nakhonthai/ESP32IGate/doc/ESP32DR_DIY-Thai.pdf

## คู่มือประกอบวงจรชุด ESP32DR Simple

PCB Layout | ขันตอนการประกอบ ให้ทําการประกอบจากอุปกรณ์ทีตําก่อนไปหาตัวทีสูงตามลําดับดังนี

!.ประกอบตัวรีซิสเตอร์ R….
| 2.ประกอบ L Isolate หรือ จัมเปอร์ L1 3.ประกอบไดโอด D1,D2 4.ประกอบคาปาซิเตอร์ C… 5.ประกอบทรานซิสเตอร์ Q1 6.ประกอบ VR RP1,RP2 7.ประกอบแจ็คโมดูล RJ11 8.ประกอบ ESP32 ใส่เป็นขาซ๊อกเก็จแทน

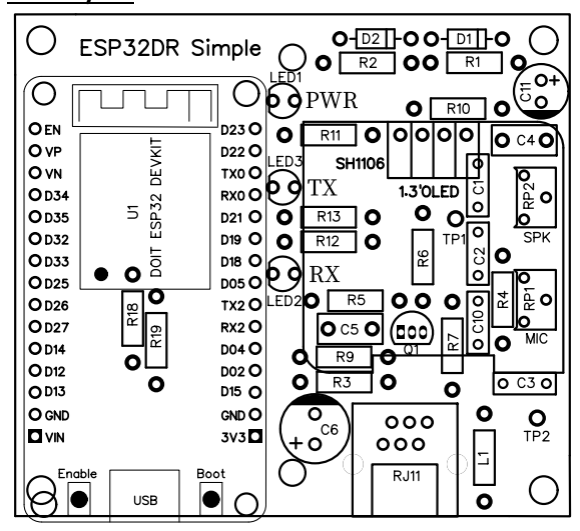
[picture p19: figure]

รายการวัสดุอุปกรณ์ประกอบวงจร(BOM)

ID | Name | Designator | Quantity
1 | DOIT ESP32 DEVKIT (โมดูล ESP32) | U1 | 1
2 | VR 3362W 1K (R ปรับค่าเสียงออก ค่าอ่าน 102) | RP2 | 1
3 | VR 3362W 10K (R ปรับค่าเสียงเข้า ค่าอ่าน 103) | RP1 | 1
4 | RJ11-6P6C (แจ๊คโมดูล RJ11 แบบ 6ขา) | RJ11 | 1
5 | R 1K 1/4W(ค่าสี: นําตาล ดํา แดง) | R13,R12,R11,R5,R3,R9 | 6
6 | R 100R 1/4W(ค่าสี: นําตาล ดํา ดํา) | R7,R18,R19 | 3
7 | R 10k 1/4W (ค่าสี: นําตาล ดํา ส้ม) | R6,R2,R1 | 3
8 | R 3k 1/4W (ค่าสี: ส้ม ดํา แดง) | R4 | 1
9 | R 33K 1/4W (ค่าสี: ส้ม ส้ม ส้ม) | R10 | 1
10 | 2N3904(TO-92) | Q1 | 1
11 | LED 3.5mm สีเหลือง แสดงส่งสัญญาณ TX | LED3 | 1
12 | LED 3.5mm สีเขียว แสดงรับสัญญาณ RX | LED2 | 1
13 | LED 3.5mm สีแดง แสดงไฟเข้าทํางาน PWR | LED1 | 1
14 | L Isolate or Jumper | L1 | 1
15 | C 100uF/16V (ตัวเก็บประจุแบบอิเล็กโทรไลติก) | C11 | 1
16 | C 100nF (ตัวเก็บประจุแบบเซรามิกมัลติเลเยอร์) | C4,C5 | 2
17 | C 470uF/16V (ตัวเก็บประจุแบบอิเล็กโทรไลติก) | C6 | 1
18 | C 0.1uF (ตัวเก็บประจุแบบโพลีโพรไพลีน) | C1,C3,C10 | 3
19 | C 10nF (ตัวเก็บประจุแบบโพลีโพรไพลีน) | C2 | 1
20 | Diode 1N4148 หรือใช้ C 10nF แทนได้ | D2,D1 | 2
*หากต่อเข้ากับวิทยุทีใช้เสียงเข้าขาไมค์ของวิทยุรับส่ง ให้เปลี | ยน R4 จาก 3K เป็น 100K
ดาวน์โหลดซอร ์สโค๊ดสําหรับการแก้ไขและพัฒนาได้ทีลิ$ งค์ https://github.com/nakhonthai/ESP32IGate ดาวน์โหลดเฟิ ร ์มแวร ์เวอร ์ชั$นสมบูรณ์ได้ทีลิ$ งค์ https://github.com/nakhonthai/ESP32IGate/releases การตังค่า เชื$อมต่อไวไฟ SSID: ESP32IGate รหัสผ่าน aprsthnetwork เข้าเว็บคอนฟิ กซ์ด้วยไอพี http://192.168.4.1

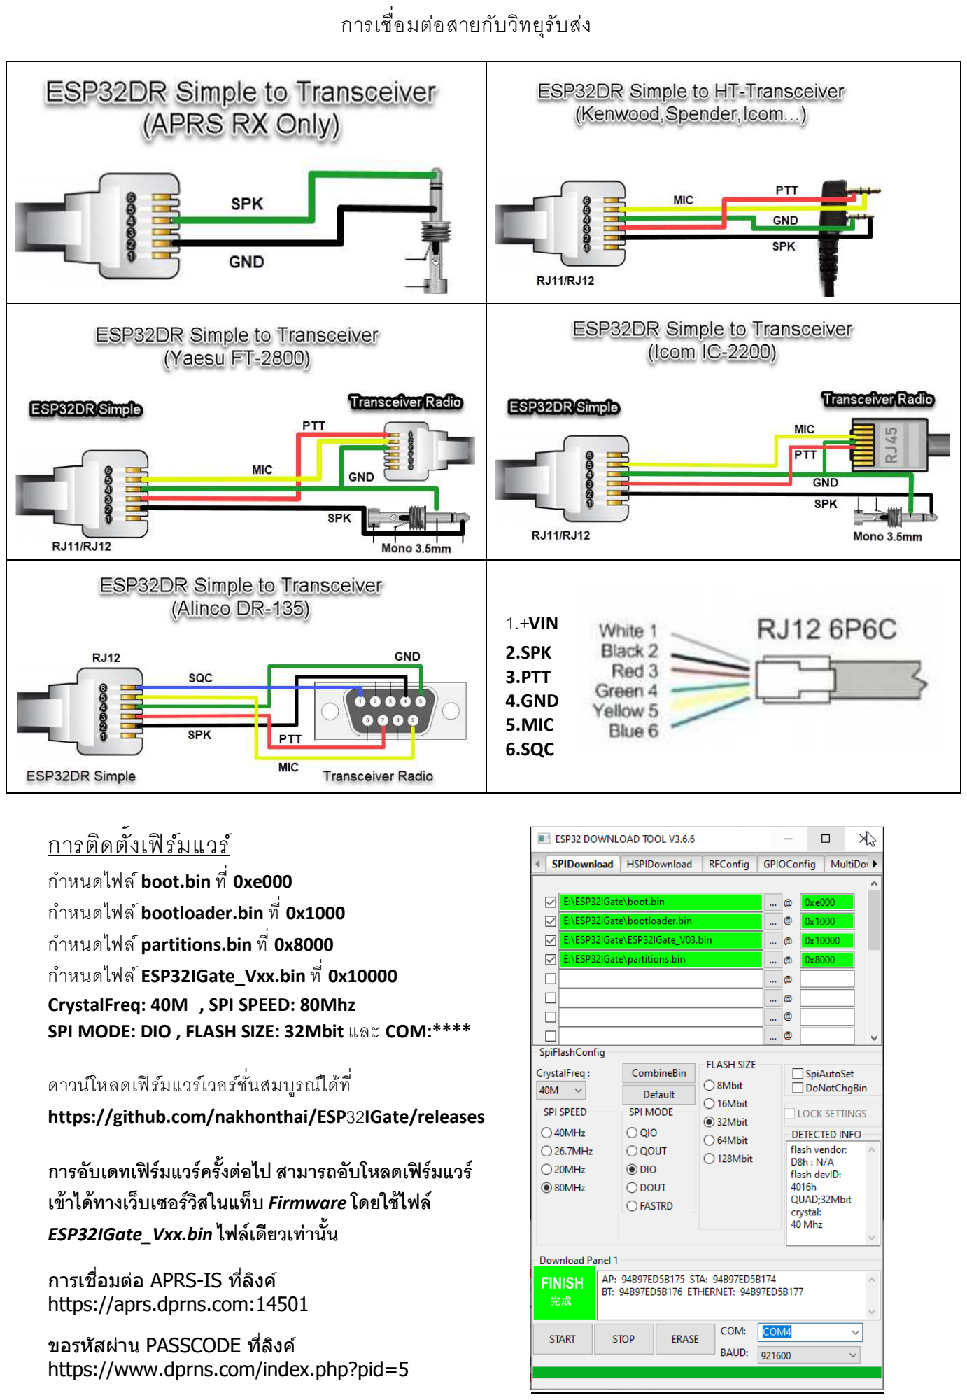
[picture p20: page 2]

การเชื$อมต่อสายกับวิทยุรับส่ง

1.+VIN

2.SPK
3.PTT
4.GND
5.MIC
6.SQC

### การติดตังเฟิ ร ์มแวร ์

กําหนดไฟล์ boot.bin ที$ 0xe000 กําหนดไฟล์ bootloader.bin ที$ 0x1000

กําหนดไฟล์ partitions.bin ที$ 0x8000

กําหนดไฟล์ ESP32IGate_Vxx.bin ที$ 0x10000

CrystalFreq: 40M , SPI SPEED: 80Mhz
SPI MODE: DIO , FLASH SIZE: 32Mbit และ COM:****

ดาวน์โหลดเฟิ ร ์มแวร ์เวอร ์ชั$นสมบูรณ์ได้ที$

https://github.com/nakhonthai/ESP32IGate/releases

การอับเดทเฟิ ร์มแวร์ครังต่อไป สามารถอับโหลดเฟิ ร์มแวร์ เข้าได้ทางเว็บเซอร์วิสในแท็บ Firmware โดยใช้ไฟล์

ESP32IGate_Vxx.bin ไฟล์เดียวเท่านัน

การเชอมต่อ APRS-IS ทีลิงค์ ื https://aprs.dprns.com:14501

ขอรหัสผ่าน PASSCODE ทีลิงค์ https://www.dprns.com/index.php?pid=5
