nakhonthai/ESP32IGate/doc/ESP32DR_SA868/ESP32DR_Harmonics.png

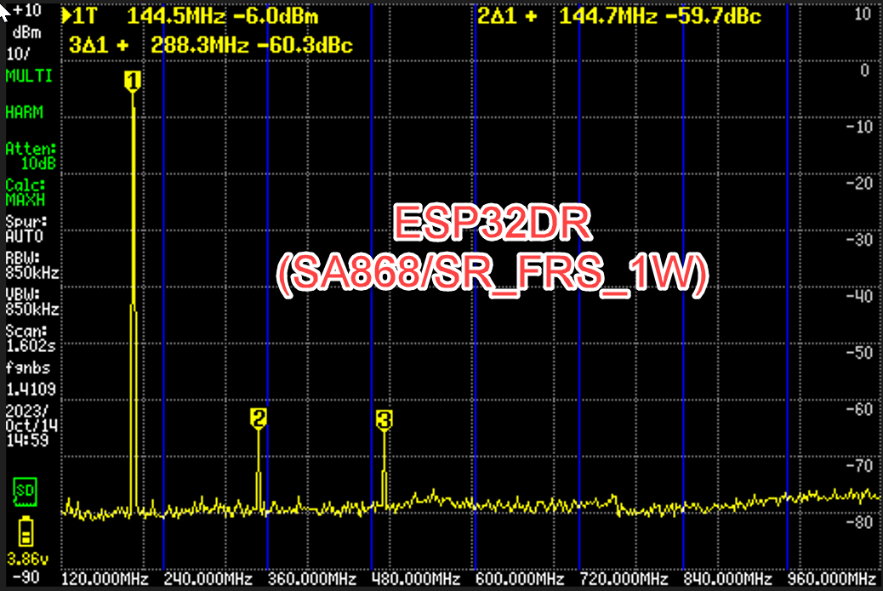
doc/ESP32DR_SA868/ESP32DR_Harmonics.png
