nakhonthai/ESP32IGate/doc/ESP32DR_SA868/ESP32DR_SA868.jpg

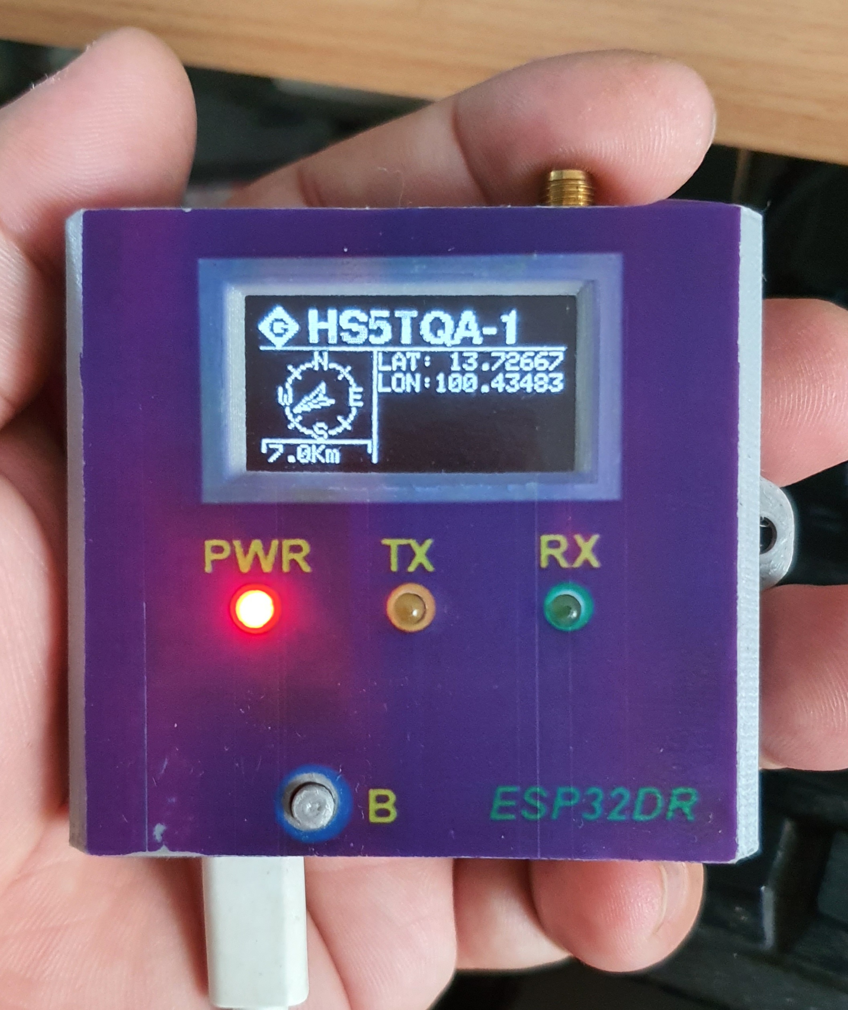
doc/ESP32DR_SA868/ESP32DR_SA868.jpg
