nakhonthai/ESP32IGate/image/Alinco_Pinout.png

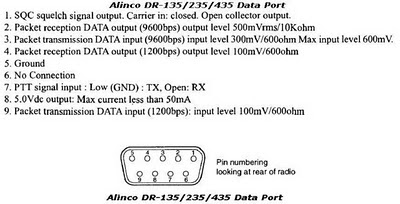
image/Alinco_Pinout.png
