nakhonthai/ESP32IGate/image/ESP32IGate_GNSS.jpg

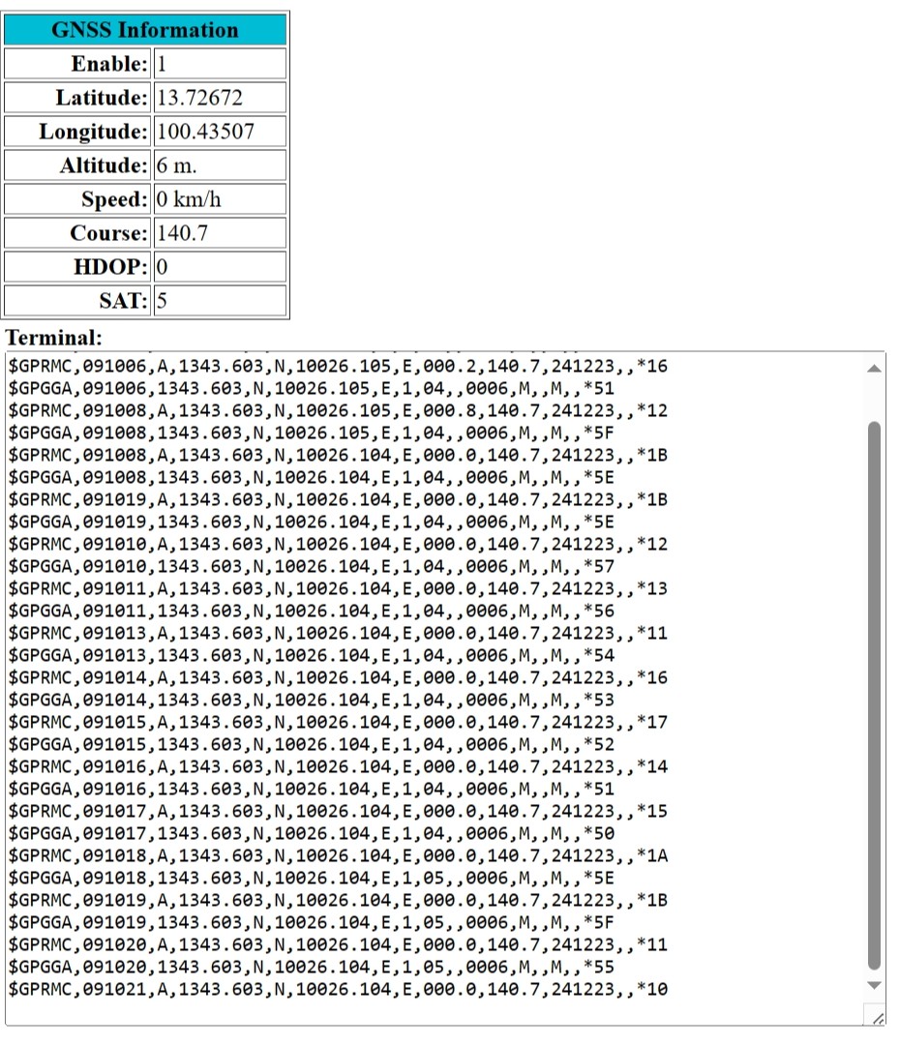
image/ESP32IGate_GNSS.jpg
