nakhonthai/ESP32IGate/image/ESP32IGate_gnss_connection.png

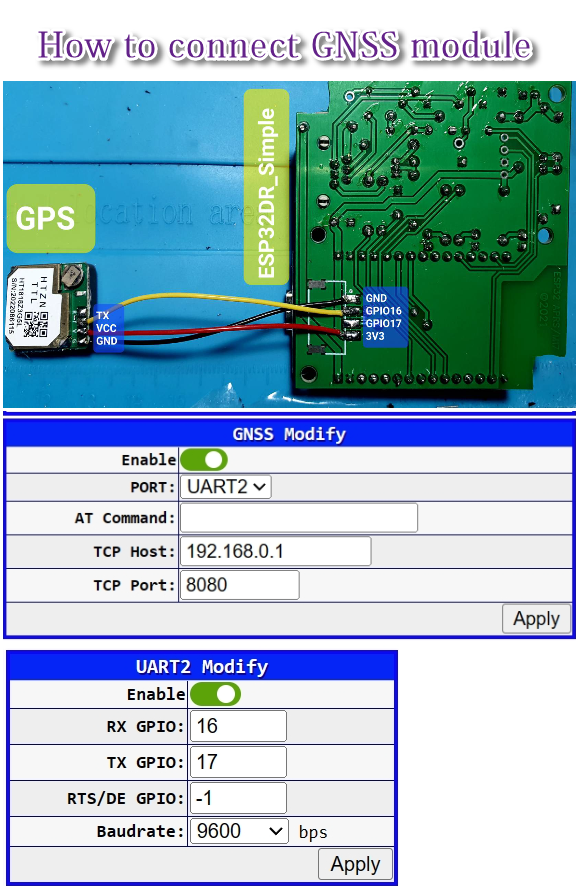
image/ESP32IGate_gnss_connection.png
