nakhonthai/ESP32IGate/image/ESP32IGate_gnss_tcp.png

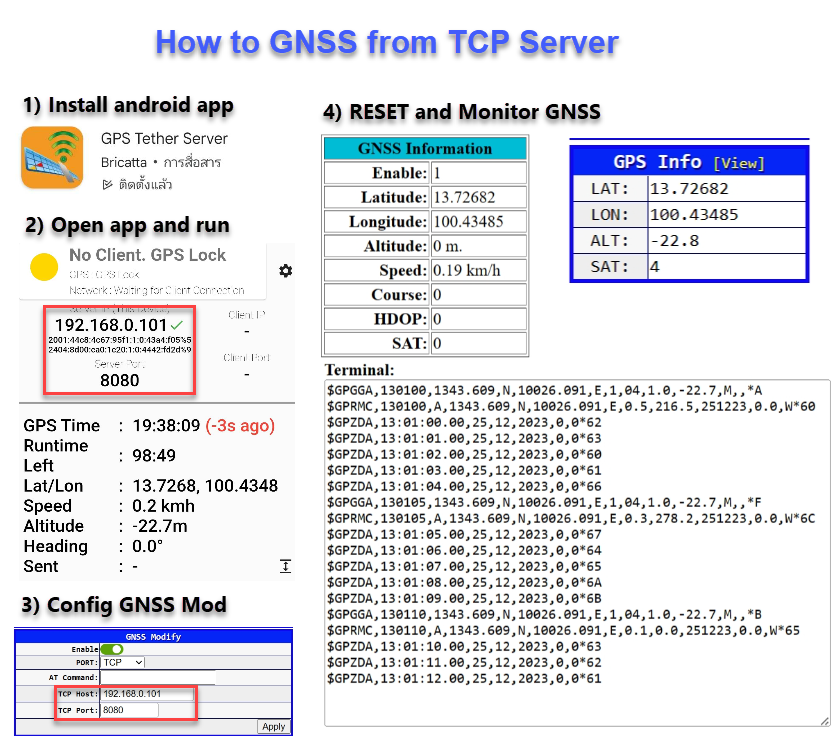
image/ESP32IGate_gnss_tcp.png
