nakhonthai/ESP32IGate/image/ESP32IGATE_SA818_3D.png

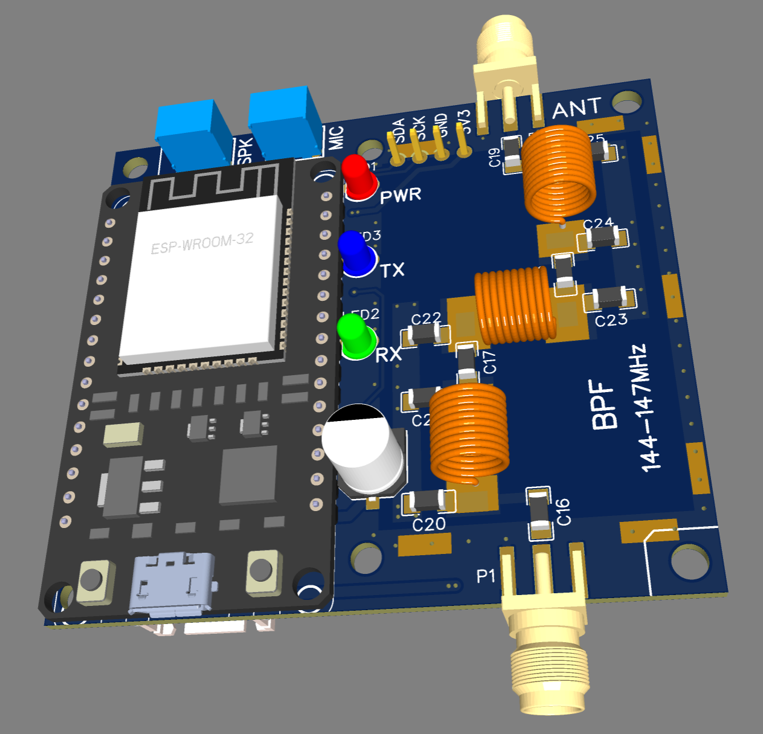
image/ESP32IGATE_SA818_3D.png
