nakhonthai/ESP32IGate/image/ESP32IGate_Screen_about.png

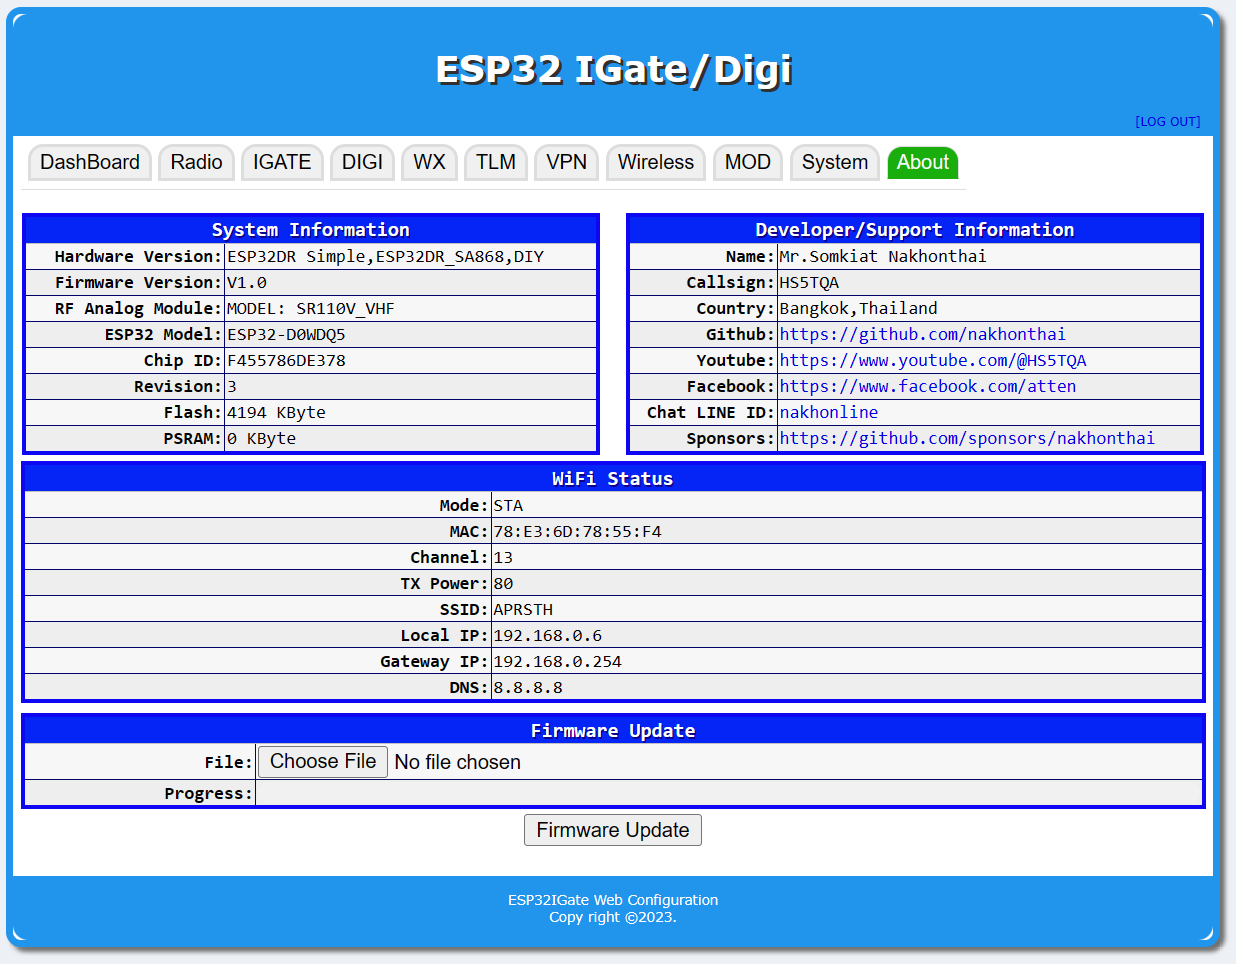
image/ESP32IGate_Screen_about.png
