nakhonthai/ESP32IGate/image/ESP32IGate_Screen_digi.png

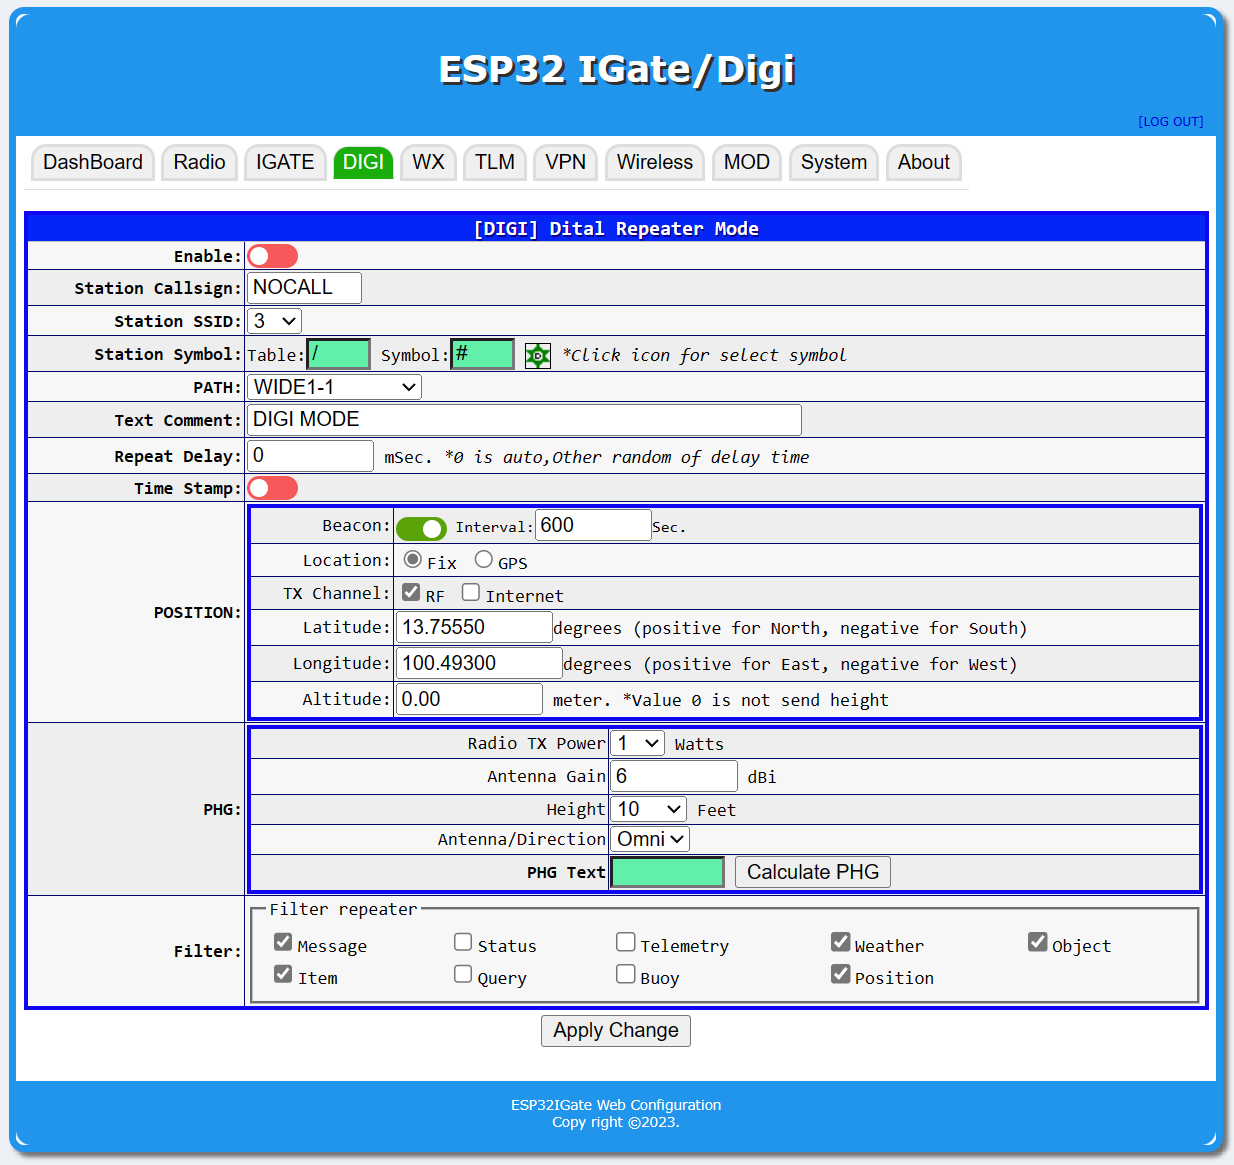
image/ESP32IGate_Screen_digi.png
