nakhonthai/ESP32IGate/image/ESP32IGate_Screen_system.png

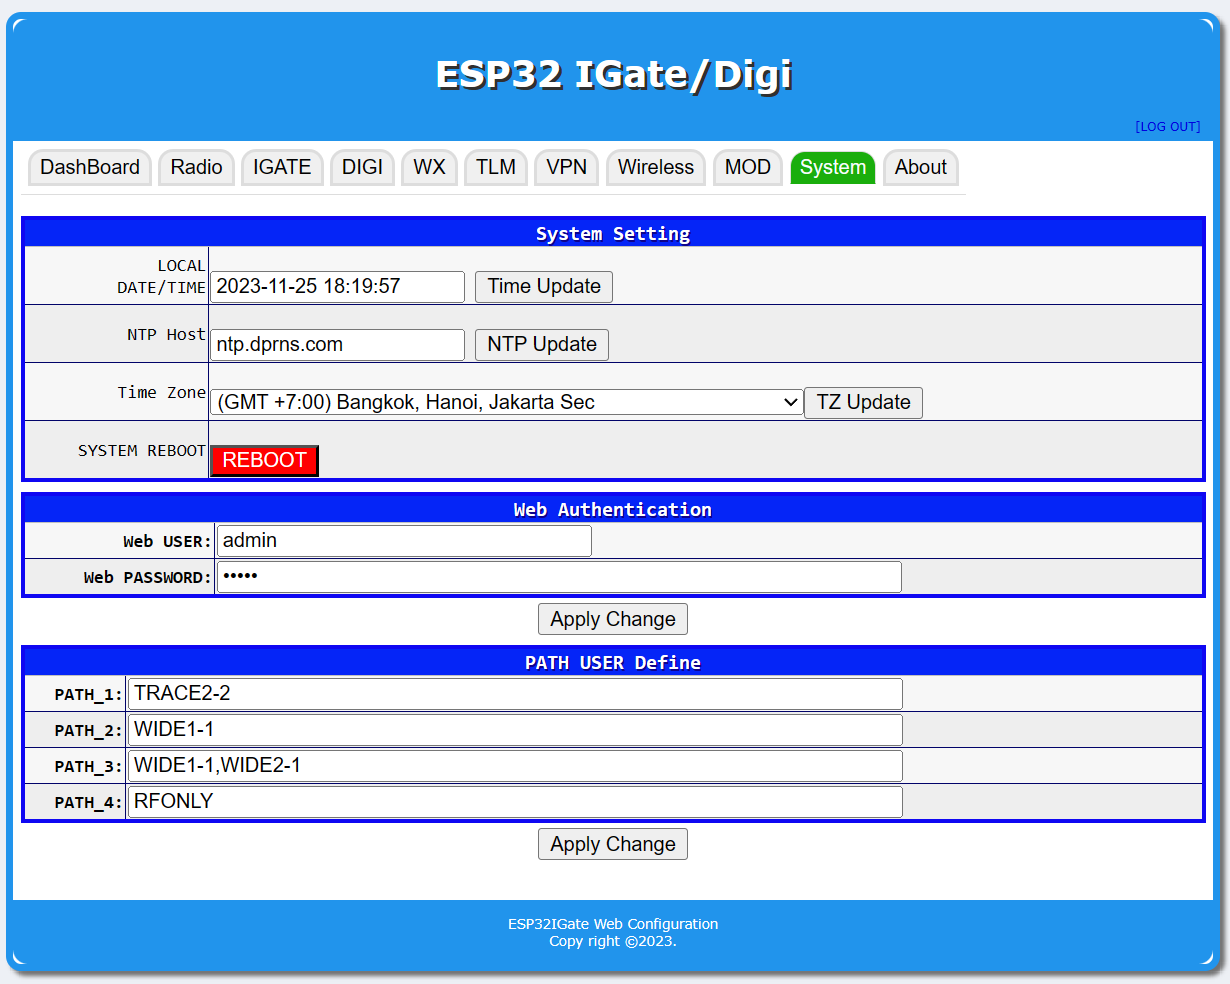
image/ESP32IGate_Screen_system.png
