nakhonthai/ESP32IGate/image/ESP32IGate_Screen_tlm.png

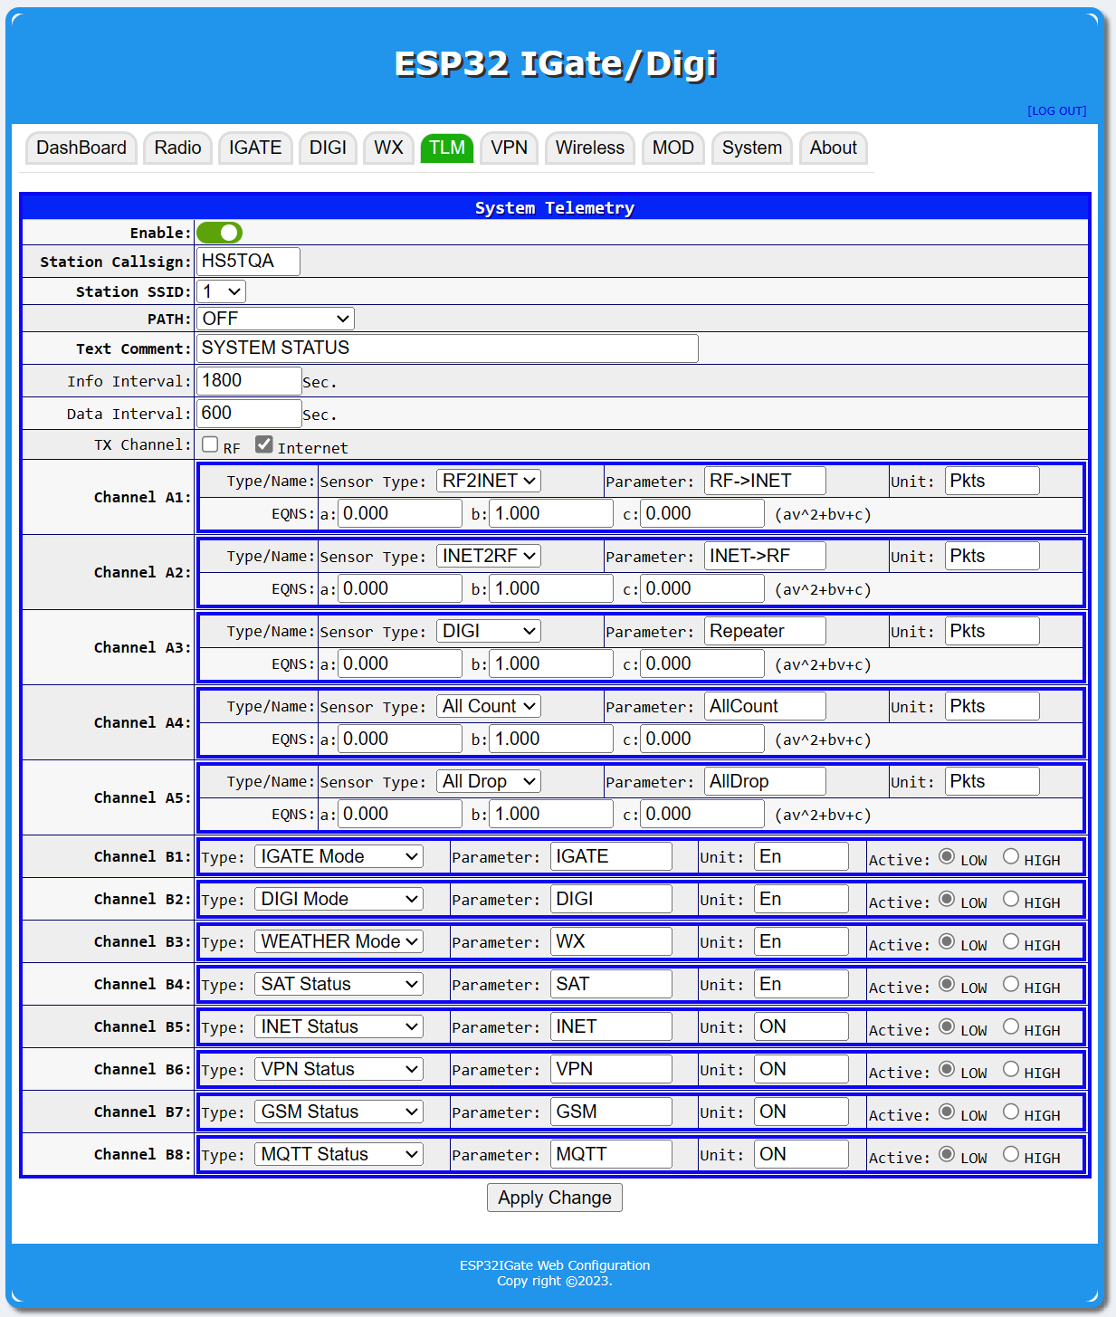
image/ESP32IGate_Screen_tlm.png
