nakhonthai/ESP32IGate/image/ESP32IGate_Screen_tnc2.png

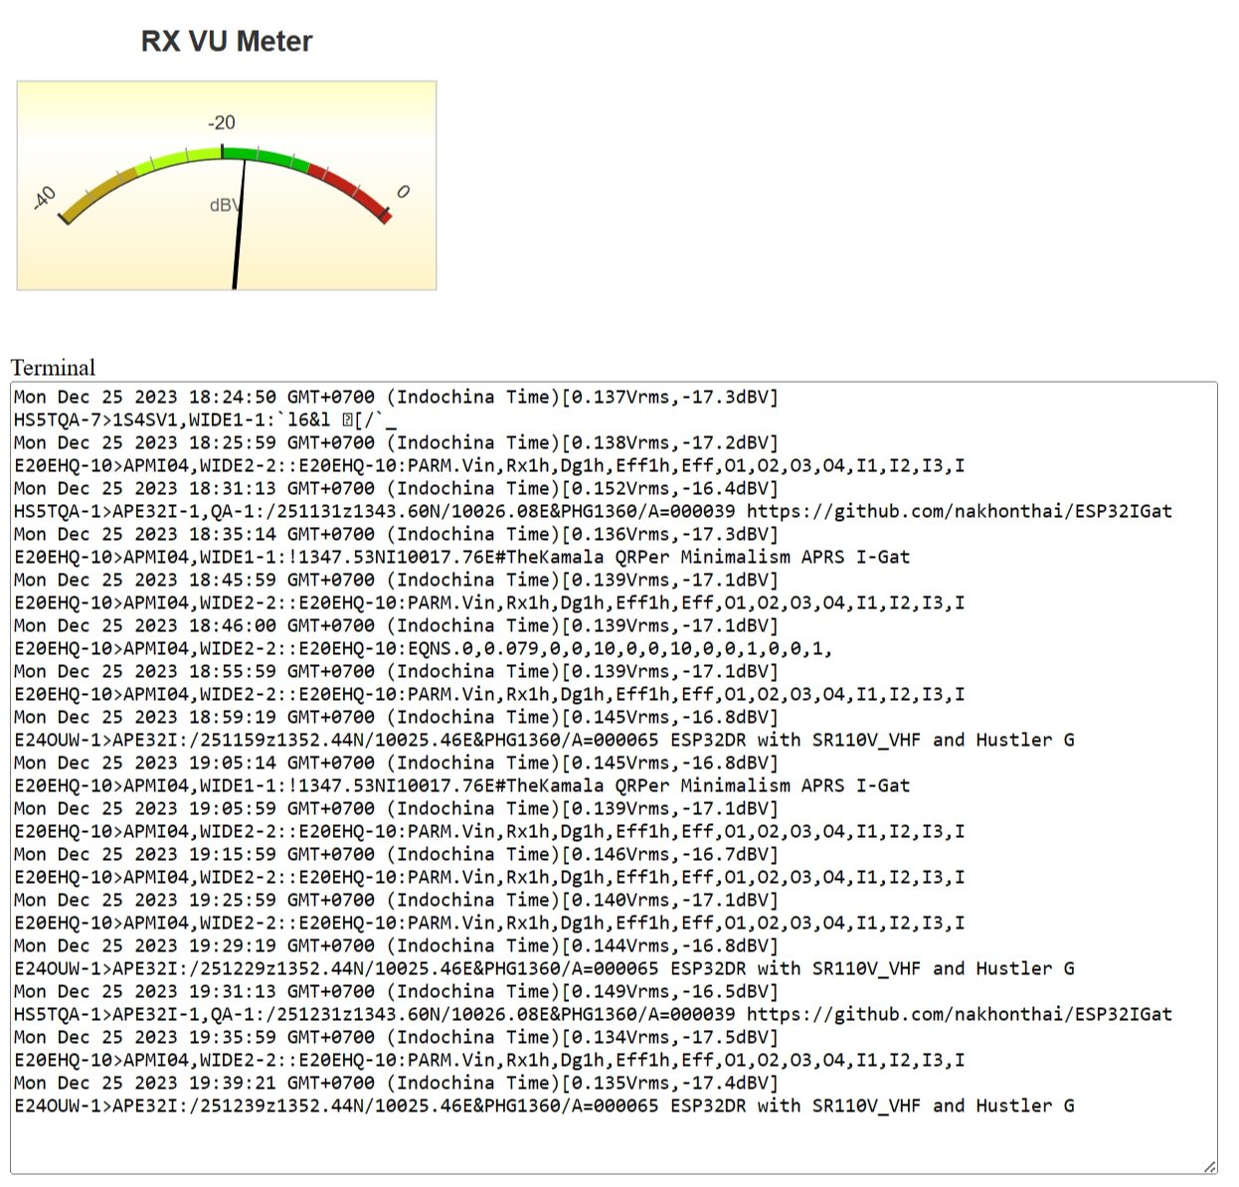
image/ESP32IGate_Screen_tnc2.png
