nakhonthai/ESP32IGate/image/ESP32IGate_Screen_wifi.png

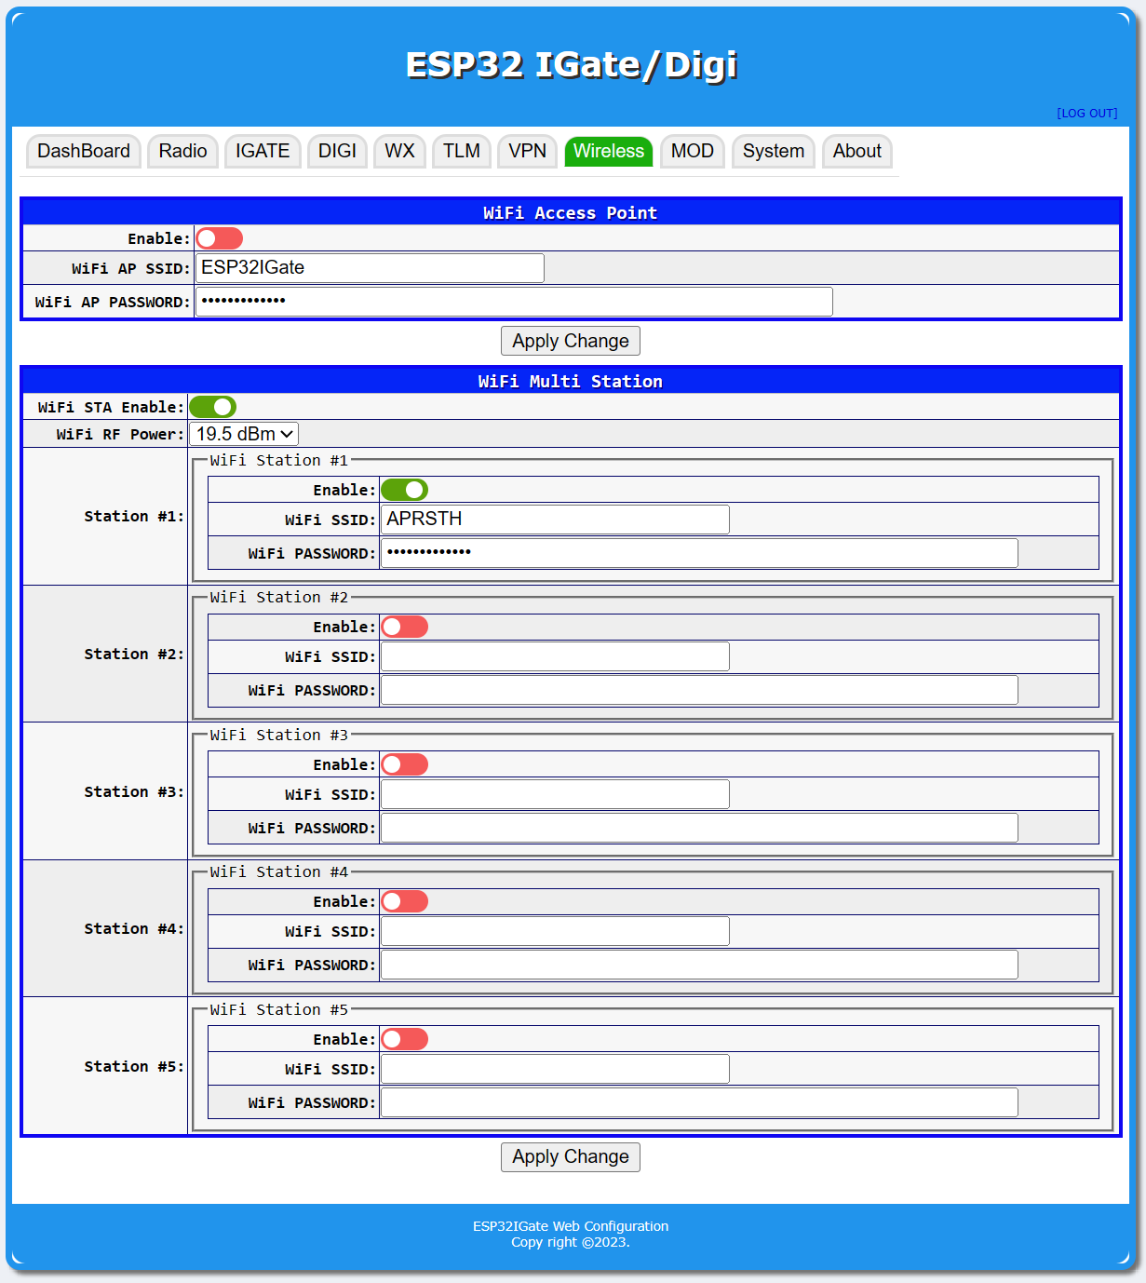
image/ESP32IGate_Screen_wifi.png
