nakhonthai/ESP32IGate/image/PCB_Layout.png

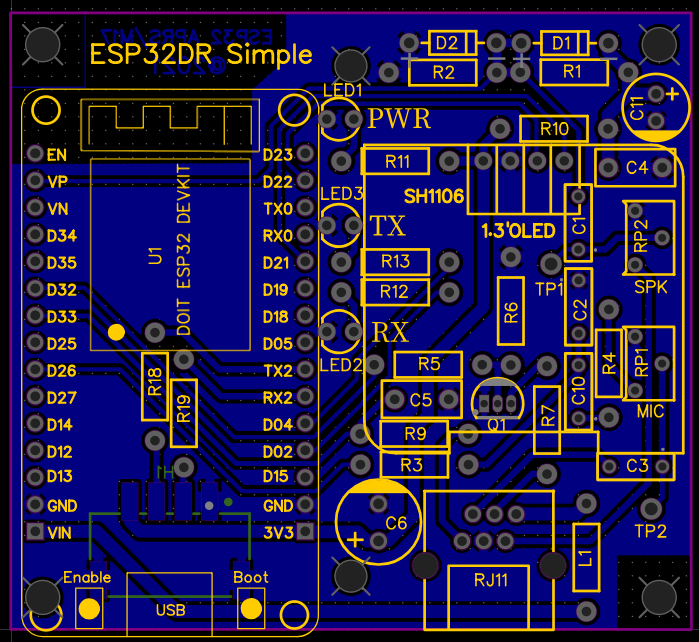
image/PCB_Layout.png
