nakhonthai/ESP32IGate/image/RJ12.png

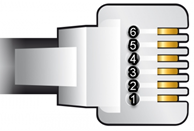
image/RJ12.png
