nakhonthai/ESP32IGate/doc/ESP32DR_Simple_Schematic.pdf

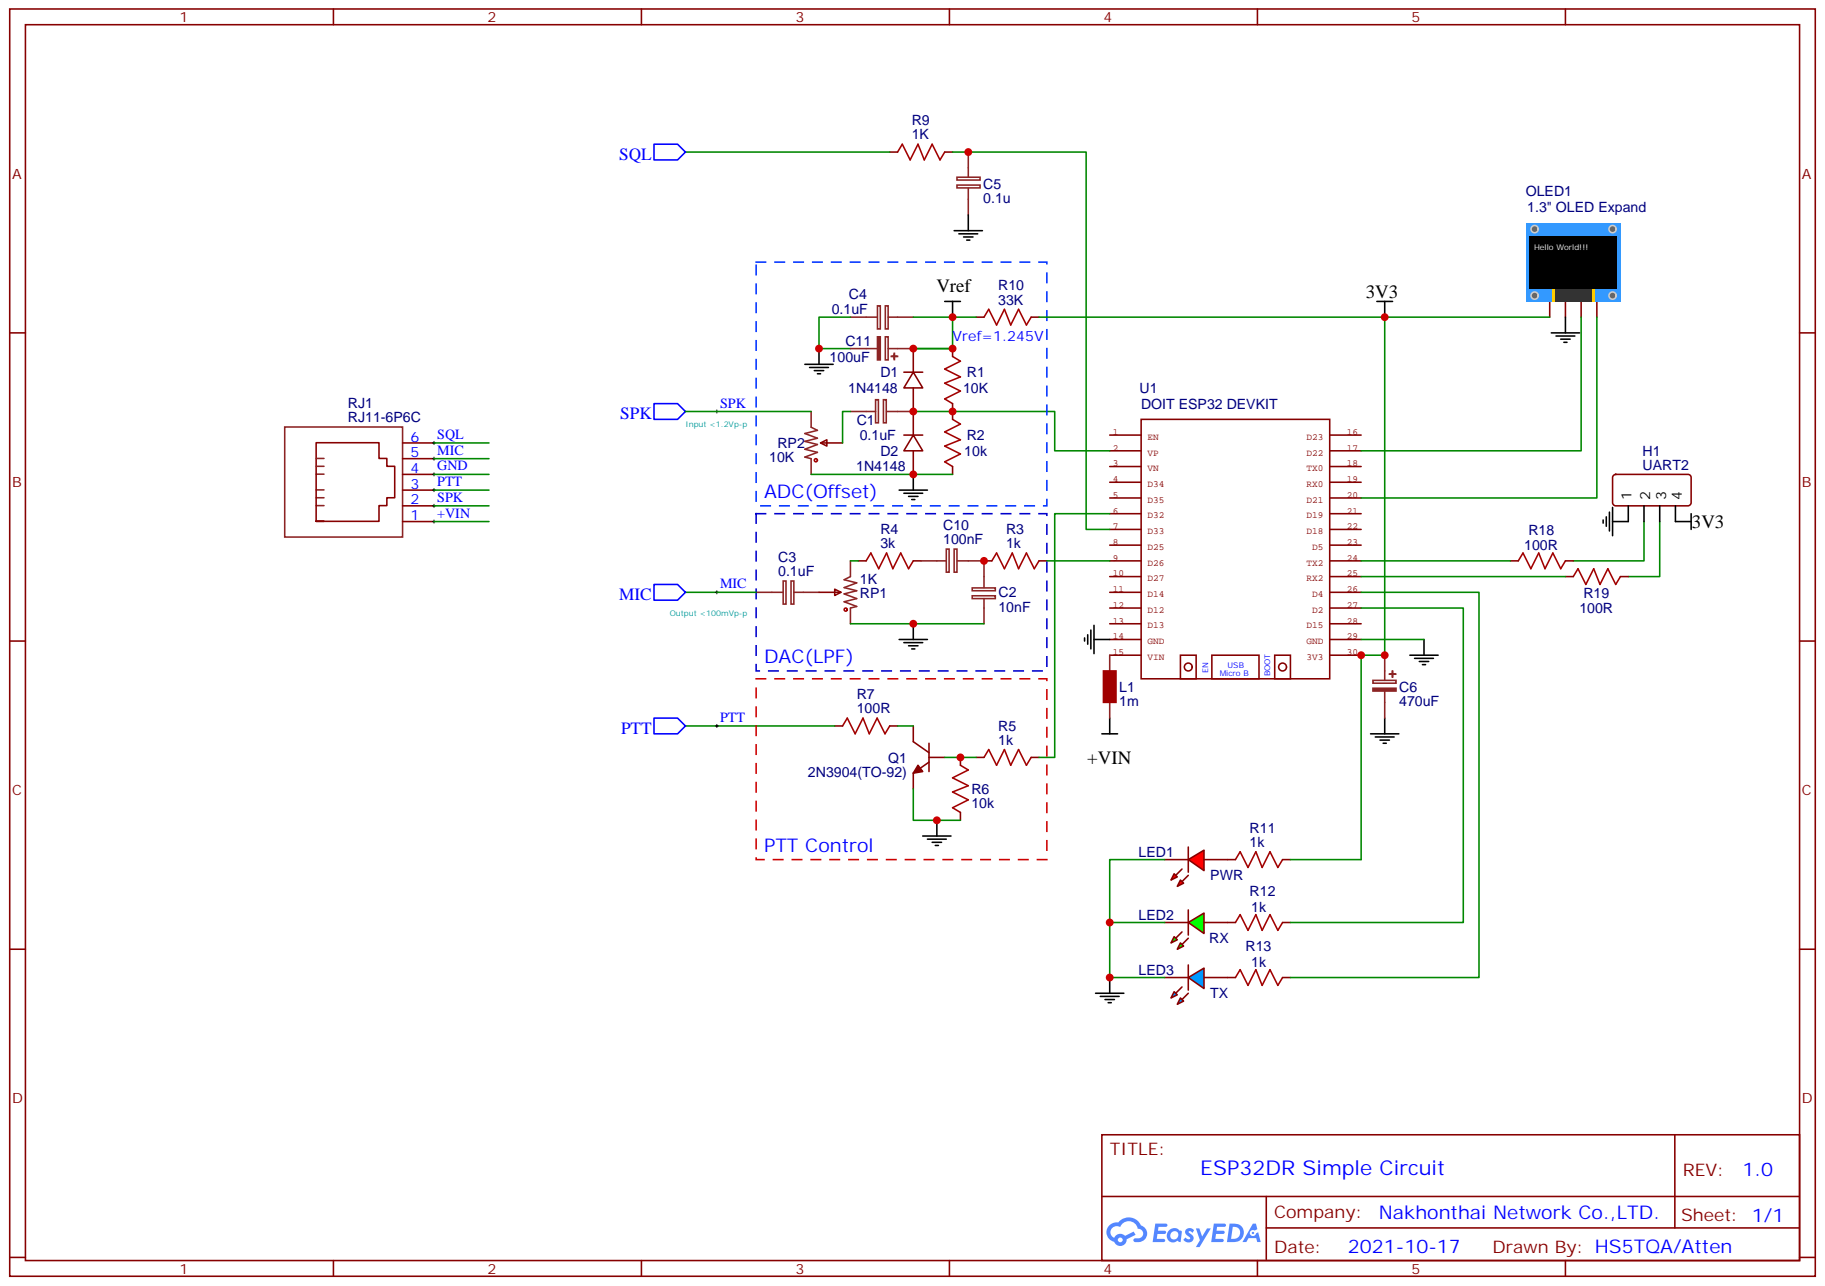
[picture p36: page 1]

Company: Nakhonthai Network Co.,LTD.
