nakhonthai/ESP32IGate/doc/PCB_Bottom.pdf

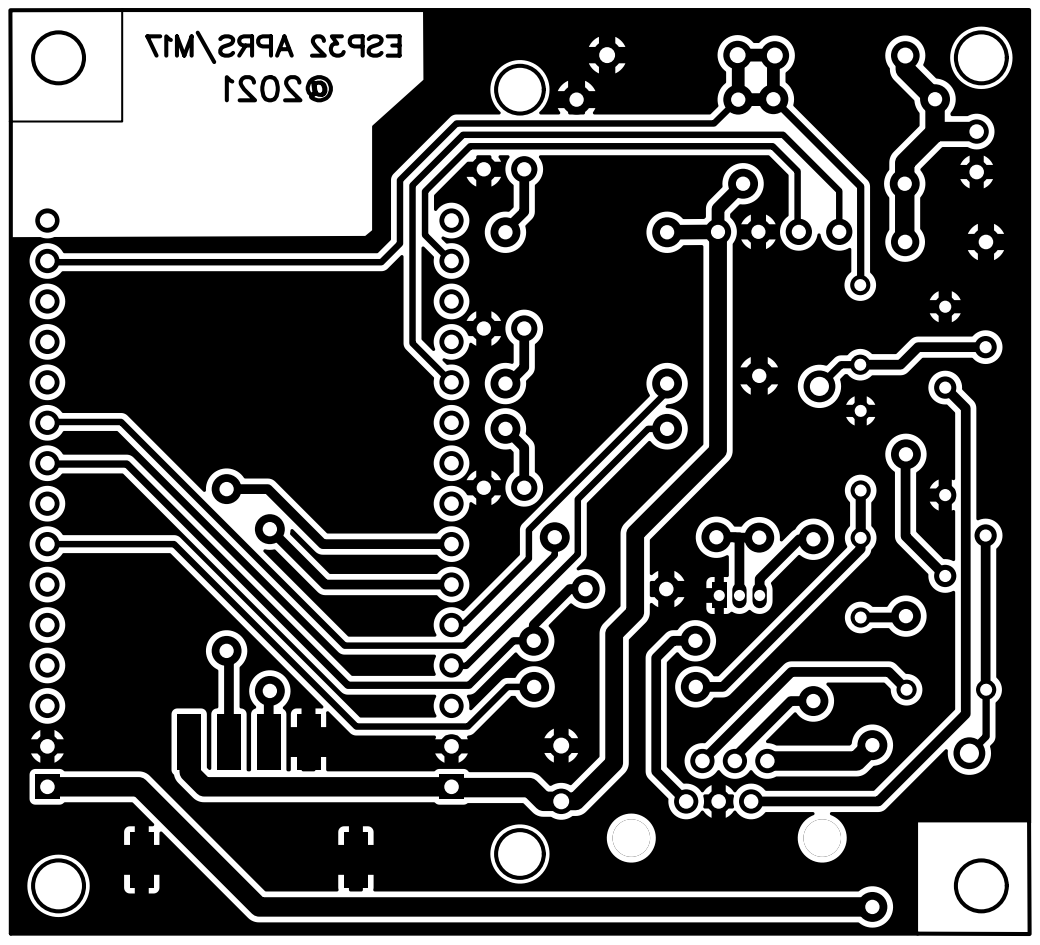
[picture p37: page 1]
