nakhonthai/ESP32IGate/doc/PCB_Bottom_Invert.pdf

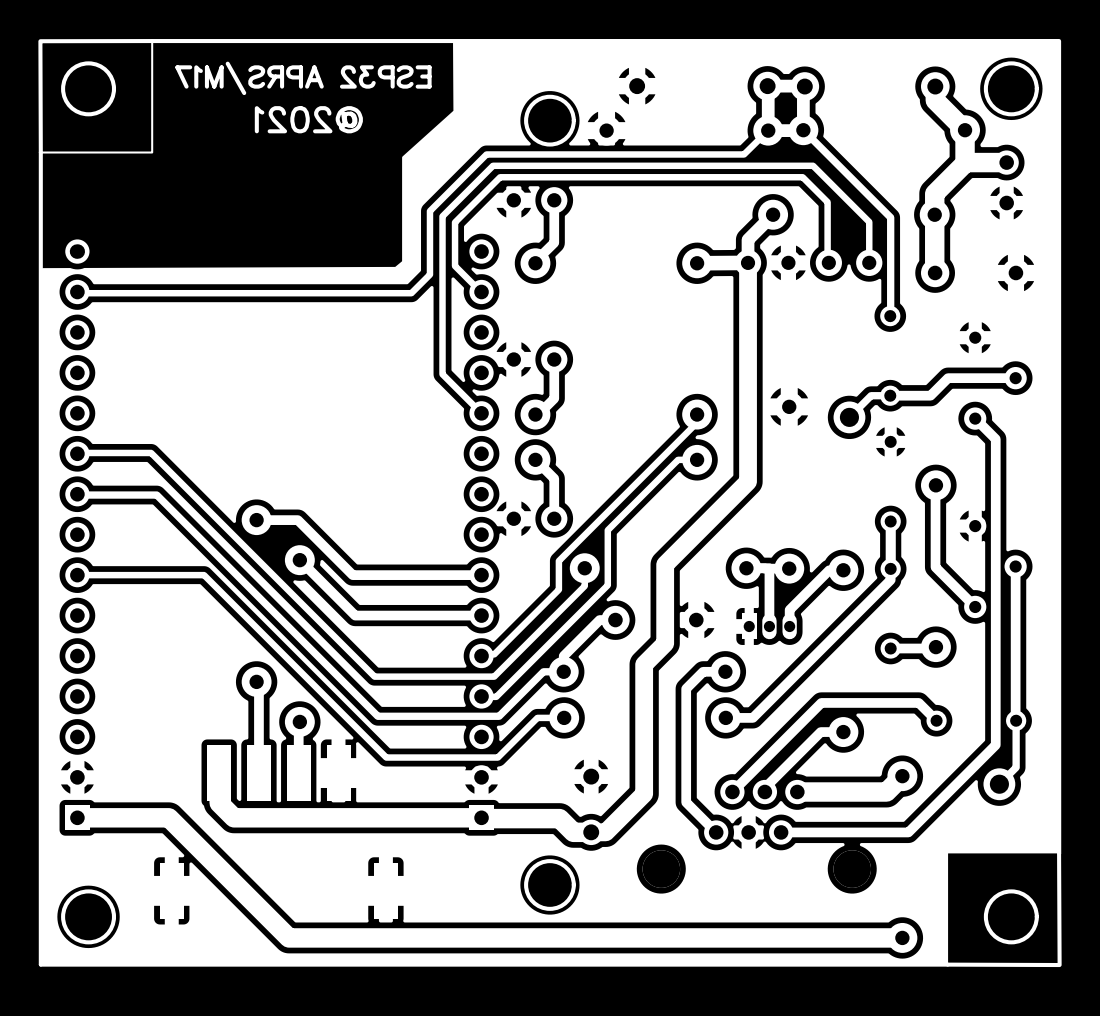
[picture p38: page 1]
