nakhonthai/ESP32IGate/doc/PCB_Layout.pdf

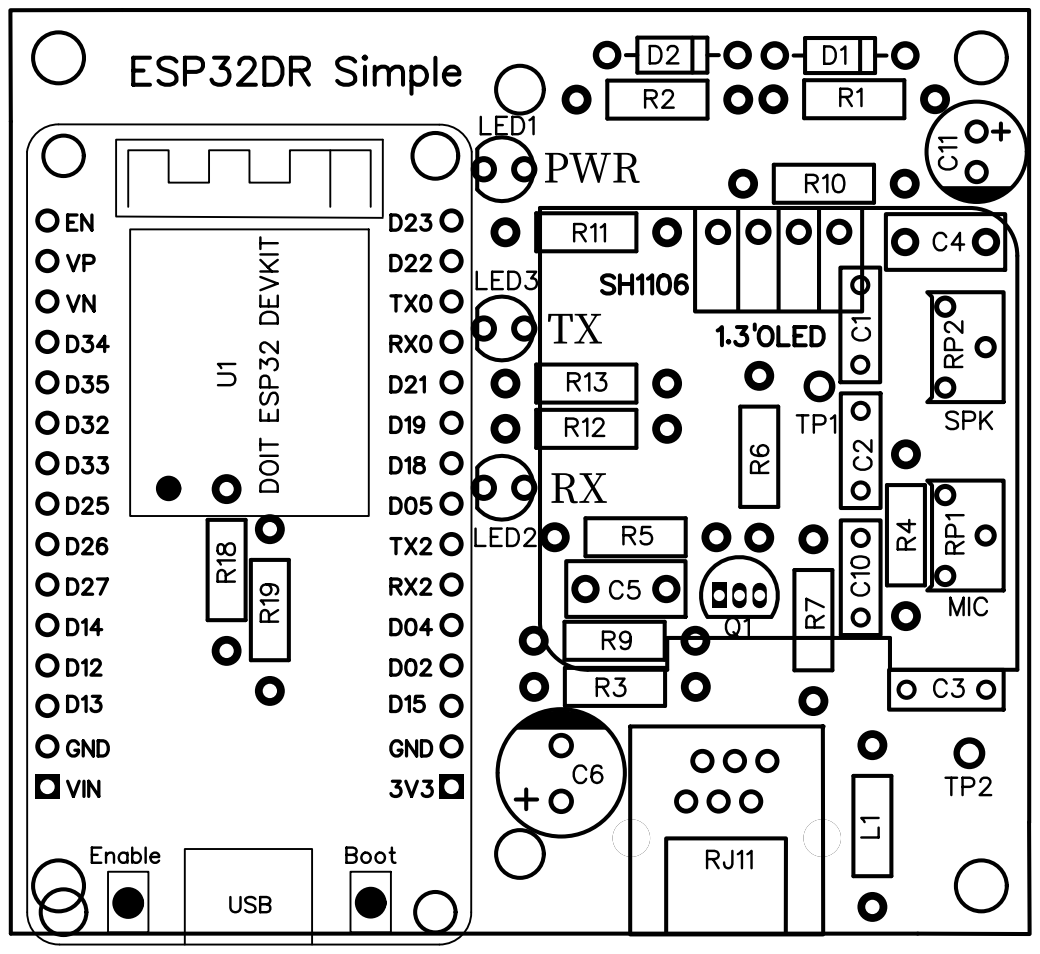
[picture p39: page 1]
