nakhonthai/ESP32IGate/doc/ESP32DR_SA868/ESP32DR_SA868_sch.pdf

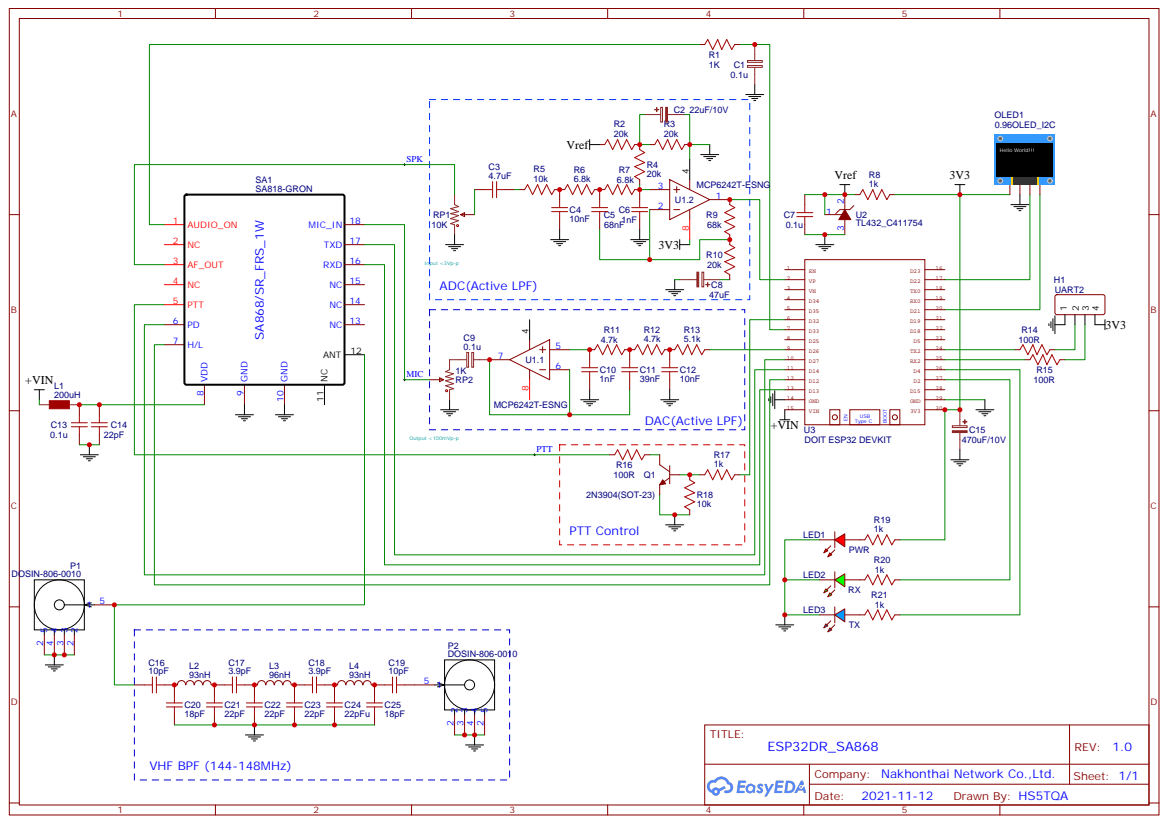
[picture p40: page 1]

Company: Nakhonthai Network Co.,Ltd.
