nakhonthai/ESP32IGate/include/main.h

/*
 Name:		ESP32 APRS Internet Gateway
 Created:	1-Nov-2021 14:27:23
 Author:	HS5TQA/Atten
 Github:	https://github.com/nakhonthai
 Facebook:	https://www.facebook.com/atten
 Support IS: host:aprs.dprns.com port:14580 or aprs.hs5tqa.ampr.org:14580
 Support IS monitor: http://aprs.dprns.com:14501 or http://aprs.hs5tqa.ampr.org:14501
*/

#ifndef MAIN_H
#define MAIN_H

#define VERSION "1.3"
#define VERSION_BUILD 'a'

#define WX

//#define OLED
//#define SDCARD
//#define BLUETOOTH

#define WIFI_OFF_FIX 0
#define WIFI_AP_FIX 1
#define WIFI_STA_FIX 2
#define WIFI_AP_STA_FIX 3

#define IMPLEMENTATION FIFO

#define TZ 0	 // (utc+) TZ in hours
#define DST_MN 0 // use 60mn for summer time in some countries
#define TZ_MN ((TZ) * 60)
#define TZ_SEC ((TZ) * 3600)
#define DST_SEC ((DST_MN) * 60)

#define FORMAT_SPIFFS_IF_FAILED true

#ifdef BOARD_HAS_PSRAM
#define TLMLISTSIZE 10
#define PKGLISTSIZE 100
#define PKGTXSIZE 100
#else
#define TLMLISTSIZE 10
#define PKGLISTSIZE 20
#define PKGTXSIZE 5
#endif

#define FILTER_ALL 0				// Packet is disable all packet
#define FILTER_OBJECT (1 << 0)		// packet is an object
#define FILTER_ITEM (1 << 1)		// packet is an item
#define FILTER_MESSAGE (1 << 2)		// packet is a message
#define FILTER_WX (1 << 3)			// packet is WX data
#define FILTER_TELEMETRY (1 << 4)	// packet is telemetry
#define FILTER_QUERY (1 << 5)		// packet is a query
#define FILTER_STATUS (1 << 6)		// packet is status
#define FILTER_POSITION (1 << 7)	// packet is postion
#define FILTER_BUOY (1 << 8)		// packet is buoy
#define FILTER_MICE (1 << 9)		// packet is MIC-E
#define FILTER_THIRDPARTY (1 << 10) // packet is 3rd-party packet from INET2RF

#define RF_NONE 0
#define RF_SA868_VHF 1 // G-NiceRF SA818,SA868 VHF band 134~174 MHz
#define RF_SA868_UHF 2 // G-NiceRF SA818,SA868 UHF band 400~470 MHz
#define RF_SA868_350 3 // G-NiceRF SA818,SA868 350 band frequency：320-400MHz
#define RF_SR_1WV 4	   // SUNRISE SR110V,FRS-1WV VHF band 136~174 MHz
#define RF_SR_1WU 5	   // SUNRISE SR110U,FRS-1WU UHF band 400~470 MHz
#define RF_SR_1W350 6  // SUNRISE SR350P 350 band frequency：350-390MHz
#define RF_SR_2WVS 7   // SUNRISE SR120V,SR_2WVS VHF band 136~174 MHz
#define RF_SR_2WUS 8   // SUNRISE SR120U,SR_2WUS UHF band 400~470 MHz

#define TXCH_TCP 0
#define TXCH_RF 1
#define TXCH_DIGI 2
#define TXCH_3PTY 3

#include <Arduino.h>
#include <FS.h>
#include <SD.h>
#include <SPIFFS.h>
#include "soc/rtc_wdt.h"
#include <AX25.h>
#include "weather.h"

#include "HardwareSerial.h"
#include "EEPROM.h"
typedef struct wifi_struct
{
	bool enable;
	char wifi_ssid[32];
	char wifi_pass[63];
} wifiSTA;

typedef struct Config_Struct
{
	float timeZone;
	bool synctime;
	bool title;

	// WiFi/BT/RF
	char wifi_mode; // WIFI_AP,WIFI_STA,WIFI_AP_STA,WIFI_OFF
	int8_t wifi_power;
	//--WiFi Client
	wifiSTA wifi_sta[5];
	// bool wifi_client;
	// char wifi_ssid[32];
	// char wifi_pass[63];
	//--WiFi AP
	// bool wifi_ap;
	char wifi_ap_ch;
	char wifi_ap_ssid[32];
	char wifi_ap_pass[63];

	//--RF Module
	bool rf_en;
	uint8_t rf_type;
	float freq_rx;
	float freq_tx;
	int offset_rx;
	int offset_tx;
	int tone_rx;
	int tone_tx;
	uint8_t band;
	uint8_t sql_level;
	bool rf_power;
	uint8_t volume;
	uint8_t mic;

	// IGATE
	bool igate_en;
	bool rf2inet;
	bool inet2rf;
	bool igate_loc2rf;
	bool igate_loc2inet;
	uint16_t rf2inetFilter;
	uint16_t inet2rfFilter;
	//--APRS-IS
	uint8_t aprs_ssid;
	uint16_t aprs_port;
	char aprs_mycall[10];
	char aprs_host[20];
	char aprs_passcode[6];
	char aprs_moniCall[10];
	char aprs_filter[30];
	//--Position
	bool igate_bcn;
	bool igate_gps;
	bool igate_timestamp;
	float igate_lat;
	float igate_lon;
	float igate_alt;
	uint16_t igate_interval;
	char igate_symbol[3] = "N&";
	char igate_object[10];
	char igate_phg[8];
	uint8_t igate_path;
	char igate_comment[50];
	//--Filter

	// DIGI REPEATER
	bool digi_en;
	bool digi_loc2rf;
	bool digi_loc2inet;
	bool digi_timestamp;
	uint8_t digi_ssid;
	char digi_mycall[10];
	uint8_t digi_path;
	uint16_t digi_delay; // ms
	uint16_t digiFilter;
	//--Position
	bool digi_bcn;
	bool digi_compress = false;
	bool digi_altitude = false;
	bool digi_gps;
	float digi_lat;
	float digi_lon;
	float digi_alt;
	uint16_t digi_interval;
	char digi_symbol[3] = "N&";
	char digi_phg[8];
	char digi_comment[50];

// TRACKER
	bool trk_en;
	bool trk_loc2rf;
	bool trk_loc2inet;
	bool trk_timestamp;
	uint8_t trk_ssid;
	char trk_mycall[10];
	uint8_t trk_path;
	//--Position
	bool trk_gps;
	float trk_lat;
	float trk_lon;
	float trk_alt;
	uint16_t trk_interval = 60;
	bool trk_smartbeacon = false;
	bool trk_compress = false;
	bool trk_altitude = false;
	bool trk_cst = false;
	bool trk_bat = false;
	bool trk_sat = false;
	bool trk_dx = false;
	uint16_t trk_hspeed = 120;
	uint8_t trk_lspeed = 2;
	uint8_t trk_maxinterval = 15;
	uint8_t trk_mininterval = 5;
	uint8_t trk_minangle = 25;
	uint16_t trk_slowinterval = 600;
	char trk_symbol[3] = "\\>";
	char trk_symmove[3] = "/>";
	char trk_symstop[3] = "\\>";
	// char trk_btext[17] = "";
	char trk_comment[50];
	char trk_item[10] = "";

	// WX
	bool wx_en;
	bool wx_2rf;
	bool wx_2inet;
	bool wx_timestamp;
	uint8_t wx_ssid;
	char wx_mycall[10];
	uint8_t wx_path;
	bool wx_gps;
	float wx_lat;
	float wx_lon;
	float wx_alt;
	uint16_t wx_interval;
	int8_t wx_channel = 0;
	uint8_t wx_type[32]; //Sensor number 32
	uint32_t wx_flage;
	char wx_object[10];
	char wx_comment[50];

	// Telemetry 0
	bool tlm0_en;
	bool tlm0_2rf;
	bool tlm0_2inet;
	uint8_t tlm0_ssid;
	char tlm0_mycall[10];
	uint8_t tlm0_path;
	uint16_t tlm0_data_interval;
	uint16_t tlm0_info_interval;
	char tlm0_PARM[13][10];
	char tlm0_UNIT[13][8];
	float tlm0_EQNS[5][3];
	uint8_t tlm0_BITS_Active;	
	char tlm0_comment[50];
	uint8_t tml0_data_channel[13];

	// Telemetry 1
	bool tlm1_en;
	bool tlm1_2rf;
	bool tlm1_2inet;
	uint8_t tlm1_ssid;
	char tlm1_mycall[10];
	uint8_t tlm1_path;
	uint16_t tlm1_data_interval;
	uint16_t tlm1_info_interval;
	char tlm1_PARM[13][10];
	char tlm1_UNIT[13][8];
	float tlm1_EQNS[5][3];
	uint8_t tlm1_BITS_Active;	
	char tlm1_comment[50];
	uint8_t tml1_data_channel[13];

	// OLED DISPLAY
	bool oled_enable;
	int oled_timeout;
	unsigned char dim;
	unsigned char contrast;
	unsigned char startup;

	// Display
	unsigned int dispDelay;
	unsigned int filterDistant;
	bool h_up = true;
	bool tx_display = true;
	bool rx_display = true;
	uint16_t dispFilter;
	bool dispRF;
	bool dispINET;

	// AFSK,TNC
	bool audio_hpf;
	bool audio_bpf;
	uint8_t preamble;
	uint8_t modem_type;
	uint16_t tx_timeslot;
	char ntp_host[20];

	// VPN wiregurad
	bool vpn;
	bool modem;
	uint16_t wg_port;
	char wg_peer_address[16];
	char wg_local_address[16];
	char wg_netmask_address[16];
	char wg_gw_address[16];
	char wg_public_key[45];
	char wg_private_key[45];

	char http_username[32];
	char http_password[64];

	char path[4][72];

	// GNSS
	bool gnss_enable;
	int8_t gnss_pps_gpio = -1;
	int8_t gnss_channel = 0;	
	uint16_t gnss_tcp_port;
	char gnss_tcp_host[20];
	char gnss_at_command[30];

	unsigned long rf_baudrate;
	int8_t rf_tx_gpio = 13;
	int8_t rf_rx_gpio = 14;
	int8_t rf_sql_gpio = 33;
	int8_t rf_pd_gpio = 27;
	int8_t rf_pwr_gpio = 12;
	int8_t rf_ptt_gpio = 32;
	bool rf_sql_active = 0;
	bool rf_pd_active = 1;
	bool rf_pwr_active = 0;
	bool rf_ptt_active = 0;
	uint8_t adc_atten = 0;
	uint16_t adc_dc_offset;	

	bool i2c_enable;
	int8_t i2c_sda_pin = -1;
	int8_t i2c_sck_pin = -1;
	uint32_t i2c_freq = 400000;
	bool i2c1_enable;
	int8_t i2c1_sda_pin = -1;
	int8_t i2c1_sck_pin = -1;
	uint32_t i2c1_freq = 100000;

	bool onewire_enable = false;
	int8_t onewire_gpio = -1;

	bool uart0_enable = false;
	unsigned long uart0_baudrate;
	int8_t uart0_tx_gpio = -1;
	int8_t uart0_rx_gpio = -1;
	int8_t uart0_rts_gpio = -1;

	bool uart1_enable = false;
	unsigned long uart1_baudrate;
	int8_t uart1_tx_gpio = -1;
	int8_t uart1_rx_gpio = -1;
	int8_t uart1_rts_gpio = -1;

	bool uart2_enable = false;
	unsigned long uart2_baudrate;
	int8_t uart2_tx_gpio = -1;
	int8_t uart2_rx_gpio = -1;
	int8_t uart2_rts_gpio = -1;

	bool modbus_enable = false;
	uint8_t modbus_address = 0;
	int8_t modbus_channel = -1;
	int8_t modbus_de_gpio = -1;

	bool counter0_enable = false;
	bool counter0_active = 0;
	int8_t counter0_gpio = -1;

	bool counter1_enable = false;
	bool counter1_active = 0;
	int8_t counter1_gpio = -1;

	bool ext_tnc_enable = false;
	int8_t ext_tnc_channel = 0;
	int8_t ext_tnc_mode = 0;

} Configuration;

typedef struct igateTLM_struct
{
	uint16_t Sequence;
	unsigned long ParmTimeout;
	unsigned long TeleTimeout;
	uint8_t RF2INET;
	uint8_t INET2RF;
	uint8_t RX;
	uint8_t TX;
	uint8_t DROP;
} igateTLMType;

typedef struct
{
	time_t time;
	char calsign[11];
	char ssid[5];
	bool channel;
	unsigned int pkg;
	uint16_t type;
	uint8_t symbol;
	int16_t audio_level;
	char raw[300];
} pkgListType;

typedef struct statisticStruct
{
	uint32_t allCount;
	uint32_t tncCount;
	uint32_t isCount;
	uint32_t locationCount;
	uint32_t wxCount;
	uint32_t digiCount;
	uint32_t errorCount;
	uint32_t dropCount;
	uint32_t rf2inet;
	uint32_t inet2rf;
	uint32_t txCount;
	uint32_t rxCount;
} statusType;

typedef struct digiTLM_struct
{
	unsigned int Sequence;
	unsigned int ParmTimeout;
	unsigned int TeleTimeout;
	unsigned char RxPkts;
	unsigned char TxPkts;
	unsigned char DropRx;
	unsigned char ErPkts;
} digiTLMType;

typedef struct dataTLM_struct
{
	unsigned int Sequence;
	unsigned long ParmTimeout;
	unsigned long TeleTimeout;
	uint8_t A1;
	uint8_t A2;
	uint8_t A3;
	uint8_t A4;
	uint8_t A5;
	uint8_t BITS;
} dataTLMType;

typedef struct Telemetry_struct
{
	time_t time;
	char callsign[10];
	char PARM[5][10];
	char UNIT[5][10];
	float VAL[5];
	float RAW[5];
	float EQNS[15];
	uint8_t BITS;
	uint8_t BITS_FLAG;
	bool EQNS_FLAG;
} TelemetryType;

typedef struct txQueue_struct
{
	bool Active;
	long timeStamp;
	int Delay;
	char Info[300];
} txQueueType;

typedef struct txDispStruct
{
	uint8_t tx_ch;
	char name[12];
	char info[50];
} txDisp;

#ifdef OLED
const unsigned char LOGO[] PROGMEM =
	{
		0x00, 0x00, 0x00, 0x00, 0x00, 0x00, 0x00, 0x00, 0x00, 0x00,
		0x00, 0x00, 0x00, 0x00, 0x00, 0x00, 0x00, 0x00, 0x80, 0x80,
		0xC0, 0x00, 0x00, 0xC0, 0xC0, 0xE0, 0xE0, 0xF0, 0xF8, 0xF8,
		0xFC, 0xFC, 0xFE, 0x7E, 0x7F, 0x7C, 0x70, 0x00, 0x00, 0x00,
		0x00, 0x00, 0x00, 0x00, 0x00, 0x00, 0x00, 0x00, 0x00, 0x00,
		0xE0, 0xE0, 0xF0, 0xF0, 0xF0, 0xF0, 0xF8, 0xF8, 0xF8, 0xFC,
		0x7C, 0x3C, 0x3C, 0x18, 0x83, 0x9F, 0x9F, 0x9F, 0x8F, 0x8F,
		0xCC, 0x41, 0x63, 0x13, 0x01, 0x81, 0xE1, 0x21, 0x00, 0x00,
		0x00, 0x00, 0x00, 0x00, 0x00, 0x80, 0x00, 0x00, 0x00, 0x00,
		0x00, 0x40, 0x80, 0x00, 0x00, 0x00, 0x00, 0x00, 0x00, 0x03,
		0x07, 0x07, 0x03, 0x03, 0x01, 0x01, 0x00, 0x00, 0x00, 0x00,
		0x08, 0x08, 0x08, 0x09, 0x19, 0x19, 0x09, 0x08, 0x08, 0x0C,
		0x04, 0x86, 0x83, 0x81, 0x80, 0x80, 0x80, 0x80, 0x80, 0x80,
		0x80, 0x80, 0x80, 0x8C, 0x80, 0x84, 0xC2, 0x80, 0x07, 0x08,
		0x07, 0x00, 0x00, 0x00, 0x00, 0x00, 0x00, 0x00, 0x00, 0x00,
		0x00, 0x00, 0x00, 0x00, 0x00, 0x00, 0x00, 0x00, 0x00, 0x00,
		0x00, 0x00, 0x00, 0x00, 0x00, 0xE0, 0xF8, 0x3E, 0x43, 0x7D,
		0x7E, 0x7E, 0x7E, 0x7E, 0x7E, 0x7E, 0x7E, 0x7E, 0x7E, 0x7E,
		0x7E, 0x7E, 0x7E, 0x7E, 0x79, 0x07, 0x7C, 0xF0, 0xC0, 0x00,
		0x00, 0x00, 0x00, 0x00, 0x00, 0x00, 0x00, 0x00, 0x00, 0x00,
		0x00, 0x00, 0x00, 0x00, 0x00, 0x00, 0x00, 0x00, 0x00, 0x00,
		0x00, 0x00, 0xFF, 0xFF, 0xFF, 0xE7, 0xC3, 0xC3, 0xC3, 0xFF,
		0xFF, 0xFF, 0x3F, 0x3F, 0x3F, 0x3F, 0x3F, 0xFF, 0xFF, 0xFF,
		0xE7, 0xC3, 0xC3, 0xC3, 0xFF, 0xFF, 0xFF, 0x00, 0x00, 0x00,
		0x00, 0x00, 0x00, 0x00, 0x00, 0x00, 0x00, 0x00, 0x00, 0x00,
		0x00, 0x00, 0x00, 0x00, 0x00, 0x00, 0x00, 0x00, 0x00, 0x00,
		0x03, 0x1F, 0x3F, 0x3F, 0x3F, 0x1F, 0x03, 0x03, 0x03, 0x03,
		0x03, 0x03, 0x03, 0x03, 0x03, 0x03, 0x03, 0x03, 0x03, 0x1F,
		0x3F, 0x3F, 0x3F, 0x1F, 0x03, 0x00, 0x00, 0x00};
#endif

const char PARM[] = {"PARM.RF->INET,INET->RF,DigiRpt,TX2RF,DropRx"};
const char UNIT[] = {"UNIT.Pkts,Pkts,Pkts,Pkts,Pkts"};
const char EQNS[] = {"EQNS.0,1,0,0,1,0,0,1,0,0,1,0,0,1,0"};

const float ctcss[] = {0, 67, 71.9, 74.4, 77, 79.7, 82.5, 85.4, 88.5, 91.5, 94.8, 97.4, 100, 103.5, 107.2, 110.9, 114.8, 118.8, 123, 127.3, 131.8, 136.5, 141.3, 146.2, 151.4, 156.7, 162.2, 167.9, 173.8, 179.9, 186.2, 192.8, 203.5, 210.7, 218.1, 225.7, 233.6, 241.8, 250.3};
const float wifiPwr[12][2] = {{-4, -1}, {8, 2}, {20, 5}, {28, 7}, {34, 8.5}, {44, 11}, {52, 13}, {60, 15}, {68, 17}, {74, 18.5}, {76, 19}, {78, 19.5}};
const char RF_TYPE[9][11] = {"NONE", "SA868_VHF", "SA868_UHF", "SA868_350", "SR110V_VHF", "SR110U_UHF", "SR350P", "SR120V_VHF", "SR120U_UHF"};
const unsigned long baudrate[] = {2400, 4800, 9600, 19200, 2880, 38400, 57600, 76800, 115200, 230400, 460800, 576000, 921600};
const char GNSS_PORT[5][6] = {"NONE", "UART0", "UART1", "UART2", "TCP"};
const char TNC_PORT[4][6] = {"NONE", "UART0", "UART1", "UART2"};
const char TNC_MODE[4][6] = {"NONE", "KISS", "TNC2", "YAESU"};
const char WX_PORT[7][11] = {"NONE", "UART0_CSV", "UART1_CSV", "UART2_CSV", "MODBUS","SENSOR","TCP/UDP"};
const char MODEM_TYPE[2][10] = {"AFSK_300", "AFSK_1200"};

uint8_t checkSum(uint8_t *ptr, size_t count);
void saveEEPROM();
void defaultConfig();
String getValue(String data, char separator, int index);
boolean isValidNumber(String str);
void taskSerial(void *pvParameters);
void taskGPS(void *pvParameters);
void taskAPRS(void *pvParameters);
void taskAPRSPoll(void *pvParameters);
void taskNetwork(void *pvParameters);
void taskTNC(void *pvParameters);
void sort(pkgListType a[], int size);
void sortPkgDesc(pkgListType a[], int size);
int processPacket(String &tnc2);
int digiProcess(AX25Msg &Packet);
void printTime();
int popTNC2Raw(int &ret);
int pushTNC2Raw(int raw);
int pkgListUpdate(char *call, char *raw,size_t len, uint16_t type, bool channel);
pkgListType getPkgList(int idx);
String myBeacon(String Path);
int tlmList_Find(char *call);
int tlmListOld();
TelemetryType getTlmList(int idx);
void powerSave();
void powerWakeup();
bool powerStatus();
int packet2Raw(String &tnc2, AX25Msg &Packet);
bool waitResponse(String &data, String rsp = "\r\n", uint32_t timeout = 1000);
String sendIsAckMsg(String toCallSign, char *msgId);
bool pkgTxPush(const char *info, size_t len, int dly);
bool pkgTxUpdate(const char *info, int delay);
void dispWindow(String line, uint8_t mode, bool filter);
void dispTxWindow(txDisp txs);
void systemDisp();
void pkgCountDisp();
void pkgLastDisp();
void statisticsDisp();
String getTimeStamp();
void DD_DDDDDtoDDMMSS(float DD_DDDDD, int *DD, int *MM, int *SS);
String getPath(int idx);
void GPS_INIT();

#endif
