nakhonthai/ESP32IGate/src/webservice.cpp

/*
 Name:		ESP32IGate
 Created:	13-10-2023 14:27:23
 Author:	HS5TQA/Atten
 Github:	https://github.com/nakhonthai
 Facebook:	https://www.facebook.com/atten
 Support IS: host:aprs.dprns.com port:14580 or aprs.hs5tqa.ampr.org:14580
 Support IS monitor: http://aprs.dprns.com:14501 or http://aprs.hs5tqa.ampr.org:14501
*/
#include <Arduino.h>
#include "AFSK.h"
#include "webservice.h"
#include "base64.hpp"
#include "wireguard_vpn.h"
#include <LibAPRSesp.h>
#include <parse_aprs.h>
#include "jquery_min_js.h"

AsyncWebServer async_server(80);
AsyncWebServer async_websocket(81);
AsyncWebSocket ws("/ws");
AsyncWebSocket ws_gnss("/ws_gnss");

// Create an Event Source on /events
AsyncEventSource lastheard_events("/eventHeard");

String webString;

bool defaultSetting = false;

void serviceHandle()
{
	// server.handleClient();
}

void notFound(AsyncWebServerRequest *request)
{
	request->send(404, "text/plain", "Not found");
}

void handle_logout(AsyncWebServerRequest *request)
{
	webString = "Log out";
	request->send(200, "text/html", webString);
}

void setMainPage(AsyncWebServerRequest *request)
{
	if (!request->authenticate(config.http_username, config.http_password))
	{
		return request->requestAuthentication();
	}

	webString = "<!DOCTYPE html>\n<html lang=\"en\">\n<head>\n";
	webString += "<meta name=\"robots\" content=\"index\" />\n";
	webString += "<meta name=\"robots\" content=\"follow\" />\n";
	webString += "<meta name=\"language\" content=\"English\" />\n";
	webString += "<meta http-equiv=\"Content-Type\" content=\"text/html; charset=utf-8\" />\n";
	webString += "<meta name=\"GENERATOR\" content=\"configure 20230924\" />\n";
	webString += "<meta name=\"Author\" content=\"Mr.Somkiat Nakhonthai (HS5TQA)\" />\n";
	webString += "<meta name=\"Description\" content=\"Web Embedded Configuration\" />\n";
	webString += "<meta name=\"KeyWords\" content=\"ESP32IGATE,APRS\" />\n";
	webString += "<meta http-equiv=\"Cache-Control\" content=\"no-cache, no-store, must-revalidate\" />\n";
	webString += "<meta http-equiv=\"pragma\" content=\"no-cache\" />\n";
	webString += "<link rel=\"shortcut icon\" href=\"http://aprs.dprns.com/favicon.ico\" type=\"image/x-icon\" />\n";
	webString += "<meta http-equiv=\"Expires\" content=\"0\" />\n";
	webString += "<title>ESP32IGATE</title>\n";
	webString += "<link rel=\"stylesheet\" type=\"text/css\" href=\"style.css\" />\n";
	webString += "<script src=\"/jquery-3.7.1.js\"></script>\n";
	webString += "<script type=\"text/javascript\">\n";
	webString += "function selectTab(evt, tabName) {\n";
	webString += "var i, tabcontent, tablinks;\n";
	webString += "tablinks = document.getElementsByClassName(\"nav-tabs\");\n";
	webString += "for (i = 0; i < tablinks.length; i++) {\n";
	webString += "tablinks[i].className = tablinks[i].className.replace(\" active\", \"\");\n";
	webString += "}\n";
	webString += "\n";
	webString += "//document.getElementById(tabName).style.display = \"block\";\n";
	webString += "if (tabName == 'DashBoard') {\n";
	webString += "$(\"#contentmain\").load(\"/dashboard\");\n";
	webString += "} else if (tabName == 'Radio') {\n";
	webString += "$(\"#contentmain\").load(\"/radio\");\n";
	webString += "} else if (tabName == 'IGATE') {\n";
	webString += "$(\"#contentmain\").load(\"/igate\");\n";
	webString += "} else if (tabName == 'DIGI') {\n";
	webString += "$(\"#contentmain\").load(\"/digi\");\n";
	webString += "} else if (tabName == 'TRACKER') {\n";
	webString += "$(\"#contentmain\").load(\"/tracker\");\n";
	webString += "} else if (tabName == 'WX') {\n";
	webString += "$(\"#contentmain\").load(\"/wx\");\n";
	webString += "} else if (tabName == 'TLM') {\n";
	webString += "$(\"#contentmain\").load(\"/tlm\");\n";
	webString += "} else if (tabName == 'VPN') {\n";
	webString += "$(\"#contentmain\").load(\"/vpn\");\n";
	webString += "} else if (tabName == 'Wireless') {\n";
	webString += "$(\"#contentmain\").load(\"/wireless\");\n";
	webString += "} else if (tabName == 'MOD') {\n";
	webString += "$(\"#contentmain\").load(\"/mod\");\n";
	webString += "} else if (tabName == 'System') {\n";
	webString += "$(\"#contentmain\").load(\"/system\");\n";
	webString += "} else if (tabName == 'About') {\n";
	webString += "$(\"#contentmain\").load(\"/about\");\n";
	webString += "}\n";
	webString += "\n";
	webString += "if (evt != null) evt.currentTarget.className += \" active\";\n";
	webString += "}\n";
	webString += "if (!!window.EventSource) {";
	webString += "var source = new EventSource('/eventHeard');";

	webString += "source.addEventListener('open', function(e) {";
	webString += "console.log(\"Events Connected\");";
	webString += "}, false);";
	webString += "source.addEventListener('error', function(e) {";
	webString += "if (e.target.readyState != EventSource.OPEN) {";
	webString += "console.log(\"Events Disconnected\");";
	webString += "}\n}, false);";
	webString += "source.addEventListener('lastHeard', function(e) {";
	// webString += "console.log(\"lastHeard\", e.data);";
	webString += "var lh=document.getElementById(\"lastHeard\");";
	webString += "if(lh != null) {lh.innerHTML = e.data;}";
	webString += "}, false);\n}";
	webString += "</script>\n";
	webString += "</head>\n";
	webString += "\n";
	webString += "<body onload=\"selectTab(event, 'DashBoard')\">\n";
	webString += "\n";
	webString += "<div class=\"container\">\n";
	webString += "<div class=\"header\">\n";
	// webString += "<div style=\"font-size: 8px; text-align: right; padding-right: 8px;\">ESP32IGate Firmware V" + String(VERSION) + "</div>\n";
	// webString += "<div style=\"font-size: 8px; text-align: right; padding-right: 8px;\"><a href=\"/logout\">[LOG OUT]</a></div>\n";
	webString += "<h1>ESP32IGate Project [APRS ALL IN ONE]</h1>\n";
	webString += "<div style=\"font-size: 8px; text-align: right; padding-right: 8px;\"><a href=\"/logout\">[LOG OUT]</a></div>\n";
	webString += "<div class=\"row\">\n";
	webString += "<ul class=\"nav nav-tabs\" style=\"margin: 5px;\">\n";
	webString += "<button class=\"nav-tabs\" onclick=\"selectTab(event, 'DashBoard')\">DashBoard</button>\n";
	webString += "<button class=\"nav-tabs\" onclick=\"selectTab(event, 'Radio')\" id=\"btnRadio\">Radio</button>\n";
	webString += "<button class=\"nav-tabs\" onclick=\"selectTab(event, 'IGATE')\">IGATE</button>\n";
	webString += "<button class=\"nav-tabs\" onclick=\"selectTab(event, 'DIGI')\">DIGI</button>\n";
	webString += "<button class=\"nav-tabs\" onclick=\"selectTab(event, 'TRACKER')\">TRACKER</button>\n";
	webString += "<button class=\"nav-tabs\" onclick=\"selectTab(event, 'WX')\">WX</button>\n";
	webString += "<button class=\"nav-tabs\" onclick=\"selectTab(event, 'TLM')\">TLM</button>\n";
	webString += "<button class=\"nav-tabs\" onclick=\"selectTab(event, 'VPN')\">VPN</button>\n";
	webString += "<button class=\"nav-tabs\" onclick=\"selectTab(event, 'Wireless')\">Wireless</button>\n";
	webString += "<button class=\"nav-tabs\" onclick=\"selectTab(event, 'MOD')\">MOD</button>\n";
	webString += "<button class=\"nav-tabs\" onclick=\"selectTab(event, 'System')\">System</button>\n";
	webString += "<button class=\"nav-tabs\" onclick=\"selectTab(event, 'About')\">About</button>\n";
	webString += "</ul>\n";
	webString += "</div>\n";
	webString += "</div>\n";
	webString += "\n";

	webString += "<div class=\"contentwide\" id=\"contentmain\"  style=\"font-size: 2pt;\">\n";
	webString += "\n";
	webString += "</div>\n";
	webString += "<br />\n";
	webString += "<div class=\"footer\">\n";
	webString += "ESP32IGate Web Configuration<br />Copy right ©2023.\n";
	webString += "<br />\n";
	webString += "</div>\n";
	webString += "</div>\n";
	webString += "<!-- <script type=\"text/javascript\" src=\"/nice-select.min.js\"></script> -->\n";
	webString += "<script type=\"text/javascript\">\n";
	webString += "var selectize = document.querySelectorAll('select')\n";
	webString += "var options = { searchable: true };\n";
	webString += "selectize.forEach(function (select) {\n";
	webString += "if (select.length > 30 && null === select.onchange && !select.name.includes(\"ExtendedId\")) {\n";
	webString += "select.classList.add(\"small\", \"selectize\");\n";
	webString += "tabletd = select.closest('td');\n";
	webString += "tabletd.style.cssText = 'overflow-x:unset';\n";
	webString += "NiceSelect.bind(select, options);\n";
	webString += "}\n";
	webString += "});\n";
	webString += "</script>\n";
	webString += "</body>\n";
	webString += "</html>";
	request->send(200, "text/html", webString); // send to someones browser when asked
	event_lastHeard();
}

////////////////////////////////////////////////////////////
// handler for web server request: http://IpAddress/      //
////////////////////////////////////////////////////////////

void handle_css(AsyncWebServerRequest *request)
{
	const char *css = ".container{width:800px;text-align:left;margin:auto;border-radius:10px 10px 10px 10px;-moz-border-radius:10px 10px 10px 10px;-webkit-border-radius:10px 10px 10px 10px;-khtml-border-radius:10px 10px 10px 10px;-ms-border-radius:10px 10px 10px 10px;box-shadow:3px 3px 3px #707070;background:#fff;border-color: #2194ec;padding: 0px;border-width: 5px;border-style:solid;}body,font{font:12px verdana,arial,sans-serif;color:#fff}.header{background:#2194ec;text-decoration:none;color:#fff;font-family:verdana,arial,sans-serif;text-align:left;padding:5px 0;border-radius:10px 10px 0 0;-moz-border-radius:10px 10px 0 0;-webkit-border-radius:10px 10px 0 0;-khtml-border-radius:10px 10px 0 0;-ms-border-radius:10px 10px 0 0}.content{margin:0 0 0 166px;padding:1px 5px 5px;color:#000;background:#fff;text-align:center;font-size: 8pt;}.contentwide{padding:50px 5px 5px;color:#000;background:#fff;text-align:center}.contentwide h2{color:#000;font:1em verdana,arial,sans-serif;text-align:center;font-weight:700;padding:0;margin:0;font-size: 12pt;}.footer{background:#2194ec;text-decoration:none;color:#fff;font-family:verdana,arial,sans-serif;font-size:9px;text-align:center;padding:10px 0;border-radius:0 0 10px 10px;-moz-border-radius:0 0 10px 10px;-webkit-border-radius:0 0 10px 10px;-khtml-border-radius:0 0 10px 10px;-ms-border-radius:0 0 10px 10px;clear:both}#tail{height:450px;width:805px;overflow-y:scroll;overflow-x:scroll;color:#0f0;background:#000}table{vertical-align:middle;text-align:center;empty-cells:show;padding-left:3;padding-right:3;padding-top:3;padding-bottom:3;border-collapse:collapse;border-color:#0f07f2;border-style:solid;border-spacing:0px;border-width:3px;text-decoration:none;color:#fff;background:#000;font-family:verdana,arial,sans-serif;font-size : 12px;width:100%;white-space:nowrap}table th{font-size: 10pt;font-family:lucidia console,Monaco,monospace;text-shadow:1px 1px #0e038c;text-decoration:none;background:#0525f7;border:1px solid silver}table tr:nth-child(even){background:#f7f7f7}table tr:nth-child(odd){background:#eeeeee}table td{color:#000;font-family:lucidia console,Monaco,monospace;text-decoration:none;border:1px solid #010369}body{background:#edf0f5;color:#000}a{text-decoration:none}a:link,a:visited{text-decoration:none;color:#0000e0;font-weight:400}th:last-child a.tooltip:hover span{left:auto;right:0}ul{padding:5px;margin:10px 0;list-style:none;float:left}ul li{float:left;display:inline;margin:0 10px}ul li a{text-decoration:none;float:left;color:#999;cursor:pointer;font:900 14px/22px arial,Helvetica,sans-serif}ul li a span{margin:0 10px 0 -10px;padding:1px 8px 5px 18px;position:relative;float:left}h1{text-shadow:2px 2px #303030;text-align:center}.toggle{position:absolute;margin-left:-9999px;visibility:hidden}.toggle+label{display:block;position:relative;cursor:pointer;outline:none}input.toggle-round-flat+label{padding:1px;width:33px;height:18px;background-color:#ddd;border-radius:10px;transition:background .4s}input.toggle-round-flat+label:before,input.toggle-round-flat+label:after{display:block;position:absolute;}input.toggle-round-flat+label:before{top:1px;left:1px;bottom:1px;right:1px;background-color:#fff;border-radius:10px;transition:background .4s}input.toggle-round-flat+label:after{top:2px;left:2px;bottom:2px;width:16px;background-color:#ddd;border-radius:12px;transition:margin .4s,background .4s}input.toggle-round-flat:checked+label{background-color:#dd4b39}input.toggle-round-flat:checked+label:after{margin-left:14px;background-color:#dd4b39}@-moz-document url-prefix(){select,input{margin:0;padding:0;border-width:1px;font:12px verdana,arial,sans-serif}input[type=button],button,input[type=submit]{padding:0 3px;border-radius:3px 3px 3px 3px;-moz-border-radius:3px 3px 3px 3px}}.nice-select.small,.nice-select-dropdown li.option{height:24px!important;min-height:24px!important;line-height:24px!important}.nice-select.small ul li:nth-of-type(2){clear:both}.nav{margin-bottom:0;padding-left:10;list-style:none}.nav>li{position:relative;display:block}.nav>li>a{position:relative;display:block;padding:5px 10px}.nav>li>a:hover,.nav>li>a:focus{text-decoration:none;background-color:#eee}.nav>li.disabled>a{color:#999}.nav>li.disabled>a:hover,.nav>li.disabled>a:focus{color:#999;text-decoration:none;background-color:initial;cursor:not-allowed}.nav .open>a,.nav .open>a:hover,.nav .open>a:focus{background-color:#eee;border-color:#428bca}.nav .nav-divider{height:1px;margin:9px 0;overflow:hidden;background-color:#e5e5e5}.nav>li>a>img{max-width:none}.nav-tabs{border-bottom:1px solid #ddd}.nav-tabs>li{float:left;margin-bottom:-1px}.nav-tabs>li>a{margin-right:0;line-height:1.42857143;border:1px solid #ddd;border-radius:10px 10px 0 0}.nav-tabs>li>a:hover{border-color:#eee #eee #ddd}.nav-tabs>button{margin-right:0;line-height:1.42857143;border:2px solid #ddd;border-radius:10px 10px 0 0}.nav-tabs>button:hover{background-color:#25bbfc;border-color:#428bca;color:#eaf2f9;border-bottom-color:transparent;}.nav-tabs>button.active,.nav-tabs>button.active:hover,.nav-tabs>button.active:focus{color:#f7fdfd;background-color:#1aae0d;border:1px solid #ddd;border-bottom-color:transparent;cursor:default}.nav-tabs>li.active>a,.nav-tabs>li.active>a:hover,.nav-tabs>li.active>a:focus{color:#428bca;background-color:#e5e5e5;border:1px solid #ddd;border-bottom-color:transparent;cursor:default}.nav-tabs.nav-justified{width:100%;border-bottom:0}.nav-tabs.nav-justified>li{float:none}.nav-tabs.nav-justified>li>a{text-align:center;margin-bottom:5px}.nav-tabs.nav-justified>.dropdown .dropdown-menu{top:auto;left:auto}.nav-status{float:left;margin:0;padding:3px;width:160px;font-weight:400;min-height:600}#bar,#prgbar {background-color: #f1f1f1;border-radius: 14px}#bar {background-color: #3498db;width: 0%;height: 14px}.switch{position:relative;display:inline-block;width:34px;height:16px}.switch input{opacity:0;width:0;height:0}.slider{position:absolute;cursor:pointer;top:0;left:0;right:0;bottom:0;background-color:#f55959;-webkit-transition:.4s;transition:.4s}.slider:before{position:absolute;content:\"\";height:12px;width:12px;left:2px;bottom:2px;background-color:#fff;-webkit-transition:.4s;transition:.4s}input:checked+.slider{background-color:#5ca30a}input:focus+.slider{box-shadow:0 0 1px #5ca30a}input:checked+.slider:before{-webkit-transform:translateX(16px);-ms-transform:translateX(16px);transform:translateX(16px)}.slider.round{border-radius:34px}.slider.round:before{border-radius:50%}\n";
	request->send_P(200, "text/css", css);
}

void handle_jquery(AsyncWebServerRequest *request)
{
	AsyncWebServerResponse *response = request->beginResponse_P(200, String(F("application/javascript")), (const uint8_t *)jquery_3_7_1_min_js_gz, jquery_3_7_1_min_js_gz_len);
	response->addHeader(String(F("Content-Encoding")), String(F("gzip")));
	response->setContentLength(jquery_3_7_1_min_js_gz_len);
	request->send(response);
}

void handle_dashboard(AsyncWebServerRequest *request)
{
	if (!request->authenticate(config.http_username, config.http_password))
	{
		return request->requestAuthentication();
	}
	webString = "<script type=\"text/javascript\">\n";
	webString += "function reloadSysInfo() {\n";
	webString += "$(\"#sysInfo\").load(\"/sysinfo\", function () { setTimeout(reloadSysInfo, 60000) });\n";
	webString += "}\n";
	webString += "setTimeout(reloadSysInfo(), 100);\n";
	webString += "function reloadSidebarInfo() {\n";
	webString += "$(\"#sidebarInfo\").load(\"/sidebarInfo\", function () { setTimeout(reloadSidebarInfo, 10000) });\n";
	webString += "}\n";
	webString += "setTimeout(reloadSidebarInfo, 200);\n";
	webString += "$(window).trigger('resize');\n";

	webString += "</script>\n";

	webString += "<div id=\"sysInfo\">\n";
	webString += "</div>\n";

	webString += "<br />\n";
	webString += "<div class=\"nav-status\">\n";
	webString += "<div id=\"sidebarInfo\">\n";
	webString += "</div>\n";
	webString += "<br />\n";

	webString += "<table>\n";
	webString += "<tr>\n";
	webString += "<th colspan=\"2\">Radio Info</th>\n";
	webString += "</tr>\n";
	webString += "<tr>\n";
	webString += "<td>Freq TX</td>\n";
	webString += "<td style=\"background: #ffffff;\">" + String(config.freq_tx, 4) + " MHz</td>\n";
	webString += "</tr>\n";
	webString += "<tr>\n";
	webString += "<td>Freq RX</td>\n";
	webString += "<td style=\"background: #ffffff;\">" + String(config.freq_rx, 4) + " MHz</td>\n";
	webString += "</tr>\n";
	webString += "<tr>\n";
	webString += "<td>H/L</td>\n";
	if (config.rf_power)
		webString += "<td>HIGH</td>\n";
	else
		webString += "<td>LOW</td>\n";
	webString += "</tr>\n";
	webString += "</table>\n";
	webString += "\n";
	webString += "<br />\n";
	webString += "<table>\n";
	webString += "<tr>\n";
	webString += "<th colspan=\"2\">APRS SERVER</th>\n";
	webString += "</tr>\n";
	webString += "<tr>\n";
	webString += "<td>HOST</td>\n";
	webString += "<td style=\"background: #ffffff;\">" + String(config.aprs_host) + "</td>\n";
	webString += "</tr>\n";
	webString += "<tr>\n";
	webString += "<td>PORT</td>\n";
	webString += "<td style=\"background: #ffffff;\">" + String(config.aprs_port) + "</td>\n";
	webString += "</tr>\n";
	webString += "</table>\n";
	webString += "<br />\n";
	webString += "<table>\n";
	webString += "<tr>\n";
	webString += "<th colspan=\"2\">WiFi</th>\n";
	webString += "</tr>\n";
	webString += "<tr>\n";
	webString += "<td>MODE</td>\n";
	String strWiFiMode = "OFF";
	if (config.wifi_mode == WIFI_STA_FIX)
	{
		strWiFiMode = "STA";
	}
	else if (config.wifi_mode == WIFI_AP_FIX)
	{
		strWiFiMode = "AP";
	}
	else if (config.wifi_mode == WIFI_AP_STA_FIX)
	{
		strWiFiMode = "AP+STA";
	}
	webString += "<td style=\"background: #ffffff;\">" + strWiFiMode + "</td>\n";
	webString += "</tr>\n";
	webString += "<tr>\n";
	webString += "<td>SSID</td>\n";
	webString += "<td style=\"background: #ffffff;\">" + String(WiFi.SSID()) + "</td>\n";
	webString += "</tr>\n";
	webString += "<tr>\n";
	webString += "<td>RSSI</td>\n";
	if (WiFi.isConnected())
		webString += "<td style=\"background: #ffffff;\">" + String(WiFi.RSSI()) + " dBm</td>\n";
	else
		webString += "<td style=\"background:#606060; color:#b0b0b0;\" aria-disabled=\"true\">Disconnect</td>\n";
	webString += "</tr>\n";
	webString += "</table>\n";
	webString += "<br />\n";
#ifdef BLUETOOTH
	webString += "<table>\n";
	webString += "<tr>\n";

	webString += "<th colspan=\"2\">Bluetooth</th>\n";
	webString += "</tr>\n";
	webString += "<td>Master</td>\n";
	if (config.bt_master)
		webString += "<td style=\"background:#0b0; color:#030; width:50%;\">Enabled</td>\n";
	else
		webString += "<td style=\"background:#606060; color:#b0b0b0;\" aria-disabled=\"true\">Disabled</td>\n";
	webString += "</tr>\n";
	webString += "<tr>\n";
	webString += "<tr>\n";
	webString += "<td>NAME</td>\n";
	webString += "<td style=\"background: #ffffff;\">" + String(config.bt_name) + "</td>\n";
	webString += "</tr>\n";
	webString += "<tr>\n";
	webString += "<tr>\n";
	webString += "<td>MODE</td>\n";
	String btMode = "";
	if (config.bt_mode == 1)
	{
		btMode = "TNC2";
	}
	else if (config.bt_mode == 2)
	{
		btMode = "KISS";
	}
	else
	{
		btMode = "NONE";
	}
	webString += "<td style=\"background: #ffffff;\">" + btMode + "</td>\n";
	webString += "</tr>\n";
	webString += "<tr>\n";
	webString += "</table>\n";
#endif
	webString += "</div>\n";

	webString += "</div>\n";
	webString += "\n";
	webString += "<div class=\"content\">\n";
	webString += "<div id=\"lastHeard\">\n";
	webString += "</div>\n";

	request->send(200, "text/html", webString); // send to someones browser when asked
	delay(100);
	webString.clear();
	event_lastHeard();
}

void handle_sidebar(AsyncWebServerRequest *request)
{
	if (!request->authenticate(config.http_username, config.http_password))
	{
		return request->requestAuthentication();
	}
	String html = "<table style=\"background:white;border-collapse: unset;\">\n";
	html += "<tr>\n";
	html += "<th colspan=\"2\">Modes Enabled</th>\n";
	html += "</tr>\n";
	html += "<tr>\n";
	if (config.igate_en)
		html += "<th style=\"background:#0b0; color:#030; width:50%;border-radius: 10px;border: 2px solid white;\">IGATE</th>\n";
	else
		html += "<th style=\"background:#606060; color:#b0b0b0;border-radius: 10px;border: 2px solid white;\">IGATE</th>\n";

	if (config.digi_en)
		html += "<th style=\"background:#0b0; color:#030; width:50%;border-radius: 10px;border: 2px solid white;\">DIGI</th>\n";
	else
		html += "<th style=\"background:#606060; color:#b0b0b0;border-radius: 10px;border: 2px solid white;\">DIGI</th>\n";
	html += "</tr>\n";
	html += "<tr>\n";
	if (config.wx_en)
		html += "<th style=\"background:#0b0; color:#030; width:50%;border-radius: 10px;border: 2px solid white;\">WX</th>\n";
	else
		html += "<th style=\"background:#606060; color:#b0b0b0;border-radius: 10px;border: 2px solid white;\">WX</th>\n";
	// html += "<th style=\"background:#606060; color:#b0b0b0;border-radius: 10px;border: 2px solid white;\">SAT</th>\n";
	if (config.trk_en)
		html += "<th style=\"background:#0b0; color:#030; width:50%;border-radius: 10px;border: 2px solid white;\">TRACKER</th>\n";
	else
		html += "<th style=\"background:#606060; color:#b0b0b0;border-radius: 10px;border: 2px solid white;\">TRACKER</th>\n";
	html += "</tr>\n";
	html += "</table>\n";
	html += "<br />\n";
	html += "<table style=\"background:white;border-collapse: unset;\">\n";
	html += "<tr>\n";
	html += "<th colspan=\"2\">Network Status</th>\n";
	html += "</tr>\n";
	html += "<tr>\n";
	if (aprsClient.connected() == true)
		html += "<th style=\"background:#0b0; color:#030; width:50%;border-radius: 10px;border: 2px solid white;\">APRS-IS</th>\n";
	else
		html += "<th style=\"background:#606060; color:#b0b0b0;border-radius: 10px;border: 2px solid white;\" aria-disabled=\"true\">APRS-IS</th>\n";
	if (wireguard_active() == true)
		html += "<th style=\"background:#0b0; color:#030; width:50%;border-radius: 10px;border: 2px solid white;\">VPN</th>\n";
	else
		html += "<th style=\"background:#606060; color:#b0b0b0;border-radius: 10px;border: 2px solid white;\" aria-disabled=\"true\">VPN</th>\n";
	html += "</tr>\n";
	html += "<tr>\n";
	html += "<th style=\"background:#606060; color:#b0b0b0;border-radius: 10px;border: 2px solid white;\" aria-disabled=\"true\">4G LTE</th>\n";
	html += "<th style=\"background:#606060; color:#b0b0b0;border-radius: 10px;border: 2px solid white;\" aria-disabled=\"true\">MQTT</th>\n";
	html += "</tr>\n";
	html += "</table>\n";
	html += "<br />\n";
	html += "<table>\n";
	html += "<tr>\n";
	html += "<th colspan=\"2\">STATISTICS</th>\n";
	html += "</tr>\n";
	html += "<tr>\n";
	html += "<td style=\"width: 60px;text-align: right;\">PACKET RX:</td>\n";
	html += "<td style=\"background: #ffffff;\">" + String(status.rxCount) + "</td>\n";
	html += "</tr>\n";
	html += "<tr>\n";
	html += "<td style=\"width: 60px;text-align: right;\">PACKET TX:</td>\n";
	html += "<td style=\"background: #ffffff;\">" + String(status.txCount) + "</td>\n";
	html += "</tr>\n";
	html += "<tr>\n";
	html += "<td style=\"width: 60px;text-align: right;\">RF2INET:</td>\n";
	html += "<td style=\"background: #ffffff;\">" + String(status.rf2inet) + "</td>\n";
	html += "</tr>\n";
	html += "<tr>\n";
	html += "<td style=\"width: 60px;text-align: right;\">INET2RF:</td>\n";
	html += "<td style=\"background: #ffffff;\">" + String(status.inet2rf) + "</td>\n";
	html += "</tr>\n";
	html += "<tr>\n";
	html += "<td style=\"width: 60px;text-align: right;\">DIGI:</td>\n";
	html += "<td style=\"background: #ffffff;\">" + String(status.digiCount) + "</td>\n";
	html += "</tr>\n";
	html += "<tr>\n";
	html += "<td style=\"width: 60px;text-align: right;\">DROP/ERR:</td>\n";
	html += "<td style=\"background: #ffffff;\">" + String(status.dropCount) + "/" + String(status.errorCount) + "</td>\n";
	html += "</tr>\n";
	html += "</table>\n";
	if (config.gnss_enable == true)
	{
		html += "<br />\n";
		html += "<table>\n";
		html += "<tr>\n";
		html += "<th colspan=\"2\">GPS Info <a href=\"/gnss\" target=\"_gnss\" style=\"color: yellow;font-size:8pt\">[View]</a></th>\n";
		html += "</tr>\n";
		html += "<tr>\n";
		html += "<td>LAT:</td>\n";
		html += "<td style=\"background: #ffffff;text-align: left;\">" + String(gps.location.lat(), 5) + "</td>\n";
		html += "</tr>\n";
		html += "<tr>\n";
		html += "<td>LON:</td>\n";
		html += "<td style=\"background: #ffffff;text-align: left;\">" + String(gps.location.lng(), 5) + "</td>\n";
		html += "</tr>\n";
		html += "<tr>\n";
		html += "<td>ALT:</td>\n";
		html += "<td style=\"background: #ffffff;text-align: left;\">" + String(gps.altitude.meters(), 1) + "</td>\n";
		html += "</tr>\n";
		html += "<tr>\n";
		html += "<td>SAT:</td>\n";
		html += "<td style=\"background: #ffffff;text-align: left;\">" + String(gps.satellites.value()) + "</td>\n";
		html += "</tr>\n";
		html += "</table>\n";
	}
	html += "<script>\n";
	html += "$(window).trigger('resize');\n";
	html += "</script>\n";
	// request->send(200, "text/html", html); // send to someones browser when asked
	// delay(100);
	request->send(200, "text/html", html);
	html.clear();
}

void handle_symbol(AsyncWebServerRequest *request)
{
	int i;
	char *web = (char *)malloc(25000);
	int sel = -1;
	for (i = 0; i < request->args(); i++)
	{
		if (request->argName(i) == "sel")
		{
			if (request->arg(i) != "")
			{
				if (isValidNumber(request->arg(i)))
				{
					sel = request->arg(i).toInt();
				}
			}
		}
	}

	if (web)
	{
		memset(web, 0, 25000);
		strcat(web, "<table border=\"1\" align=\"center\">\n");
		strcat(web, "<tr><th colspan=\"16\">Table '/'</th></tr>\n");
		strcat(web, "<tr>\n");
		for (i = 33; i < 129; i++)
		{
			//<td><img onclick="window.opener.setValue(113,2);" src="http://aprs.dprns.com/symbols/icons/113-2.png"></td>
			char lnk[128];
			if (sel == -1)
				sprintf(lnk, "<td><img onclick=\"window.opener.setValue(%d,1);\" src=\"http://aprs.dprns.com/symbols/icons/%d-1.png\"></td>", i, i);
			else
				sprintf(lnk, "<td><img onclick=\"window.opener.setValue(%d,%d,1);\" src=\"http://aprs.dprns.com/symbols/icons/%d-1.png\"></td>", sel, i, i);
			strcat(web, lnk);

			if (((i % 16) == 0) && (i < 126))
				strcat(web, "</tr>\n<tr>\n");
		}
		strcat(web, "</tr>");
		strcat(web, "</table>\n<br />");
		strcat(web, "<table border=\"1\" align=\"center\">\n");
		strcat(web, "<tr><th colspan=\"16\">Table '\\'</th></tr>\n");
		strcat(web, "<tr>\n");
		for (i = 33; i < 129; i++)
		{
			char lnk[128];
			if (sel == -1)
				sprintf(lnk, "<td><img onclick=\"window.opener.setValue(%d,2);\" src=\"http://aprs.dprns.com/symbols/icons/%d-2.png\"></td>", i, i);
			else
				sprintf(lnk, "<td><img onclick=\"window.opener.setValue(%d,%d,2);\" src=\"http://aprs.dprns.com/symbols/icons/%d-2.png\"></td>", sel, i, i);
			strcat(web, lnk);
			if (((i % 16) == 0) && (i < 126))
				strcat(web, "</tr>\n<tr>\n");
		}
		strcat(web, "</tr>");
		strcat(web, "</table>\n");
		request->send_P(200, "text/html", web);
		free(web);
	}
}

void handle_sysinfo(AsyncWebServerRequest *request)
{
	String html = "<table style=\"table-layout: fixed;border-collapse: unset;border-radius: 10px;border-color: #ee800a;border-style: ridge;border-spacing: 1px;border-width: 4px;background: #ee800a;\">\n";
	html += "<tr>\n";
	html += "<th><span><b>Up Time</b></span></th>\n";
	html += "<th><span>Free RAM(KByte)</span></th>\n";
	html += "<th><span>Free PSRAM(KByte)</span></th>\n";
	html += "<th><span>SD CARD(MByte)</span></th>\n";
	html += "<th><span>CPU Temp(C)</span></th>\n";

	html += "</tr>\n";
	html += "<tr>\n";
	time_t tn = now() - systemUptime;
	// String uptime = String(day(tn) - 1, DEC) + "D " + String(hour(tn), DEC) + ":" + String(minute(tn), DEC) + ":" + String(second(tn), DEC);
	String uptime = String(day(tn) - 1, DEC) + "D " + String(hour(tn), DEC) + ":" + String(minute(tn), DEC);
	html += "<td><b>" + uptime + "</b></td>\n";
	html += "<td><b>" + String((float)ESP.getFreeHeap() / 1000, 1) + "/" + String((float)ESP.getHeapSize() / 1000, 1) + "</b></td>\n";
	html += "<td><b>" + String((float)ESP.getFreePsram() / 1000, 1) + "/" + String((float)ESP.getPsramSize() / 1000, 1) + "</b></td>\n";
	uint32_t cardTotal = SD.totalBytes() / (1024 * 1024);
	uint32_t cardUsed = SD.usedBytes() / (1024 * 1024);
	html += "<td><b>" + String(cardUsed) + "/" + String(cardTotal) + "</b></td>\n";
	html += "<td><b>" + String((float)(temprature_sens_read() - 32) / 1.8F, 1) + "</b></td>\n";
	// html += "<td style=\"background: #f00\"><b>" + String(ESP.getCycleCount()) + "</b></td>\n";
	html += "</tr>\n";
	html += "</table>\n";
	request->send(200, "text/html", html); // send to someones browser when asked
	html.clear();
}

void handle_lastHeard(AsyncWebServerRequest *request)
{
	struct pbuf_t aprs;
	ParseAPRS aprsParse;
	struct tm tmstruct;
	String html = "";
	sort(pkgList, PKGLISTSIZE);

	html = "<table>\n";
	html += "<th colspan=\"7\" style=\"background-color: #070ac2;\">LAST HEARD <a href=\"/tnc2\" target=\"_tnc2\" style=\"color: yellow;font-size:8pt\">[RAW]</a></th>\n";
	html += "<tr>\n";
	html += "<th style=\"min-width:10ch\"><span><b>Time (";
	if (config.timeZone >= 0)
		html += "+";
	// else
	//	html += "-";

	if (config.timeZone == (int)config.timeZone)
		html += String((int)config.timeZone) + ")</b></span></th>\n";
	else
		html += String(config.timeZone, 1) + ")</b></span></th>\n";
	html += "<th style=\"min-width:16px\">ICON</th>\n";
	html += "<th style=\"min-width:10ch\">Callsign</th>\n";
	html += "<th>VIA LAST PATH</th>\n";
	html += "<th style=\"min-width:5ch\">DX</th>\n";
	html += "<th style=\"min-width:5ch\">PACKET</th>\n";
	html += "<th style=\"min-width:5ch\">AUDIO</th>\n";
	html += "</tr>\n";

	for (int i = 0; i < PKGLISTSIZE; i++)
	{
		if (i >= PKGLISTSIZE)
			break;
		pkgListType pkg = getPkgList(i);
		if (pkg.time > 0)
		{
			String line = String(pkg.raw);
			int packet = pkg.pkg;
			int start_val = line.indexOf(">", 0); // หาตำแหน่งแรกของ >
			if (start_val > 3)
			{
				String src_call = line.substring(0, start_val);
				memset(&aprs, 0, sizeof(pbuf_t));
				aprs.buf_len = 300;
				aprs.packet_len = line.length();
				line.toCharArray(&aprs.data[0], aprs.packet_len);
				int start_info = line.indexOf(":", 0);
				int end_ssid = line.indexOf(",", 0);
				int start_dst = line.indexOf(">", 2);
				int start_dstssid = line.indexOf("-", start_dst);
				String path = "";

				if ((end_ssid > start_dst) && (end_ssid < start_info))
				{
					path = line.substring(end_ssid + 1, start_info);
				}
				if (end_ssid < 5)
					end_ssid = start_info;
				if ((start_dstssid > start_dst) && (start_dstssid < start_dst + 10))
				{
					aprs.dstcall_end_or_ssid = &aprs.data[start_dstssid];
				}
				else
				{
					aprs.dstcall_end_or_ssid = &aprs.data[end_ssid];
				}
				aprs.info_start = &aprs.data[start_info + 1];
				aprs.dstname = &aprs.data[start_dst + 1];
				aprs.dstname_len = end_ssid - start_dst;
				aprs.dstcall_end = &aprs.data[end_ssid];
				aprs.srccall_end = &aprs.data[start_dst];

				// Serial.println(aprs.info_start);
				if (aprsParse.parse_aprs(&aprs))
				{
					pkg.calsign[10] = 0;
					// time_t tm = pkg.time;
					localtime_r(&pkg.time, &tmstruct);
					char strTime[10];
					sprintf(strTime, "%02d:%02d:%02d", tmstruct.tm_hour, tmstruct.tm_min, tmstruct.tm_sec);
					// String str = String(tmstruct.tm_hour, DEC) + ":" + String(tmstruct.tm_min, DEC) + ":" + String(tmstruct.tm_sec, DEC);

					html += "<tr><td>" + String(strTime) + "</td>";
					String fileImg = "";
					uint8_t sym = (uint8_t)aprs.symbol[1];
					if (sym > 31 && sym < 127)
					{
						if (aprs.symbol[0] > 64 && aprs.symbol[0] < 91) // table A-Z
						{
							html += "<td><b>" + String(aprs.symbol[0]) + "</b></td>";
						}
						else
						{
							fileImg = String(sym, DEC);
							if (aprs.symbol[0] == 92)
							{
								fileImg += "-2.png";
							}
							else if (aprs.symbol[0] == 47)
							{
								fileImg += "-1.png";
							}
							else
							{
								fileImg = "dot.png";
							}
							html += "<td><img src=\"http://aprs.dprns.com/symbols/icons/" + fileImg + "\"></td>";
						}
					}
					else
					{
						html += "<td><img src=\"http://aprs.dprns.com/symbols/icons/dot.png\"></td>";
					}
					html += "<td>" + src_call;
					if (aprs.srcname_len > 0 && aprs.srcname_len < 10) // Get Item/Object
					{
						char itemname[10];
						memset(&itemname, 0, sizeof(itemname));
						memcpy(&itemname, aprs.srcname, aprs.srcname_len);
						html += "(" + String(itemname) + ")";
					}
					html += +"</td>";
					if (path == "")
					{
						html += "<td style=\"text-align: left;\">RF: DIRECT</td>";
					}
					else
					{
						String LPath = path.substring(path.lastIndexOf(',') + 1);
						// if(path.indexOf("qAR")>=0 || path.indexOf("qAS")>=0 || path.indexOf("qAC")>=0){ //Via from Internet Server
						if (path.indexOf("qA") >= 0 || path.indexOf("TCPIP") >= 0)
						{
							html += "<td style=\"text-align: left;\">INET: " + LPath + "</td>";
						}
						else
						{
							if (path.indexOf("*") > 0)
							{
								html += "<td style=\"text-align: left;\">DIGI: " + path + "</td>";
							}
							else
							{
								html += "<td style=\"text-align: left;\">RF: " + path + "</td>";
							}
						}
					}
					// html += "<td>" + path + "</td>";
					if (aprs.flags & F_HASPOS)
					{
						double lat, lon;
						if (gps.location.isValid())
						{
							lat = gps.location.lat();
							lon = gps.location.lng();
						}
						else
						{
							lat = config.igate_lat;
							lon = config.igate_lon;
						}
						double dtmp = aprsParse.direction(lon, lat, aprs.lng, aprs.lat);
						double dist = aprsParse.distance(lon, lat, aprs.lng, aprs.lat);
						html += "<td>" + String(dist, 1) + "km/" + String(dtmp, 0) + "°</td>";
					}
					else
					{
						html += "<td>-</td>\n";
					}
					html += "<td>" + String(packet) + "</td>\n";
					if (pkg.audio_level == 0)
					{
						html += "<td>-</td></tr>\n";
					}
					else
					{
						double Vrms = (double)pkg.audio_level / 1000;
						double audBV = 20.0F * log10(Vrms);
						if (audBV < -20.0F)
						{
							html += "<td style=\"color: #0000f0;\">";
						}
						else if (audBV > -5.0F)
						{
							html += "<td style=\"color: #f00000;\">";
						}
						else
						{
							html += "<td style=\"color: #008000;\">";
						}
						html += String(audBV, 1) + "dBV</td></tr>\n";
					}
				}
			}
		}
	}
	html += "</table>\n";
	request->send(200, "text/html", html); // send to someones browser when asked
	delay(100);
	html.clear();
}

void event_lastHeard()
{
	// log_d("Event count: %d",lastheard_events.count());
	if (lastheard_events.count() == 0)
		return;

	struct pbuf_t aprs;
	ParseAPRS aprsParse;
	struct tm tmstruct;

	String html = "";
	String line = "";
	sort(pkgList, PKGLISTSIZE);

	//log_d("Create html last heard");

	html = "<table>\n";
	html += "<th colspan=\"7\" style=\"background-color: #070ac2;\">LAST HEARD <a href=\"/tnc2\" target=\"_tnc2\" style=\"color: yellow;font-size:8pt\">[RAW]</a></th>\n";
	html += "<tr>\n";
	html += "<th style=\"min-width:10ch\"><span><b>Time (";
	if (config.timeZone >= 0)
		html += "+";
	// else
	//	html += "-";

	if (config.timeZone == (int)config.timeZone)
		html += String((int)config.timeZone) + ")</b></span></th>\n";
	else
		html += String(config.timeZone, 1) + ")</b></span></th>\n";
	html += "<th style=\"min-width:16px\">ICON</th>\n";
	html += "<th style=\"min-width:10ch\">Callsign</th>\n";
	html += "<th>VIA LAST PATH</th>\n";
	html += "<th style=\"min-width:5ch\">DX</th>\n";
	html += "<th style=\"min-width:5ch\">PACKET</th>\n";
	html += "<th style=\"min-width:5ch\">AUDIO</th>\n";
	html += "</tr>\n";

	for (int i = 0; i < PKGLISTSIZE; i++)
	{
		if (i >= PKGLISTSIZE)
			break;
		pkgListType pkg = getPkgList(i);
		if (pkg.time > 0)
		{
			line = String(pkg.raw);
			//log_d("IDX=%d RAW:%s",i,line.c_str());
			int packet = pkg.pkg;
			int start_val = line.indexOf(">", 0); // หาตำแหน่งแรกของ >
			if (start_val > 3)
			{
				String src_call = line.substring(0, start_val);
				memset(&aprs, 0, sizeof(pbuf_t));
				aprs.buf_len = 300;
				aprs.packet_len = line.length();
				line.toCharArray(&aprs.data[0], aprs.packet_len);
				int start_info = line.indexOf(":", 0);
				if(start_info<10) continue;
				int start_dst = line.lastIndexOf(">", start_info);
				if(start_dst<5) continue;
				int end_ssid = line.indexOf(",", 10);
				if(end_ssid>start_info || end_ssid<10) end_ssid=start_info;
				
				int start_dstssid = line.lastIndexOf("-",end_ssid);
				if(start_dstssid<start_dst) start_dstssid=-1;
				String path = "";

				if ((end_ssid > start_dst) && (end_ssid < start_info))
				{
					path = line.substring(end_ssid + 1, start_info);
				}

				if (start_dstssid > start_dst)
				{
					aprs.dstcall_end_or_ssid = &aprs.data[start_dstssid+1];
				}
				else
				{
					aprs.dstcall_end_or_ssid = &aprs.data[end_ssid];
				}
				aprs.info_start = &aprs.data[start_info + 1];
				aprs.dstname = &aprs.data[start_dst + 1];
				aprs.dstname_len = end_ssid - start_dst;
				aprs.dstcall_end = &aprs.data[end_ssid];
				aprs.srccall_end = &aprs.data[start_dst];

				// Serial.println(aprs.info_start);
				if (aprsParse.parse_aprs(&aprs))
				{
					pkg.calsign[10] = 0;
					// time_t tm = pkg.time;
					localtime_r(&pkg.time, &tmstruct);
					char strTime[10];
					sprintf(strTime, "%02d:%02d:%02d", tmstruct.tm_hour, tmstruct.tm_min, tmstruct.tm_sec);
					// String str = String(tmstruct.tm_hour, DEC) + ":" + String(tmstruct.tm_min, DEC) + ":" + String(tmstruct.tm_sec, DEC);

					html += "<tr><td>" + String(strTime) + "</td>";
					String fileImg = "";
					uint8_t sym = (uint8_t)aprs.symbol[1];
					if (sym > 31 && sym < 127)
					{
						if (aprs.symbol[0] > 64 && aprs.symbol[0] < 91) // table A-Z
						{
							html += "<td><b>" + String(aprs.symbol[0]) + "</b></td>";
						}
						else
						{
							fileImg = String(sym, DEC);
							if (aprs.symbol[0] == 92)
							{
								fileImg += "-2.png";
							}
							else if (aprs.symbol[0] == 47)
							{
								fileImg += "-1.png";
							}
							else
							{
								fileImg = "dot.png";
							}
							html += "<td><img src=\"http://aprs.dprns.com/symbols/icons/" + fileImg + "\"></td>";
						}
						fileImg.clear();
					}
					else
					{
						html += "<td><img src=\"http://aprs.dprns.com/symbols/icons/dot.png\"></td>";
					}
					html += "<td>" + src_call;
					if (aprs.srcname_len > 0 && aprs.srcname_len < 10) // Get Item/Object
					{
						char itemname[10];
						memset(&itemname, 0, 10);
						memcpy(&itemname, aprs.srcname, aprs.srcname_len);
						html += "(" + String(itemname) + ")";
					}
					html += +"</td>";
					if (path == "")
					{
						html += "<td style=\"text-align: left;\">RF: DIRECT</td>";
					}
					else
					{
						String LPath = path.substring(path.lastIndexOf(',') + 1);
						// if(path.indexOf("qAR")>=0 || path.indexOf("qAS")>=0 || path.indexOf("qAC")>=0){ //Via from Internet Server
						if (path.indexOf("qA") >= 0 || path.indexOf("TCPIP") >= 0)
						{
							html += "<td style=\"text-align: left;\">INET: " + LPath + "</td>";
						}
						else
						{
							if (path.indexOf("*") > 0)
								html += "<td style=\"text-align: left;\">DIGI: " + path + "</td>";
							else
								html += "<td style=\"text-align: left;\">RF: " + path + "</td>";
						}
						LPath.clear();
					}
					// html += "<td>" + path + "</td>";
					if (aprs.flags & F_HASPOS)
					{
						double lat, lon;
						if (gps.location.isValid())
						{
							lat = gps.location.lat();
							lon = gps.location.lng();
						}
						else
						{
							lat = config.igate_lat;
							lon = config.igate_lon;
						}
						double dtmp = aprsParse.direction(lon, lat, aprs.lng, aprs.lat);
						double dist = aprsParse.distance(lon, lat, aprs.lng, aprs.lat);
						html += "<td>" + String(dist, 1) + "km/" + String(dtmp, 0) + "°</td>";
					}
					else
					{
						html += "<td>-</td>\n";
					}
					html += "<td>" + String(packet) + "</td>\n";
					if (pkg.audio_level == 0)
					{
						html += "<td>-</td></tr>\n";
					}
					else
					{
						double Vrms = (double)pkg.audio_level / 1000;
						double audBV = 20.0F * log10(Vrms);
						if (audBV < -20.0F)
						{
							html += "<td style=\"color: #0000f0;\">";
						}
						else if (audBV > -5.0F)
						{
							html += "<td style=\"color: #f00000;\">";
						}
						else
						{
							html += "<td style=\"color: #008000;\">";
						}
						html += String(audBV, 1) + "dBV</td></tr>\n";
					}
				}
				path.clear();
				src_call.clear();
			}
			line.clear();
		}
	}
	html += "</table>\n";
	char *info = (char *)calloc(html.length(), sizeof(char));
	if (info)
	{
		//log_d("Send Event lastHeard");
		html.toCharArray(info, html.length(), 0);
		html.clear();
		lastheard_events.send(info, "lastHeard", millis(), 5000);
		free(info);
	}
	else
	{
		log_d("Memory is low!!");
	}
}

void handle_radio(AsyncWebServerRequest *request)
{
	if (!request->authenticate(config.http_username, config.http_password))
	{
		return request->requestAuthentication();
	}
	// bool noiseEn=false;
	bool radioEnable = false;
	if (request->hasArg("commitRadio"))
	{
		for (uint8_t i = 0; i < request->args(); i++)
		{
			// Serial.print("SERVER ARGS ");
			// Serial.print(request->argName(i));
			// Serial.print("=");
			// Serial.println(request->arg(i));
			if (request->argName(i) == "radioEnable")
			{
				if (request->arg(i) != "")
				{
					if (String(request->arg(i)) == "OK")
					{
						radioEnable = true;
					}
				}
			}

			if (request->argName(i) == "nw_band")
			{
				if (request->arg(i) != "")
				{
					if (isValidNumber(request->arg(i)))
					{
						config.band = request->arg(i).toInt();
						// if (request->arg(i).toInt())
						// 	config.band = 1;
						// else
						// 	config.band = 0;
					}
				}
			}

			if (request->argName(i) == "volume")
			{
				if (request->arg(i) != "")
				{
					if (isValidNumber(request->arg(i)))
						config.volume = request->arg(i).toInt();
				}
			}

			if (request->argName(i) == "rf_power")
			{
				if (request->arg(i) != "")
				{
					if (isValidNumber(request->arg(i)))
					{
						if (request->arg(i).toInt())
							config.rf_power = true;
						else
							config.rf_power = false;
					}
				}
			}

			if (request->argName(i) == "sql_level")
			{
				if (request->arg(i) != "")
				{
					if (isValidNumber(request->arg(i)))
						config.sql_level = request->arg(i).toInt();
				}
			}

			if (request->argName(i) == "tx_freq")
			{
				if (request->arg(i) != "")
				{
					if (isValidNumber(request->arg(i)))
						config.freq_tx = request->arg(i).toFloat();
				}
			}
			if (request->argName(i) == "rx_freq")
			{
				if (request->arg(i) != "")
				{
					if (isValidNumber(request->arg(i)))
						config.freq_rx = request->arg(i).toFloat();
				}
			}

			if (request->argName(i) == "tx_offset")
			{
				if (request->arg(i) != "")
				{
					if (isValidNumber(request->arg(i)))
						config.offset_tx = request->arg(i).toInt();
				}
			}
			if (request->argName(i) == "rx_offset")
			{
				if (request->arg(i) != "")
				{
					if (isValidNumber(request->arg(i)))
						config.offset_rx = request->arg(i).toInt();
				}
			}

			if (request->argName(i) == "tx_ctcss")
			{
				if (request->arg(i) != "")
				{
					if (isValidNumber(request->arg(i)))
						config.tone_tx = request->arg(i).toInt();
				}
			}
			if (request->argName(i) == "rx_ctcss")
			{
				if (request->arg(i) != "")
				{
					if (isValidNumber(request->arg(i)))
						config.tone_rx = request->arg(i).toInt();
				}
			}
			if (request->argName(i) == "rf_type")
			{
				if (request->arg(i) != "")
				{
					if (isValidNumber(request->arg(i)))
						config.rf_type = request->arg(i).toInt();
				}
			}
		}
		// config.noise=noiseEn;
		// config.agc=agcEn;
		config.rf_en = radioEnable;
		String html = "OK";
		request->send(200, "text/html", html); // send to someones browser when asked
		saveEEPROM();
		delay(500);
		RF_MODULE(false);
	}
	else if (request->hasArg("commitTNC"))
	{
		bool hpf = 0;
		bool bpf = 0;
		for (uint8_t i = 0; i < request->args(); i++)
		{
			if (request->argName(i) == "HPF")
			{
				if (request->arg(i) != "")
				{
					if (String(request->arg(i)) == "OK")
					{
						hpf = true;
					}
				}
			}
			if (request->argName(i) == "BPF")
			{
				if (request->arg(i) != "")
				{
					if (String(request->arg(i)) == "OK")
					{
						bpf = true;
					}
				}
			}
			if (request->argName(i) == "timeSlot")
			{
				if (request->arg(i) != "")
				{
					if (isValidNumber(request->arg(i)))
					{
						config.tx_timeslot = request->arg(i).toInt();
					}
				}
			}
			if (request->argName(i) == "preamble")
			{
				if (request->arg(i) != "")
				{
					if (isValidNumber(request->arg(i)))
					{
						config.preamble = request->arg(i).toInt();
					}
				}
			}
			if (request->argName(i) == "modem_type")
			{
				if (request->arg(i) != "")
				{
					if (isValidNumber(request->arg(i)))
						config.modem_type = request->arg(i).toInt();
				}
			}
		}
		config.audio_hpf = hpf;
		config.audio_bpf = bpf;
		afskSetHPF(config.audio_hpf);
		afskSetBPF(config.audio_bpf);
		String html = "OK";
		request->send(200, "text/html", html); // send to someones browser when asked
		saveEEPROM();
	}
	else
	{
		String html = "<script type=\"text/javascript\">\n";
		html += "var sliderVol = document.getElementById(\"sliderVolume\");\n";
		html += "var outputVol = document.getElementById(\"volShow\");\n";
		html += "var sliderSql = document.getElementById(\"sliderSql\");\n";
		html += "var outputSql = document.getElementById(\"sqlShow\");\n";
		html += "outputVol.innerHTML = sliderVol.value;\n";
		html += "outputSql.innerHTML = sliderSql.value;\n";
		html += "\n";
		html += "sliderVol.oninput = function () {\n";
		html += "outputVol.innerHTML = this.value;\n";
		html += "}\n";
		html += "sliderSql.oninput = function () {\n";
		html += "outputSql.innerHTML = this.value;\n";
		html += "}\n";
		html += "\n";
		html += "$('form').submit(function (e) {\n";
		html += "e.preventDefault();\n";
		html += "var data = new FormData(e.currentTarget);\n";
		html += "if(e.currentTarget.id===\"formRadio\") document.getElementById(\"submitRadio\").disabled=true;\n";
		html += "if(e.currentTarget.id===\"formTNC\") document.getElementById(\"submitTNC\").disabled=true;\n";
		html += "$.ajax({\n";
		html += "url: '/radio',\n";
		html += "type: 'POST',\n";
		html += "data: data,\n";
		html += "contentType: false,\n";
		html += "processData: false,\n";
		html += "success: function (data) {\n";
		html += "alert(\"Submited Successfully\");\n";
		html += "},\n";
		html += "error: function (data) {\n";
		html += "alert(\"An error occurred.\");\n";
		html += "}\n";
		html += "});\n";
		html += "});\n";
		html += "function rfType(){\n";
		html += "var type = document.getElementById(\"rf_type\").value;\n";
		html += "if(type==1||type==4||type==7){document.getElementById(\"tx_freq\").setAttribute(\"max\",174);document.getElementById(\"rx_freq\").setAttribute(\"max\",174);};\n";
		html += "if(type==1){document.getElementById(\"tx_freq\").setAttribute(\"min\",134);document.getElementById(\"rx_freq\").setAttribute(\"min\",134);};\n";
		html += "if(type==4||type==7){document.getElementById(\"tx_freq\").setAttribute(\"min\",136);document.getElementById(\"rx_freq\").setAttribute(\"min\",136);};\n";
		html += "if(type==2||type==5||type==8){document.getElementById(\"tx_freq\").setAttribute(\"max\",470);document.getElementById(\"rx_freq\").setAttribute(\"max\",470);};\n";
		html += "if(type==2||type==5||type==8){document.getElementById(\"tx_freq\").setAttribute(\"min\",400);document.getElementById(\"rx_freq\").setAttribute(\"min\",400);};\n";
		html += "if(type==3){document.getElementById(\"tx_freq\").setAttribute(\"min\",320);document.getElementById(\"rx_freq\").setAttribute(\"min\",320);};\n";
		html += "if(type==3){document.getElementById(\"tx_freq\").setAttribute(\"max\",400);document.getElementById(\"rx_freq\").setAttribute(\"max\",400);};\n";
		html += "if(type==6){document.getElementById(\"tx_freq\").setAttribute(\"min\",350);document.getElementById(\"rx_freq\").setAttribute(\"min\",350);};\n";
		html += "if(type==6){document.getElementById(\"tx_freq\").setAttribute(\"max\",390);document.getElementById(\"rx_freq\").setAttribute(\"max\",390);};\n";
		html += "if(type==1||type==4||type==7){document.getElementById(\"tx_freq\").setAttribute(\"value\",144.390);document.getElementById(\"rx_freq\").setAttribute(\"value\",144.390);};\n";
		html += "if(type==2||type==5||type==8){document.getElementById(\"tx_freq\").setAttribute(\"value\",432.5);document.getElementById(\"rx_freq\").setAttribute(\"value\",432.5);};\n";
		html += "\n";
		html += "}\n";
		html += "</script>\n";
		html += "<form id='formRadio' method=\"POST\" action='#' enctype='multipart/form-data'>\n";
		html += "<table>\n";
		html += "<th colspan=\"2\"><span><b>RF Analog Module</b></span></th>\n";
		html += "<tr>\n";
		html += "<td align=\"right\"><b>Enable:</b></td>\n";
		String radioEnFlag = "";
		if (config.rf_en)
			radioEnFlag = "checked";
		html += "<td style=\"text-align: left;\"><label class=\"switch\"><input type=\"checkbox\" name=\"radioEnable\" value=\"OK\" " + radioEnFlag + "><span class=\"slider round\"></span></label></td>\n";
		html += "</tr>\n";
		html += "<tr>\n";
		html += "<td align=\"right\"><b>Module Type:</b></td>\n";
		html += "<td style=\"text-align: left;\">\n";
		html += "<select name=\"rf_type\" id=\"rf_type\" onchange=\"rfType()\">\n";
		for (int i = 0; i < 9; i++)
		{
			if (config.rf_type == i)
				html += "<option value=\"" + String(i) + "\" selected>" + String(RF_TYPE[i]) + "</option>\n";
			else
				html += "<option value=\"" + String(i) + "\" >" + String(RF_TYPE[i]) + "</option>\n";
		}
		html += "</select>\n";
		html += "</td>\n";
		float freqMin = 0;
		float freqMax = 0;
		switch (config.rf_type)
		{
		case RF_SA868_VHF:
			freqMin = 134.0F;
			freqMax = 174.0F;
			break;
		case RF_SR_1WV:
		case RF_SR_2WVS:
			freqMin = 136.0F;
			freqMax = 174.0F;
			break;
		case RF_SA868_350:
			freqMin = 320.0F;
			freqMax = 400.0F;
			break;
		case RF_SR_1W350:
			freqMin = 350.0F;
			freqMax = 390.0F;
			break;
		case RF_SA868_UHF:
		case RF_SR_1WU:
		case RF_SR_2WUS:
			freqMin = 400.0F;
			freqMax = 470.0F;
			break;
		default:
			freqMin = 134.0F;
			freqMax = 500.0F;
			break;
		}
		html += "<tr>\n";
		html += "<td align=\"right\"><b>TX Frequency:</b></td>\n";
		html += "<td style=\"text-align: left;\"><input type=\"number\" id=\"tx_freq\" name=\"tx_freq\" min=\"" + String(freqMin, 4) + "\" max=\"" + String(freqMax, 4) + "\"\n";
		html += "step=\"0.0001\" value=\"" + String(config.freq_tx, 4) + "\" /> MHz</td>\n";
		html += "</tr>\n";
		html += "<tr>\n";
		html += "<td align=\"right\"><b>RX Frequency:</b></td>\n";
		html += "<td style=\"text-align: left;\"><input type=\"number\" id=\"rx_freq\" name=\"rx_freq\" min=\"" + String(freqMin, 4) + "\" max=\"" + String(freqMax, 4) + "\"\n";
		html += "step=\"0.0001\" value=\"" + String(config.freq_rx, 4) + "\" /> Mhz</td>\n";
		html += "</tr>\n";
		html += "<tr>\n";
		html += "<td align=\"right\"><b>TX CTCSS:</b></td>\n";
		html += "<td style=\"text-align: left;\">\n";
		html += "<select name=\"tx_ctcss\" id=\"tx_ctcss\">\n";
		for (int i = 0; i < 39; i++)
		{
			if (config.tone_tx == i)
				html += "<option value=\"" + String(i) + "\" selected>" + String(ctcss[i], 1) + "</option>\n";
			else
				html += "<option value=\"" + String(i) + "\" >" + String(ctcss[i], 1) + "</option>\n";
		}
		html += "</select> Hz\n";
		html += "</td>\n";
		html += "</tr>\n";
		html += "<tr>\n";
		html += "<td align=\"right\"><b>RX CTCSS:</b></td>\n";
		html += "<td style=\"text-align: left;\">\n";
		html += "<select name=\"rx_ctcss\" id=\"rx_ctcss\">\n";
		html += "<option value=\"0\" selected>0.0</option>\n";
		for (int i = 0; i < 39; i++)
		{
			if (config.tone_rx == i)
				html += "<option value=\"" + String(i) + "\" selected>" + String(ctcss[i], 1) + "</option>\n";
			else
				html += "<option value=\"" + String(i) + "\" >" + String(ctcss[i], 1) + "</option>\n";
		}
		html += "</select> Hz\n";
		html += "</td>\n";
		html += "</tr>\n";
		html += "<tr>\n";
		html += "<td align=\"right\"><b>Narrow/Wide:</b></td>\n";
		html += "<td style=\"text-align: left;\">\n";
		html += "<select name=\"nw_band\" id=\"nw_band\">\n";
		String cmSelNWT = "";
		String cmSelNWF = "";
		if (config.band)
		{
			cmSelNWT = "selected";
		}
		else
		{
			cmSelNWF = "selected";
		}
		html += "<option value=\"1\" " + cmSelNWT + ">25.0KHz</option>\n";
		html += "<option value=\"0\" " + cmSelNWF + ">12.5KHz</option>\n";
		html += "</select>\n";
		html += "</td>\n";
		html += "</tr>\n";
		html += "<tr>\n";
		html += "<td align=\"right\"><b>TX Power:</b></td>\n";
		html += "<td style=\"text-align: left;\">\n";
		html += "<select name=\"rf_power\" id=\"rf_power\">\n";
		String cmRfPwrF = "";
		String cmRfPwrT = "";
		if (config.rf_power)
		{
			cmRfPwrT = "selected";
		}
		else
		{
			cmRfPwrF = "selected";
		}
		html += "<option value=\"1\" " + cmRfPwrT + ">HIGH</option>\n";
		html += "<option value=\"0\" " + cmRfPwrF + ">LOW</option>\n";
		html += "</select>\n";
		html += "</td>\n";
		html += "</tr>\n";
		html += "<tr>\n";
		html += "<td align=\"right\"><b>VOLUME:</b></td>\n";
		html += "<td style=\"text-align: left;\"><input id=\"sliderVolume\" name=\"volume\" type=\"range\"\n";
		html += "min=\"1\" max=\"8\" value=\"" + String(config.volume) + "\" /><b><span style=\"font-size: 14pt;\" id=\"volShow\">" + String(config.volume) + "</span></b></td>\n";
		html += "</tr>\n";
		html += "<tr>\n";
		html += "<td align=\"right\"><b>SQL Level:</b></td>\n";
		html += "<td style=\"text-align: left;\"><input id=\"sliderSql\" name=\"sql_level\" type=\"range\"\n";
		html += "min=\"0\" max=\"8\" value=\"" + String(config.sql_level) + "\" /><b><span style=\"font-size: 14pt;\" id=\"sqlShow\">" + String(config.sql_level) + "</span></b></td>\n";
		html += "</tr>\n";
		html += "</table>\n";
		html += "<div class=\"form-group\">\n";
		html += "<label class=\"col-sm-4 col-xs-12 control-label\"></label>\n";
		html += "<div class=\"col-sm-2 col-xs-4\"><button type='submit' id='submitRadio' name=\"commitRadio\"> Apply Change </button></div>\n";
		html += "</div><br />\n";
		html += "<input type=\"hidden\" name=\"commitRadio\"/>\n";
		html += "</form>";

		// AFSK,TNC Configuration
		html += "<form id='formTNC' method=\"POST\" action='#' enctype='multipart/form-data'>\n";
		html += "<table>\n";
		html += "<th colspan=\"2\"><span><b>AFSK/TNC Configuration</b></span></th>\n";
		html += "<tr>\n";
		html += "<td align=\"right\"><b>Modem Type:</b></td>\n";
		html += "<td style=\"text-align: left;\">\n";
		html += "<select name=\"modem_type\" id=\"modem_type\" \">\n";
		for (int i = 0; i < 2; i++)
		{
			if (config.modem_type == i)
				html += "<option value=\"" + String(i) + "\" selected>" + String(MODEM_TYPE[i]) + "</option>\n";
			else
				html += "<option value=\"" + String(i) + "\" >" + String(MODEM_TYPE[i]) + "</option>\n";
		}
		html += "</select>\n";
		html += "</td>\n";
		html += "<tr>\n";
		html += "<td align=\"right\"><b>Audio HPF:</b></td>\n";
		String strFlag = "";
		if (config.audio_hpf)
			strFlag = "checked";
		html += "<td style=\"text-align: left;\"><label class=\"switch\"><input type=\"checkbox\" name=\"HPF\" value=\"OK\" " + strFlag + "><span class=\"slider round\"></span></label><label style=\"vertical-align: bottom;font-size: 8pt;\"><i> *Audio high pass filter >1KHz cutoff 10Khz</i></label></td>\n";
		html += "</tr>\n";
		html += "<tr>\n";
		html += "<td align=\"right\"><b>Audio BPF:</b></td>\n";
		strFlag = "";
		if (config.audio_bpf)
			strFlag = "checked";
		html += "<td style=\"text-align: left;\"><label class=\"switch\"><input type=\"checkbox\" name=\"BPF\" value=\"OK\" " + strFlag + "><span class=\"slider round\"></span></label><label style=\"vertical-align: bottom;font-size: 8pt;\"><i> *Audio band pass filter 1Khz-2.5KHz</i></label></td>\n";
		html += "</tr>\n";
		html += "<tr>\n";
		html += "<td align=\"right\"><b>TX Time Slot:</b></td>\n";
		html += "<td style=\"text-align: left;\"><input type=\"number\" name=\"timeSlot\" min=\"2000\" max=\"99999\"\n";
		html += "step=\"1000\" value=\"" + String(config.tx_timeslot) + "\" /> mSec.</td>\n";
		html += "</tr>\n";
		html += "<tr>\n";
		html += "<td align=\"right\"><b>Preamble:</b></td>\n";
		html += "<td style=\"text-align: left;\">\n";
		html += "<select name=\"preamble\">\n";
		for (int i = 1; i < 10; i++)
		{
			if (config.preamble == i)
				html += "<option value=\"" + String(i) + "\" selected>" + String(i * 100) + "</option>\n";
			else
				html += "<option value=\"" + String(i) + "\" >" + String(i * 100) + "</option>\n";
		}
		html += "</select> mSec.\n";
		html += "</td>\n";
		html += "</tr>\n";

		html += "</table>\n";
		html += "<div class=\"col-sm-2 col-xs-4\"><button type='submit' id='submitTNC'  name=\"commitTNC\"> Apply Change </button></div>\n";
		html += "<br />\n";
		html += "<input type=\"hidden\" name=\"commitTNC\"/>\n";
		html += "</form>";
		request->send(200, "text/html", html); // send to someones browser when asked
	}
}

void handle_vpn(AsyncWebServerRequest *request)
{
	if (!request->authenticate(config.http_username, config.http_password))
	{
		return request->requestAuthentication();
	}
	if (request->hasArg("commitVPN"))
	{
		bool vpnEn = false;
		for (uint8_t i = 0; i < request->args(); i++)
		{
			// Serial.print("SERVER ARGS ");
			// Serial.print(request->argName(i));
			// Serial.print("=");
			// Serial.println(request->arg(i));

			if (request->argName(i) == "vpnEnable")
			{
				if (request->arg(i) != "")
				{
					// if (isValidNumber(request->arg(i)))
					if (String(request->arg(i)) == "OK")
						vpnEn = true;
				}
			}

			// if (request->argName(i) == "taretime") {
			//	if (request->arg(i) != "")
			//	{
			//		//if (isValidNumber(request->arg(i)))
			//		if (String(request->arg(i)) == "OK")
			//			taretime = true;
			//	}
			// }
			if (request->argName(i) == "wg_port")
			{
				if (request->arg(i) != "")
				{
					config.wg_port = request->arg(i).toInt();
				}
			}

			if (request->argName(i) == "wg_public_key")
			{
				if (request->arg(i) != "")
				{
					strcpy(config.wg_public_key, request->arg(i).c_str());
					config.wg_public_key[44] = 0;
				}
			}

			if (request->argName(i) == "wg_private_key")
			{
				if (request->arg(i) != "")
				{
					strcpy(config.wg_private_key, request->arg(i).c_str());
					config.wg_private_key[44] = 0;
				}
			}

			if (request->argName(i) == "wg_peer_address")
			{
				if (request->arg(i) != "")
				{
					strcpy(config.wg_peer_address, request->arg(i).c_str());
				}
			}

			if (request->argName(i) == "wg_local_address")
			{
				if (request->arg(i) != "")
				{
					strcpy(config.wg_local_address, request->arg(i).c_str());
				}
			}

			if (request->argName(i) == "wg_netmask_address")
			{
				if (request->arg(i) != "")
				{
					strcpy(config.wg_netmask_address, request->arg(i).c_str());
				}
			}

			if (request->argName(i) == "wg_gw_address")
			{
				if (request->arg(i) != "")
				{
					strcpy(config.wg_gw_address, request->arg(i).c_str());
				}
			}
		}

		config.vpn = vpnEn;
		saveEEPROM();
		String html = "OK";
		request->send(200, "text/html", html);
	}
	else
	{

		String html = "<script type=\"text/javascript\">\n";
		html += "$('form').submit(function (e) {\n";
		html += "e.preventDefault();\n";
		html += "var data = new FormData(e.currentTarget);\n";
		html += "if(e.currentTarget.id===\"formVPN\") document.getElementById(\"submitVPN\").disabled=true;\n";
		html += "$.ajax({\n";
		html += "url: '/vpn',\n";
		html += "type: 'POST',\n";
		html += "data: data,\n";
		html += "contentType: false,\n";
		html += "processData: false,\n";
		html += "success: function (data) {\n";
		html += "alert(\"Submited Successfully\");\n";
		html += "},\n";
		html += "error: function (data) {\n";
		html += "alert(\"An error occurred.\");\n";
		html += "}\n";
		html += "});\n";
		html += "});\n";
		html += "</script>\n";

		// html += "<h2>System Setting</h2>\n";
		html += "<form accept-charset=\"UTF-8\" action=\"#\" class=\"form-horizontal\" id=\"fromVPN\" method=\"post\">\n";
		html += "<table>\n";
		html += "<th colspan=\"2\"><span><b>Wireguard Configuration</b></span></th>\n";
		html += "<tr>";

		String syncFlage = "";
		if (config.vpn)
			syncFlage = "checked";
		html += "<td align=\"right\"><b>Enable</b></td>\n";
		html += "<td style=\"text-align: left;\"><label class=\"switch\"><input type=\"checkbox\" name=\"vpnEnable\" value=\"OK\" " + syncFlage + "><span class=\"slider round\"></span></label></td>\n";
		html += "</tr>\n";

		html += "<tr>\n";
		html += "<td align=\"right\"><b>Server Address</b></td>\n";
		html += "<td style=\"text-align: left;\"><input  size=\"20\" id=\"wg_peer_address\" name=\"wg_peer_address\" type=\"text\" value=\"" + String(config.wg_peer_address) + "\" /></td>\n";
		html += "</tr>\n";

		html += "<tr>\n";
		html += "<td align=\"right\"><b>Server Port</b></td>\n";
		html += "<td style=\"text-align: left;\"><input id=\"wg_port\" size=\"5\" name=\"wg_port\" type=\"number\" value=\"" + String(config.wg_port) + "\" /></td>\n";
		html += "</tr>\n";

		html += "<tr>\n";
		html += "<td align=\"right\"><b>Local Address</b></td>\n";
		html += "<td style=\"text-align: left;\"><input id=\"wg_local_address\" name=\"wg_local_address\" type=\"text\" value=\"" + String(config.wg_local_address) + "\" /></td>\n";
		html += "</tr>\n";

		html += "<tr>\n";
		html += "<td align=\"right\"><b>Netmask</b></td>\n";
		html += "<td style=\"text-align: left;\"><input id=\"wg_netmask_address\" name=\"wg_netmask_address\" type=\"text\" value=\"" + String(config.wg_netmask_address) + "\" /></td>\n";
		html += "</tr>\n";

		html += "<tr>\n";
		html += "<td align=\"right\"><b>Gateway</b></td>\n";
		html += "<td style=\"text-align: left;\"><input id=\"wg_gw_address\" name=\"wg_gw_address\" type=\"text\" value=\"" + String(config.wg_gw_address) + "\" /></td>\n";
		html += "</tr>\n";

		html += "<tr>\n";
		html += "<td align=\"right\"><b>Public Key</b></td>\n";
		html += "<td style=\"text-align: left;\"><input size=\"50\" maxlength=\"44\" id=\"wg_public_key\" name=\"wg_public_key\" type=\"text\" value=\"" + String(config.wg_public_key) + "\" /></td>\n";
		html += "</tr>\n";

		html += "<tr>\n";
		html += "<td align=\"right\"><b>Private Key</b></td>\n";
		html += "<td style=\"text-align: left;\"><input size=\"50\" maxlength=\"44\" id=\"wg_private_key\" name=\"wg_private_key\" type=\"text\" value=\"" + String(config.wg_private_key) + "\" /></td>\n";
		html += "</tr>\n";

		html += "</table><br />\n";
		html += "<td><input class=\"btn btn-primary\" id=\"submitVPN\" name=\"commitVPN\" type=\"submit\" value=\"Save Config\" maxlength=\"80\"/></td>\n";
		html += "<input type=\"hidden\" name=\"commitVPN\"/>\n";
		html += "</form>\n";

		request->send(200, "text/html", html); // send to someones browser when asked
	}
}

void handle_mod(AsyncWebServerRequest *request)
{
	if (!request->authenticate(config.http_username, config.http_password))
	{
		return request->requestAuthentication();
	}
	if (request->hasArg("commitGNSS"))
	{
		bool En = false;
		for (uint8_t i = 0; i < request->args(); i++)
		{
			// Serial.print("SERVER ARGS ");
			// Serial.print(request->argName(i));
			// Serial.print("=");
			// Serial.println(request->arg(i));

			if (request->argName(i) == "Enable")
			{
				if (request->arg(i) != "")
				{
					// if (isValidNumber(request->arg(i)))
					if (String(request->arg(i)) == "OK")
						En = true;
				}
			}

			if (request->argName(i) == "atc")
			{
				if (request->arg(i) != "")
				{
					strcpy(config.gnss_at_command, request->arg(i).c_str());
				}
				else
				{
					memset(config.gnss_at_command, 0, sizeof(config.gnss_at_command));
				}
			}

			if (request->argName(i) == "Host")
			{
				if (request->arg(i) != "")
				{
					strcpy(config.gnss_tcp_host, request->arg(i).c_str());
				}
			}

			if (request->argName(i) == "Port")
			{
				if (isValidNumber(request->arg(i)))
				{
					config.gnss_tcp_port = request->arg(i).toInt();
				}
			}

			if (request->argName(i) == "channel")
			{
				if (isValidNumber(request->arg(i)))
				{
					config.gnss_channel = request->arg(i).toInt();
				}
			}
		}

		config.gnss_enable = En;
		saveEEPROM();
		String html = "OK";
		request->send(200, "text/html", html);
	}
	else if (request->hasArg("commitUART0"))
	{
		bool En = false;
		for (uint8_t i = 0; i < request->args(); i++)
		{
			// Serial.print("SERVER ARGS ");
			// Serial.print(request->argName(i));
			// Serial.print("=");
			// Serial.println(request->arg(i));

			if (request->argName(i) == "Enable")
			{
				if (request->arg(i) != "")
				{
					if (String(request->arg(i)) == "OK")
						En = true;
				}
			}

			if (request->argName(i) == "baudrate")
			{
				if (isValidNumber(request->arg(i)))
				{
					config.uart0_baudrate = request->arg(i).toInt();
				}
			}

			if (request->argName(i) == "rx")
			{
				if (isValidNumber(request->arg(i)))
				{
					config.uart0_rx_gpio = request->arg(i).toInt();
				}
			}

			if (request->argName(i) == "tx")
			{
				if (isValidNumber(request->arg(i)))
				{
					config.uart0_tx_gpio = request->arg(i).toInt();
				}
			}

			if (request->argName(i) == "rts")
			{
				if (isValidNumber(request->arg(i)))
				{
					config.uart0_rts_gpio = request->arg(i).toInt();
				}
			}
		}

		config.uart0_enable = En;
		saveEEPROM();
		String html = "OK";
		request->send(200, "text/html", html);
	}
	else if (request->hasArg("commitUART1"))
	{
		bool En = false;
		for (uint8_t i = 0; i < request->args(); i++)
		{
			// Serial.print("SERVER ARGS ");
			// Serial.print(request->argName(i));
			// Serial.print("=");
			// Serial.println(request->arg(i));

			if (request->argName(i) == "Enable")
			{
				if (request->arg(i) != "")
				{
					if (String(request->arg(i)) == "OK")
						En = true;
				}
			}

			if (request->argName(i) == "baudrate")
			{
				if (isValidNumber(request->arg(i)))
				{
					config.uart1_baudrate = request->arg(i).toInt();
				}
			}

			if (request->argName(i) == "rx")
			{
				if (isValidNumber(request->arg(i)))
				{
					config.uart1_rx_gpio = request->arg(i).toInt();
				}
			}

			if (request->argName(i) == "tx")
			{
				if (isValidNumber(request->arg(i)))
				{
					config.uart1_tx_gpio = request->arg(i).toInt();
				}
			}

			if (request->argName(i) == "rts")
			{
				if (isValidNumber(request->arg(i)))
				{
					config.uart1_rts_gpio = request->arg(i).toInt();
				}
			}
		}

		config.uart1_enable = En;
		saveEEPROM();
		String html = "OK";
		request->send(200, "text/html", html);
	}
	else if (request->hasArg("commitUART2"))
	{
		bool En = false;
		for (uint8_t i = 0; i < request->args(); i++)
		{
			// Serial.print("SERVER ARGS ");
			// Serial.print(request->argName(i));
			// Serial.print("=");
			// Serial.println(request->arg(i));

			if (request->argName(i) == "Enable")
			{
				if (request->arg(i) != "")
				{
					if (String(request->arg(i)) == "OK")
						En = true;
				}
			}

			if (request->argName(i) == "baudrate")
			{
				if (isValidNumber(request->arg(i)))
				{
					config.uart2_baudrate = request->arg(i).toInt();
				}
			}

			if (request->argName(i) == "rx")
			{
				if (isValidNumber(request->arg(i)))
				{
					config.uart2_rx_gpio = request->arg(i).toInt();
				}
			}

			if (request->argName(i) == "tx")
			{
				if (isValidNumber(request->arg(i)))
				{
					config.uart2_tx_gpio = request->arg(i).toInt();
				}
			}

			if (request->argName(i) == "rts")
			{
				if (isValidNumber(request->arg(i)))
				{
					config.uart2_rts_gpio = request->arg(i).toInt();
				}
			}
		}

		config.uart2_enable = En;
		saveEEPROM();
		String html = "OK";
		request->send(200, "text/html", html);
	}
	else if (request->hasArg("commitMODBUS"))
	{
		bool En = false;
		for (uint8_t i = 0; i < request->args(); i++)
		{
			// Serial.print("SERVER ARGS ");
			// Serial.print(request->argName(i));
			// Serial.print("=");
			// Serial.println(request->arg(i));

			if (request->argName(i) == "Enable")
			{
				if (request->arg(i) != "")
				{
					// if (isValidNumber(request->arg(i)))
					if (String(request->arg(i)) == "OK")
						En = true;
				}
			}

			if (request->argName(i) == "channel")
			{
				if (isValidNumber(request->arg(i)))
				{
					config.modbus_channel = request->arg(i).toInt();
				}
			}

			if (request->argName(i) == "address")
			{
				if (isValidNumber(request->arg(i)))
				{
					config.modbus_address = request->arg(i).toInt();
				}
			}

			if (request->argName(i) == "de")
			{
				if (request->arg(i) != "")
				{
					config.modbus_de_gpio = request->arg(i).toInt();
				}
			}
		}

		config.modbus_enable = En;
		saveEEPROM();
		String html = "OK";
		request->send(200, "text/html", html);
	}
	else if (request->hasArg("commitTNC"))
	{
		bool En = false;
		for (uint8_t i = 0; i < request->args(); i++)
		{
			// Serial.print("SERVER ARGS ");
			// Serial.print(request->argName(i));
			// Serial.print("=");
			// Serial.println(request->arg(i));

			if (request->argName(i) == "Enable")
			{
				if (request->arg(i) != "")
				{
					// if (isValidNumber(request->arg(i)))
					if (String(request->arg(i)) == "OK")
						En = true;
				}
			}

			if (request->argName(i) == "channel")
			{
				if (isValidNumber(request->arg(i)))
				{
					config.ext_tnc_channel = request->arg(i).toInt();
				}
			}

			if (request->argName(i) == "mode")
			{
				if (isValidNumber(request->arg(i)))
				{
					config.ext_tnc_mode = request->arg(i).toInt();
				}
			}
		}

		config.ext_tnc_enable = En;
		saveEEPROM();
		String html = "OK";
		request->send(200, "text/html", html);
	}
	else if (request->hasArg("commitONEWIRE"))
	{
		bool En = false;
		for (uint8_t i = 0; i < request->args(); i++)
		{
			// Serial.print("SERVER ARGS ");
			// Serial.print(request->argName(i));
			// Serial.print("=");
			// Serial.println(request->arg(i));

			if (request->argName(i) == "Enable")
			{
				if (request->arg(i) != "")
				{
					// if (isValidNumber(request->arg(i)))
					if (String(request->arg(i)) == "OK")
						En = true;
				}
			}

			if (request->argName(i) == "data")
			{
				if (request->arg(i) != "")
				{
					config.onewire_gpio = request->arg(i).toInt();
				}
			}
		}

		config.onewire_enable = En;
		saveEEPROM();
		String html = "OK";
		request->send(200, "text/html", html);
	}
	else if (request->hasArg("commitRF"))
	{
		for (uint8_t i = 0; i < request->args(); i++)
		{
			// Serial.print("SERVER ARGS ");
			// Serial.print(request->argName(i));
			// Serial.print("=");
			// Serial.println(request->arg(i));

			if (request->argName(i) == "sql_active")
			{
				if (request->arg(i) != "")
				{
					config.rf_sql_active = (bool)request->arg(i).toInt();
				}
			}
			if (request->argName(i) == "pd_active")
			{
				if (request->arg(i) != "")
				{
					config.rf_pd_active = (bool)request->arg(i).toInt();
				}
			}
			if (request->argName(i) == "pwr_active")
			{
				if (request->arg(i) != "")
				{
					config.rf_pwr_active = (bool)request->arg(i).toInt();
				}
			}
			if (request->argName(i) == "ptt_active")
			{
				if (request->arg(i) != "")
				{
					config.rf_ptt_active = (bool)request->arg(i).toInt();
				}
			}

			if (request->argName(i) == "baudrate")
			{
				if (request->arg(i) != "")
				{
					config.rf_baudrate = request->arg(i).toInt();
				}
			}

			if (request->argName(i) == "rx")
			{
				if (request->arg(i) != "")
				{
					config.rf_rx_gpio = request->arg(i).toInt();
				}
			}

			if (request->argName(i) == "tx")
			{
				if (request->arg(i) != "")
				{
					config.rf_tx_gpio = request->arg(i).toInt();
				}
			}

			if (request->argName(i) == "pd")
			{
				if (request->arg(i) != "")
				{
					config.rf_pd_gpio = request->arg(i).toInt();
				}
			}

			if (request->argName(i) == "pwr")
			{
				if (request->arg(i) != "")
				{
					config.rf_pwr_gpio = request->arg(i).toInt();
				}
			}
			if (request->argName(i) == "ptt")
			{
				if (request->arg(i) != "")
				{
					config.rf_ptt_gpio = request->arg(i).toInt();
				}
			}
			if (request->argName(i) == "sql")
			{
				if (request->arg(i) != "")
				{
					config.rf_sql_gpio = request->arg(i).toInt();
				}
			}
			if (request->argName(i) == "atten")
			{
				if (request->arg(i) != "")
				{
					config.adc_atten = request->arg(i).toInt();
				}
			}
			if (request->argName(i) == "offset")
			{
				if (request->arg(i) != "")
				{
					config.adc_dc_offset = request->arg(i).toInt();
				}
			}
		}
		saveEEPROM();
		String html = "OK";
		request->send(200, "text/html", html);
	}
	else if (request->hasArg("commitI2C0"))
	{
		bool En = false;
		for (uint8_t i = 0; i < request->args(); i++)
		{
			// Serial.print("SERVER ARGS ");
			// Serial.print(request->argName(i));
			// Serial.print("=");
			// Serial.println(request->arg(i));

			if (request->argName(i) == "Enable")
			{
				if (request->arg(i) != "")
				{
					if (String(request->arg(i)) == "OK")
						En = true;
				}
			}

			if (request->argName(i) == "sda")
			{
				if (request->arg(i) != "")
				{
					config.i2c_sda_pin = request->arg(i).toInt();
				}
			}
			if (request->argName(i) == "sck")
			{
				if (request->arg(i) != "")
				{
					config.i2c_sck_pin = request->arg(i).toInt();
				}
			}
			if (request->argName(i) == "freq")
			{
				if (request->arg(i) != "")
				{
					config.i2c_freq = request->arg(i).toInt();
				}
			}
		}

		config.i2c_enable = En;
		saveEEPROM();
		String html = "OK";
		request->send(200, "text/html", html);
	}
	else if (request->hasArg("commitI2C1"))
	{
		bool En = false;
		for (uint8_t i = 0; i < request->args(); i++)
		{
			// Serial.print("SERVER ARGS ");
			// Serial.print(request->argName(i));
			// Serial.print("=");
			// Serial.println(request->arg(i));

			if (request->argName(i) == "Enable")
			{
				if (request->arg(i) != "")
				{
					if (String(request->arg(i)) == "OK")
						En = true;
				}
			}

			if (request->argName(i) == "sda")
			{
				if (request->arg(i) != "")
				{
					config.i2c1_sda_pin = request->arg(i).toInt();
				}
			}
			if (request->argName(i) == "sck")
			{
				if (request->arg(i) != "")
				{
					config.i2c1_sck_pin = request->arg(i).toInt();
				}
			}
			if (request->argName(i) == "freq")
			{
				if (request->arg(i) != "")
				{
					config.i2c1_freq = request->arg(i).toInt();
				}
			}
		}

		config.i2c1_enable = En;
		saveEEPROM();
		String html = "OK";
		request->send(200, "text/html", html);
	}
	else if (request->hasArg("commitCOUNTER0"))
	{
		bool En = false;
		for (uint8_t i = 0; i < request->args(); i++)
		{
			// Serial.print("SERVER ARGS ");
			// Serial.print(request->argName(i));
			// Serial.print("=");
			// Serial.println(request->arg(i));

			if (request->argName(i) == "Enable")
			{
				if (request->arg(i) != "")
				{
					if (String(request->arg(i)) == "OK")
						En = true;
				}
			}

			if (request->argName(i) == "gpio")
			{
				if (request->arg(i) != "")
				{
					config.counter0_gpio = request->arg(i).toInt();
				}
			}
			if (request->argName(i) == "active")
			{
				if (request->arg(i) != "")
				{
					config.counter0_active = (bool)request->arg(i).toInt();
				}
			}
		}

		config.counter0_enable = En;
		saveEEPROM();
		String html = "OK";
		request->send(200, "text/html", html);
	}
	else if (request->hasArg("commitCOUNTER1"))
	{
		bool En = false;
		for (uint8_t i = 0; i < request->args(); i++)
		{
			// Serial.print("SERVER ARGS ");
			// Serial.print(request->argName(i));
			// Serial.print("=");
			// Serial.println(request->arg(i));

			if (request->argName(i) == "Enable")
			{
				if (request->arg(i) != "")
				{
					if (String(request->arg(i)) == "OK")
						En = true;
				}
			}

			if (request->argName(i) == "gpio")
			{
				if (request->arg(i) != "")
				{
					config.counter1_gpio = request->arg(i).toInt();
				}
			}
			if (request->argName(i) == "active")
			{
				if (request->arg(i) != "")
				{
					config.counter1_active = (bool)request->arg(i).toInt();
				}
			}
		}

		config.counter0_enable = En;
		saveEEPROM();
		String html = "OK";
		request->send(200, "text/html", html);
	}
	else
	{

		String html = "<script type=\"text/javascript\">\n";
		html += "$('form').submit(function (e) {\n";
		html += "e.preventDefault();\n";
		html += "var data = new FormData(e.currentTarget);\n";
		html += "if(e.currentTarget.id===\"formUART0\") document.getElementById(\"submitURAT0\").disabled=true;\n";
		html += "if(e.currentTarget.id===\"formUART1\") document.getElementById(\"submitURAT1\").disabled=true;\n";
		html += "if(e.currentTarget.id===\"formUART1\") document.getElementById(\"submitURAT1\").disabled=true;\n";
		html += "if(e.currentTarget.id===\"formGNSS\") document.getElementById(\"submitGNSS\").disabled=true;\n";
		html += "if(e.currentTarget.id===\"formMODBUS\") document.getElementById(\"submitMODBUS\").disabled=true;\n";
		html += "if(e.currentTarget.id===\"formTNC\") document.getElementById(\"submitTNC\").disabled=true;\n";
		// html += "if(e.currentTarget.id===\"formONEWIRE\") document.getElementById(\"submitONEWIRE\").disabled=true;\n";
		html += "if(e.currentTarget.id===\"formRF\") document.getElementById(\"submitRF\").disabled=true;\n";
		html += "if(e.currentTarget.id===\"formI2C0\") document.getElementById(\"submitI2C0\").disabled=true;\n";
		html += "if(e.currentTarget.id===\"formI2C1\") document.getElementById(\"submitI2C1\").disabled=true;\n";
		html += "if(e.currentTarget.id===\"formCOUNT0\") document.getElementById(\"submitCOUNT0\").disabled=true;\n";
		html += "if(e.currentTarget.id===\"formCOUNT1\") document.getElementById(\"submitCOUNT1\").disabled=true;\n";
		html += "$.ajax({\n";
		html += "url: '/mod',\n";
		html += "type: 'POST',\n";
		html += "data: data,\n";
		html += "contentType: false,\n";
		html += "processData: false,\n";
		html += "success: function (data) {\n";
		html += "alert(\"Submited Successfully\\nRequire hardware RESET!\");\n";
		html += "},\n";
		html += "error: function (data) {\n";
		html += "alert(\"An error occurred.\");\n";
		html += "}\n";
		html += "});\n";
		html += "});\n";
		html += "</script>\n";

		html += "<table style=\"text-align:unset;border-width:0px;background:unset\"><tr style=\"background:unset;vertical-align:top\"><td width=\"32%\" style=\"border:unset;\">";
		// html += "<h2>System Setting</h2>\n";
		/**************UART0(USB) Modify******************/
		html += "<form accept-charset=\"UTF-8\" action=\"#\" class=\"form-horizontal\" id=\"fromUART0\" method=\"post\">\n";
		html += "<table>\n";
		html += "<th colspan=\"2\"><span><b>UART0(USB) Modify</b></span></th>\n";
		html += "<tr>";

		String enFlage = "";
		if (config.uart0_enable)
			enFlage = "checked";
		html += "<td align=\"right\"><b>Enable</b></td>\n";
		html += "<td style=\"text-align: left;\"><label class=\"switch\"><input type=\"checkbox\" name=\"Enable\" value=\"OK\" " + enFlage + "><span class=\"slider round\"></span></label></td>\n";
		html += "</tr>\n";

		html += "<tr>\n";
		html += "<td align=\"right\"><b>RX GPIO:</b></td>\n";
		html += "<td style=\"text-align: left;\"><input min=\"-1\" max=\"39\" name=\"rx\" type=\"number\" value=\"" + String(config.uart0_rx_gpio) + "\" /></td>\n";
		html += "</tr>\n";

		html += "<tr>\n";
		html += "<td align=\"right\"><b>TX GPIO:</b></td>\n";
		html += "<td style=\"text-align: left;\"><input min=\"-1\" max=\"39\" name=\"tx\" type=\"number\" value=\"" + String(config.uart0_tx_gpio) + "\" /></td>\n";
		html += "</tr>\n";

		html += "<tr>\n";
		html += "<td align=\"right\"><b>RTS/DE GPIO:</b></td>\n";
		html += "<td style=\"text-align: left;\"><input min=\"-1\" max=\"39\"  name=\"rts\" type=\"number\" value=\"" + String(config.uart0_rts_gpio) + "\" /></td>\n";
		html += "</tr>\n";

		html += "<tr>\n";
		html += "<td align=\"right\"><b>Baudrate:</b></td>\n";
		html += "<td style=\"text-align: left;\">\n";
		html += "<select name=\"baudrate\" id=\"baudrate\">\n";
		for (int i = 0; i < 13; i++)
		{
			if (config.uart0_baudrate == baudrate[i])
				html += "<option value=\"" + String(baudrate[i]) + "\" selected>" + String(baudrate[i]) + " </option>\n";
			else
				html += "<option value=\"" + String(baudrate[i]) + "\" >" + String(baudrate[i]) + " </option>\n";
		}
		html += "</select> bps\n";
		html += "</td>\n";
		html += "</tr>\n";
		html += "<tr><td colspan=\"2\" align=\"right\">\n";
		html += "<input class=\"btn btn-primary\" id=\"submitUART0\" name=\"commitUART0\" type=\"submit\" value=\"Apply\" maxlength=\"80\"/>\n";
		html += "<input type=\"hidden\" name=\"commitUART0\"/>\n";
		html += "</td></tr></table>\n";

		html += "</form><br />\n";
		html += "</td><td width=\"32%\" style=\"border:unset;\">";

		/**************UART1 Modify******************/
		html += "<form accept-charset=\"UTF-8\" action=\"#\" class=\"form-horizontal\" id=\"fromUART1\" method=\"post\">\n";
		html += "<table>\n";
		html += "<th colspan=\"2\"><span><b>UART1 Modify</b></span></th>\n";
		html += "<tr>";

		enFlage = "";
		if (config.uart1_enable)
			enFlage = "checked";
		html += "<td align=\"right\"><b>Enable</b></td>\n";
		html += "<td style=\"text-align: left;\"><label class=\"switch\"><input type=\"checkbox\" name=\"Enable\" value=\"OK\" " + enFlage + "><span class=\"slider round\"></span></label></td>\n";
		html += "</tr>\n";

		html += "<tr>\n";
		html += "<td align=\"right\"><b>RX GPIO:</b></td>\n";
		html += "<td style=\"text-align: left;\"><input min=\"-1\" max=\"39\" name=\"rx\" type=\"number\" value=\"" + String(config.uart1_rx_gpio) + "\" /></td>\n";
		html += "</tr>\n";

		html += "<tr>\n";
		html += "<td align=\"right\"><b>TX GPIO:</b></td>\n";
		html += "<td style=\"text-align: left;\"><input min=\"-1\" max=\"39\" name=\"tx\" type=\"number\" value=\"" + String(config.uart1_tx_gpio) + "\" /></td>\n";
		html += "</tr>\n";

		html += "<tr>\n";
		html += "<td align=\"right\"><b>RTS/DE GPIO:</b></td>\n";
		html += "<td style=\"text-align: left;\"><input min=\"-1\" max=\"39\"  name=\"rts\" type=\"number\" value=\"" + String(config.uart1_rts_gpio) + "\" /></td>\n";
		html += "</tr>\n";

		html += "<tr>\n";
		html += "<td align=\"right\"><b>Baudrate:</b></td>\n";
		html += "<td style=\"text-align: left;\">\n";
		html += "<select name=\"baudrate\" id=\"baudrate\">\n";
		for (int i = 0; i < 13; i++)
		{
			if (config.uart1_baudrate == baudrate[i])
				html += "<option value=\"" + String(baudrate[i]) + "\" selected>" + String(baudrate[i]) + " </option>\n";
			else
				html += "<option value=\"" + String(baudrate[i]) + "\" >" + String(baudrate[i]) + " </option>\n";
		}
		html += "</select> bps\n";
		html += "</td>\n";
		html += "</tr>\n";
		html += "<tr><td colspan=\"2\" align=\"right\">\n";
		html += "<input class=\"btn btn-primary\" id=\"submitUART1\" name=\"commitUART1\" type=\"submit\" value=\"Apply\" maxlength=\"80\"/>\n";
		html += "<input type=\"hidden\" name=\"commitUART1\"/>\n";
		html += "</td></tr></table>\n";

		html += "</form><br />\n";
		html += "</td><td width=\"32%\" style=\"border:unset;\">";

		/**************UART2 Modify******************/
		html += "<form accept-charset=\"UTF-8\" action=\"#\" class=\"form-horizontal\" id=\"fromUART2\" method=\"post\">\n";
		html += "<table>\n";
		html += "<th colspan=\"2\"><span><b>UART2 Modify</b></span></th>\n";
		html += "<tr>";

		enFlage = "";
		if (config.uart2_enable)
			enFlage = "checked";
		html += "<td align=\"right\"><b>Enable</b></td>\n";
		html += "<td style=\"text-align: left;\"><label class=\"switch\"><input type=\"checkbox\" name=\"Enable\" value=\"OK\" " + enFlage + "><span class=\"slider round\"></span></label></td>\n";
		html += "</tr>\n";

		html += "<tr>\n";
		html += "<td align=\"right\"><b>RX GPIO:</b></td>\n";
		html += "<td style=\"text-align: left;\"><input min=\"-1\" max=\"39\" name=\"rx\" type=\"number\" value=\"" + String(config.uart2_rx_gpio) + "\" /></td>\n";
		html += "</tr>\n";

		html += "<tr>\n";
		html += "<td align=\"right\"><b>TX GPIO:</b></td>\n";
		html += "<td style=\"text-align: left;\"><input min=\"-1\" max=\"39\" name=\"tx\" type=\"number\" value=\"" + String(config.uart2_tx_gpio) + "\" /></td>\n";
		html += "</tr>\n";

		html += "<tr>\n";
		html += "<td align=\"right\"><b>RTS/DE GPIO:</b></td>\n";
		html += "<td style=\"text-align: left;\"><input min=\"-1\" max=\"39\"  name=\"rts\" type=\"number\" value=\"" + String(config.uart2_rts_gpio) + "\" /></td>\n";
		html += "</tr>\n";

		html += "<tr>\n";
		html += "<td align=\"right\"><b>Baudrate:</b></td>\n";
		html += "<td style=\"text-align: left;\">\n";
		html += "<select name=\"baudrate\" id=\"baudrate\">\n";
		for (int i = 0; i < 13; i++)
		{
			if (config.uart2_baudrate == baudrate[i])
				html += "<option value=\"" + String(baudrate[i]) + "\" selected>" + String(baudrate[i]) + " </option>\n";
			else
				html += "<option value=\"" + String(baudrate[i]) + "\" >" + String(baudrate[i]) + " </option>\n";
		}
		html += "</select> bps\n";
		html += "</td>\n";
		html += "</tr>\n";
		html += "<tr><td colspan=\"2\" align=\"right\">\n";
		html += "<input class=\"btn btn-primary\" id=\"submitUART2\" name=\"commitUART2\" type=\"submit\" value=\"Apply\" maxlength=\"80\"/>\n";
		html += "<input type=\"hidden\" name=\"commitUART2\"/>\n";
		html += "</td></tr></table>\n";

		html += "</form><br />\n";
		html += "</td></tr></table>\n";

		// html += "</td><td width=\"32%\" style=\"border:unset;\">";

		/**************1-Wire Modify******************/
		// html += "<form accept-charset=\"UTF-8\" action=\"#\" class=\"form-horizontal\" id=\"fromONEWIRE\" method=\"post\">\n";
		// html += "<table>\n";
		// html += "<th colspan=\"2\"><span><b>1-Wire Bus Modify</b></span></th>\n";
		// html += "<tr>";

		// syncFlage = "";
		// if (config.onewire_enable)
		// 	syncFlage = "checked";
		// html += "<td align=\"right\"><b>Enable</b></td>\n";
		// html += "<td style=\"text-align: left;\"><label class=\"switch\"><input type=\"checkbox\" name=\"Enable\" value=\"OK\" " + syncFlage + "><span class=\"slider round\"></span></label></td>\n";
		// html += "</tr>\n";

		// html += "<tr>\n";
		// html += "<td align=\"right\"><b>GPIO:</b></td>\n";
		// html += "<td style=\"text-align: left;\"><input min=\"-1\" max=\"39\" name=\"data\" type=\"number\" value=\"" + String(config.onewire_gpio) + "\" /></td>\n";
		// html += "</tr>\n";

		// html += "<tr><td colspan=\"2\" align=\"right\">\n";
		// html += "<input class=\"btn btn-primary\" id=\"submitONEWIRE\" name=\"commitONEWIRE\" type=\"submit\" value=\"Apply\" maxlength=\"80\"/>\n";
		// html += "<input type=\"hidden\" name=\"commitONEWIRE\"/>\n";
		// html += "</td></tr></table>\n";
		// html += "</form><br />\n";

		// html += "</td></tr></table>\n";

		html += "<table style=\"text-align:unset;border-width:0px;background:unset\"><tr style=\"background:unset;vertical-align:top\"><td width=\"50%\" style=\"border:unset;vertical-align:top\">";
		/**************RF GPIO******************/
		html += "<form accept-charset=\"UTF-8\" action=\"#\" class=\"form-horizontal\" id=\"fromRF\" method=\"post\">\n";
		html += "<table>\n";
		html += "<th colspan=\"2\"><span><b>RF GPIO Modify</b></span></th>\n";
		html += "<tr>";

		html += "<tr>\n";
		html += "<td align=\"right\"><b>Baudrate:</b></td>\n";
		html += "<td style=\"text-align: left;\">\n";
		html += "<select name=\"baudrate\" id=\"baudrate\">\n";
		for (int i = 0; i < 13; i++)
		{
			if (config.rf_baudrate == baudrate[i])
				html += "<option value=\"" + String(baudrate[i]) + "\" selected>" + String(baudrate[i]) + " </option>\n";
			else
				html += "<option value=\"" + String(baudrate[i]) + "\" >" + String(baudrate[i]) + " </option>\n";
		}
		html += "</select> bps\n";
		html += "</td>\n";
		html += "</tr>\n";

		html += "<tr>\n";
		html += "<td align=\"right\"><b>ADC Attenuation:</b></td>\n";
		html += "<td style=\"text-align: left;\">\n";
		html += "<select name=\"atten\" id=\"atten\">\n";
		for (int i = 0; i < 4; i++)
		{
			if (config.adc_atten == i)
				html += "<option value=\"" + String(i) + "\" selected>" + String(ADC_ATTEN[i]) + " </option>\n";
			else
				html += "<option value=\"" + String(i) + "\" >" + String(ADC_ATTEN[i]) + " </option>\n";
		}
		html += "</select>\n";
		html += "</td>\n";
		html += "</tr>\n";

		html += "<tr>\n";
		html += "<td align=\"right\"><b>ADC DC OFFSET:</b></td>\n";
		html += "<td style=\"text-align: left;\"><input min=\"100\" max=\"2500\" name=\"offset\" type=\"number\" value=\"" + String(config.adc_dc_offset) + "\" /> mV     (Current: " + String(offset) + " mV)</td>\n";
		html += "</tr>\n";

		html += "<tr>\n";
		html += "<td align=\"right\"><b>RX GPIO:</b></td>\n";
		html += "<td style=\"text-align: left;\"><input min=\"-1\" max=\"39\" name=\"rx\" type=\"number\" value=\"" + String(config.rf_rx_gpio) + "\" /></td>\n";
		html += "</tr>\n";

		html += "<tr>\n";
		html += "<td align=\"right\"><b>TX GPIO:</b></td>\n";
		html += "<td style=\"text-align: left;\"><input min=\"-1\" max=\"39\" name=\"tx\" type=\"number\" value=\"" + String(config.rf_tx_gpio) + "\" /></td>\n";
		html += "</tr>\n";

		String LowFlag = "", HighFlag = "";
		LowFlag = "";
		HighFlag = "";
		if (config.rf_pd_active)
			HighFlag = "checked=\"checked\"";
		else
			LowFlag = "checked=\"checked\"";
		html += "<tr>\n";
		html += "<td align=\"right\"><b>PD GPIO:</b></td>\n";
		html += "<td style=\"text-align: left;\"><input min=\"-1\" max=\"39\"  name=\"pd\" type=\"number\" value=\"" + String(config.rf_pd_gpio) + "\" /> Active:<input type=\"radio\" name=\"pd_active\" value=\"0\" " + LowFlag + "/>LOW <input type=\"radio\" name=\"pd_active\" value=\"1\" " + HighFlag + "/>HIGH </td>\n";
		html += "</tr>\n";

		LowFlag = "";
		HighFlag = "";
		if (config.rf_pwr_active)
			HighFlag = "checked=\"checked\"";
		else
			LowFlag = "checked=\"checked\"";
		html += "<tr>\n";
		html += "<td align=\"right\"><b>H/L GPIO:</b></td>\n";
		html += "<td style=\"text-align: left;\"><input min=\"-1\" max=\"39\"  name=\"pwr\" type=\"number\" value=\"" + String(config.rf_pwr_gpio) + "\" /> Active:<input type=\"radio\" name=\"pwr_active\" value=\"0\" " + LowFlag + "/>LOW <input type=\"radio\" name=\"pwr_active\" value=\"1\" " + HighFlag + "/>HIGH </td>\n";
		html += "</tr>\n";

		LowFlag = "";
		HighFlag = "";
		if (config.rf_sql_active)
			HighFlag = "checked=\"checked\"";
		else
			LowFlag = "checked=\"checked\"";
		html += "<tr>\n";
		html += "<td align=\"right\"><b>SQL GPIO:</b></td>\n";
		html += "<td style=\"text-align: left;\"><input min=\"-1\" max=\"39\"  name=\"sql\" type=\"number\" value=\"" + String(config.rf_sql_gpio) + "\" /> Active:<input type=\"radio\" name=\"sql_active\" value=\"0\" " + LowFlag + "/>LOW <input type=\"radio\" name=\"sql_active\" value=\"1\" " + HighFlag + "/>HIGH </td>\n";
		html += "</tr>\n";

		LowFlag = "";
		HighFlag = "";
		if (config.rf_ptt_active)
			HighFlag = "checked=\"checked\"";
		else
			LowFlag = "checked=\"checked\"";
		html += "<tr>\n";
		html += "<td align=\"right\"><b>PTT GPIO:</b></td>\n";
		html += "<td style=\"text-align: left;\"><input min=\"-1\" max=\"39\"  name=\"ptt\" type=\"number\" value=\"" + String(config.rf_ptt_gpio) + "\" /> Active:<input type=\"radio\" name=\"ptt_active\" value=\"0\" " + LowFlag + "/>LOW <input type=\"radio\" name=\"ptt_active\" value=\"1\" " + HighFlag + "/>HIGH </td>\n";
		html += "</tr>\n";

		html += "<tr><td colspan=\"2\" align=\"right\">\n";
		html += "<input class=\"btn btn-primary\" id=\"submitRF\" name=\"commitRF\" type=\"submit\" value=\"Apply\" maxlength=\"80\"/>\n";
		html += "<input type=\"hidden\" name=\"commitRF\"/>\n";
		html += "</td></tr></table>\n";
		html += "</form>\n";

		html += "</td><td width=\"23%\" style=\"border:unset;\">";

		/**************I2C_0 Modify******************/
		html += "<form accept-charset=\"UTF-8\" action=\"#\" class=\"form-horizontal\" id=\"fromI2C0\" method=\"post\">\n";
		html += "<table>\n";
		html += "<th colspan=\"2\"><span><b>I2C_0(OLED) Modify</b></span></th>\n";
		html += "<tr>";

		String syncFlage = "";
		if (config.i2c_enable)
			syncFlage = "checked";
		html += "<td align=\"right\"><b>Enable</b></td>\n";
		html += "<td style=\"text-align: left;\"><label class=\"switch\"><input type=\"checkbox\" name=\"Enable\" value=\"OK\" " + syncFlage + "><span class=\"slider round\"></span></label></td>\n";
		html += "</tr>\n";

		html += "<tr>\n";
		html += "<td align=\"right\"><b>SDA GPIO:</b></td>\n";
		html += "<td style=\"text-align: left;\"><input min=\"-1\" max=\"39\" name=\"sda\" type=\"number\" value=\"" + String(config.i2c_sda_pin) + "\" /></td>\n";
		html += "</tr>\n";

		html += "<tr>\n";
		html += "<td align=\"right\"><b>SCK GPIO:</b></td>\n";
		html += "<td style=\"text-align: left;\"><input min=\"-1\" max=\"39\" name=\"sck\" type=\"number\" value=\"" + String(config.i2c_sck_pin) + "\" /></td>\n";
		html += "</tr>\n";

		html += "<tr>\n";
		html += "<td align=\"right\"><b>Frequency:</b></td>\n";
		html += "<td style=\"text-align: left;\"><input min=\"1000\" max=\"800000\" name=\"freq\" type=\"number\" value=\"" + String(config.i2c_freq) + "\" /></td>\n";
		html += "</tr>\n";

		html += "<tr><td colspan=\"2\" align=\"right\">\n";
		html += "<input class=\"btn btn-primary\" id=\"submitI2C0\" name=\"commitI2C0\" type=\"submit\" value=\"Apply\" maxlength=\"80\"/>\n";
		html += "<input type=\"hidden\" name=\"commitI2C0\"/>\n";
		html += "</td></tr></table>\n";
		html += "</form>\n";

		/**************Counter_0 Modify******************/
		html += "<form accept-charset=\"UTF-8\" action=\"#\" class=\"form-horizontal\" id=\"fromCOUNTER0\" method=\"post\">\n";
		html += "<table>\n";
		html += "<th colspan=\"2\"><span><b>Counter_0 Modify</b></span></th>\n";
		html += "<tr>";

		syncFlage = "";
		if (config.counter0_enable)
			syncFlage = "checked";
		html += "<td align=\"right\"><b>Enable</b></td>\n";
		html += "<td style=\"text-align: left;\"><label class=\"switch\"><input type=\"checkbox\" name=\"Enable\" value=\"OK\" " + syncFlage + "><span class=\"slider round\"></span></label></td>\n";
		html += "</tr>\n";

		html += "<tr>\n";
		html += "<td align=\"right\"><b>INPUT GPIO:</b></td>\n";
		html += "<td style=\"text-align: left;\"><input min=\"-1\" max=\"39\" name=\"gpio\" type=\"number\" value=\"" + String(config.counter0_gpio) + "\" /></td>\n";
		html += "</tr>\n";

		LowFlag = "";
		HighFlag = "";
		if (config.counter0_active)
			HighFlag = "checked=\"checked\"";
		else
			LowFlag = "checked=\"checked\"";
		html += "<tr>\n";
		html += "<td align=\"right\">Active</td>\n";
		html += "<td style=\"text-align: left;\"><input type=\"radio\" name=\"active\" value=\"0\" " + LowFlag + "/>LOW <input type=\"radio\" name=\"active\" value=\"1\" " + HighFlag + "/>HIGH </td>\n";
		html += "</tr>\n";

		html += "<tr><td colspan=\"2\" align=\"right\">\n";
		html += "<input class=\"btn btn-primary\" id=\"submitCOUNTER0\" name=\"commitCOUNTER0\" type=\"submit\" value=\"Apply\" maxlength=\"80\"/>\n";
		html += "<input type=\"hidden\" name=\"commitCOUNTER0\"/>\n";
		html += "</td></tr></table>\n";
		html += "</form>\n";

		html += "</td><td width=\"23%\" style=\"border:unset;\">";
		/**************I2C_1 Modify******************/
		html += "<form accept-charset=\"UTF-8\" action=\"#\" class=\"form-horizontal\" id=\"fromI2C1\" method=\"post\">\n";
		html += "<table>\n";
		html += "<th colspan=\"2\"><span><b>I2C_1 Modify</b></span></th>\n";
		html += "<tr>";

		syncFlage = "";
		if (config.i2c1_enable)
			syncFlage = "checked";
		html += "<td align=\"right\"><b>Enable</b></td>\n";
		html += "<td style=\"text-align: left;\"><label class=\"switch\"><input type=\"checkbox\" name=\"Enable\" value=\"OK\" " + syncFlage + "><span class=\"slider round\"></span></label></td>\n";
		html += "</tr>\n";

		html += "<tr>\n";
		html += "<td align=\"right\"><b>SDA GPIO:</b></td>\n";
		html += "<td style=\"text-align: left;\"><input min=\"-1\" max=\"39\" name=\"sda\" type=\"number\" value=\"" + String(config.i2c1_sda_pin) + "\" /></td>\n";
		html += "</tr>\n";

		html += "<tr>\n";
		html += "<td align=\"right\"><b>SCK GPIO:</b></td>\n";
		html += "<td style=\"text-align: left;\"><input min=\"-1\" max=\"39\" name=\"sck\" type=\"number\" value=\"" + String(config.i2c1_sck_pin) + "\" /></td>\n";
		html += "</tr>\n";

		html += "<tr>\n";
		html += "<td align=\"right\"><b>Frequency:</b></td>\n";
		html += "<td style=\"text-align: left;\"><input min=\"1000\" max=\"800000\" name=\"freq\" type=\"number\" value=\"" + String(config.i2c1_freq) + "\" /></td>\n";
		html += "</tr>\n";

		html += "<tr><td colspan=\"2\" align=\"right\">\n";
		html += "<input class=\"btn btn-primary\" id=\"submitI2C1\" name=\"commitI2C1\" type=\"submit\" value=\"Apply\" maxlength=\"80\"/>\n";
		html += "<input type=\"hidden\" name=\"commitI2C1\"/>\n";
		html += "</td></tr></table>\n";
		html += "</form>\n";

		/**************Counter_1 Modify******************/
		html += "<form accept-charset=\"UTF-8\" action=\"#\" class=\"form-horizontal\" id=\"fromCOUNTER1\" method=\"post\">\n";
		html += "<table>\n";
		html += "<th colspan=\"2\"><span><b>Counter_1 Modify</b></span></th>\n";
		html += "<tr>";

		syncFlage = "";
		if (config.counter1_enable)
			syncFlage = "checked";
		html += "<td align=\"right\"><b>Enable</b></td>\n";
		html += "<td style=\"text-align: left;\"><label class=\"switch\"><input type=\"checkbox\" name=\"Enable\" value=\"OK\" " + syncFlage + "><span class=\"slider round\"></span></label></td>\n";
		html += "</tr>\n";

		html += "<tr>\n";
		html += "<td align=\"right\"><b>INPUT GPIO:</b></td>\n";
		html += "<td style=\"text-align: left;\"><input min=\"-1\" max=\"39\" name=\"gpio\" type=\"number\" value=\"" + String(config.counter1_gpio) + "\" /></td>\n";
		html += "</tr>\n";

		LowFlag = "";
		HighFlag = "";
		if (config.counter1_active)
			HighFlag = "checked=\"checked\"";
		else
			LowFlag = "checked=\"checked\"";
		html += "<tr>\n";
		html += "<td align=\"right\">Active</td>\n";
		html += "<td style=\"text-align: left;\"><input type=\"radio\" name=\"active\" value=\"0\" " + LowFlag + "/>LOW <input type=\"radio\" name=\"active\" value=\"1\" " + HighFlag + "/>HIGH </td>\n";
		html += "</tr>\n";

		html += "<tr><td colspan=\"2\" align=\"right\">\n";
		html += "<input class=\"btn btn-primary\" id=\"submitCOUNTER1\" name=\"commitCOUNTER1\" type=\"submit\" value=\"Apply\" maxlength=\"80\"/>\n";
		html += "<input type=\"hidden\" name=\"commitCOUNTER1\"/>\n";
		html += "</td></tr></table>\n";
		html += "</form>\n";

		html += "</td></tr></table>\n";

		//******************
		html += "<table style=\"text-align:unset;border-width:0px;background:unset\"><tr style=\"background:unset;vertical-align:top\"><td width=\"50%\" style=\"border:unset;vertical-align:top\">";
		/**************GNSS Modify******************/
		html += "<form accept-charset=\"UTF-8\" action=\"#\" class=\"form-horizontal\" id=\"fromGNSS\" method=\"post\">\n";
		html += "<table>\n";
		html += "<th colspan=\"2\"><span><b>GNSS Modify</b></span></th>\n";
		html += "<tr>";

		enFlage = "";
		if (config.gnss_enable)
			enFlage = "checked";
		html += "<td align=\"right\"><b>Enable</b></td>\n";
		html += "<td style=\"text-align: left;\"><label class=\"switch\"><input type=\"checkbox\" name=\"Enable\" value=\"OK\" " + enFlage + "><span class=\"slider round\"></span></label></td>\n";
		html += "</tr>\n";

		html += "<tr>\n";
		html += "<td align=\"right\"><b>PORT:</b></td>\n";
		html += "<td style=\"text-align: left;\">\n";
		html += "<select name=\"channel\" id=\"channel\">\n";
		for (int i = 0; i < 5; i++)
		{
			if (config.gnss_channel == i)
				html += "<option value=\"" + String(i) + "\" selected>" + String(GNSS_PORT[i]) + " </option>\n";
			else
				html += "<option value=\"" + String(i) + "\" >" + String(GNSS_PORT[i]) + " </option>\n";
		}
		html += "</select>\n";
		html += "</td>\n";
		html += "</tr>\n";

		html += "<td align=\"right\"><b>AT Command:</b></td>\n";
		html += "<td style=\"text-align: left;\"><input maxlength=\"30\" size=\"20\" id=\"atc\" name=\"atc\" type=\"text\" value=\"" + String(config.gnss_at_command) + "\" /></td>\n";
		html += "</tr>\n";
		html += "<td align=\"right\"><b>TCP Host:</b></td>\n";
		html += "<td style=\"text-align: left;\"><input maxlength=\"20\" size=\"15\" id=\"Host\" name=\"Host\" type=\"text\" value=\"" + String(config.gnss_tcp_host) + "\" /></td>\n";
		html += "</tr>\n";
		html += "<tr>\n";
		html += "<td align=\"right\"><b>TCP Port:</b></td>\n";
		html += "<td style=\"text-align: left;\"><input min=\"1024\" max=\"65535\"  id=\"Port\" name=\"Port\" type=\"number\" value=\"" + String(config.gnss_tcp_port) + "\" /></td>\n";
		html += "</tr>\n";

		html += "<tr><td colspan=\"2\" align=\"right\">\n";
		html += "<input class=\"btn btn-primary\" id=\"submitGNSS\" name=\"commitGNSS\" type=\"submit\" value=\"Apply\" maxlength=\"80\"/>\n";
		html += "<input type=\"hidden\" name=\"commitGNSS\"/>\n";
		html += "</td></tr></table>\n";

		html += "</form><br />\n";

		html += "</td><td width=\"23%\" style=\"border:unset;\">";

		/**************MODBUS Modify******************/
		html += "<form accept-charset=\"UTF-8\" action=\"#\" class=\"form-horizontal\" id=\"fromMODBUS\" method=\"post\">\n";
		html += "<table>\n";
		html += "<th colspan=\"2\"><span><b>MODBUS Modify</b></span></th>\n";
		html += "<tr>";

		enFlage = "";
		if (config.modbus_enable)
			enFlage = "checked";
		html += "<td align=\"right\"><b>Enable</b></td>\n";
		html += "<td style=\"text-align: left;\"><label class=\"switch\"><input type=\"checkbox\" name=\"Enable\" value=\"OK\" " + enFlage + "><span class=\"slider round\"></span></label></td>\n";
		html += "</tr>\n";

		html += "<tr>\n";
		html += "<td align=\"right\"><b>PORT:</b></td>\n";
		html += "<td style=\"text-align: left;\">\n";
		html += "<select name=\"channel\" id=\"channel\">\n";
		for (int i = 0; i < 5; i++)
		{
			if (config.modbus_channel == i)
				html += "<option value=\"" + String(i) + "\" selected>" + String(GNSS_PORT[i]) + " </option>\n";
			else
				html += "<option value=\"" + String(i) + "\" >" + String(GNSS_PORT[i]) + " </option>\n";
		}
		html += "</select>\n";
		html += "</td>\n";
		html += "</tr>\n";

		html += "<tr>\n";
		html += "<td align=\"right\"><b>Address:</b></td>\n";
		html += "<td style=\"text-align: left;\"><input min=\"-1\" max=\"39\" name=\"address\" type=\"number\" value=\"" + String(config.modbus_address) + "\" /></td>\n";
		html += "</tr>\n";

		html += "<tr>\n";
		html += "<td align=\"right\"><b>DE:</b></td>\n";
		html += "<td style=\"text-align: left;\"><input min=\"-1\" max=\"39\" name=\"de\" type=\"number\" value=\"" + String(config.modbus_de_gpio) + "\" /></td>\n";
		html += "</tr>\n";

		html += "<tr><td colspan=\"2\" align=\"right\">\n";
		html += "<input class=\"btn btn-primary\" id=\"submitMODBUS\" name=\"commitMODBUS\" type=\"submit\" value=\"Apply\" maxlength=\"80\"/>\n";
		html += "<input type=\"hidden\" name=\"commitMODBUS\"/>\n";
		html += "</td></tr></table>\n";
		html += "</form>\n";

		html += "</td><td width=\"23%\" style=\"border:unset;\">";

		/**************External TNC Modify******************/
		html += "<form accept-charset=\"UTF-8\" action=\"#\" class=\"form-horizontal\" id=\"fromTNC\" method=\"post\">\n";
		html += "<table>\n";
		html += "<th colspan=\"2\"><span><b>External TNC Modify</b></span></th>\n";
		html += "<tr>";

		enFlage = "";
		if (config.ext_tnc_enable)
			enFlage = "checked";
		html += "<td align=\"right\"><b>Enable</b></td>\n";
		html += "<td style=\"text-align: left;\"><label class=\"switch\"><input type=\"checkbox\" name=\"Enable\" value=\"OK\" " + enFlage + "><span class=\"slider round\"></span></label></td>\n";
		html += "</tr>\n";

		html += "<tr>\n";
		html += "<td align=\"right\"><b>PORT:</b></td>\n";
		html += "<td style=\"text-align: left;\">\n";
		html += "<select name=\"channel\" id=\"channel\">\n";
		for (int i = 0; i < 4; i++)
		{
			if (config.ext_tnc_channel == i)
				html += "<option value=\"" + String(i) + "\" selected>" + String(TNC_PORT[i]) + " </option>\n";
			else
				html += "<option value=\"" + String(i) + "\" >" + String(TNC_PORT[i]) + " </option>\n";
		}
		html += "</select>\n";
		html += "</td>\n";
		html += "</tr>\n";

		html += "<tr>\n";
		html += "<td align=\"right\"><b>MODE:</b></td>\n";
		html += "<td style=\"text-align: left;\">\n";
		html += "<select name=\"mode\" id=\"mode\">\n";
		for (int i = 0; i < 4; i++)
		{
			if (config.ext_tnc_mode == i)
				html += "<option value=\"" + String(i) + "\" selected>" + String(TNC_MODE[i]) + " </option>\n";
			else
				html += "<option value=\"" + String(i) + "\" >" + String(TNC_MODE[i]) + " </option>\n";
		}
		html += "</select>\n";
		html += "</td>\n";
		html += "</tr>\n";

		html += "<tr><td colspan=\"2\" align=\"right\">\n";
		html += "<input class=\"btn btn-primary\" id=\"submitTNC\" name=\"commitTNC\" type=\"submit\" value=\"Apply\" maxlength=\"80\"/>\n";
		html += "<input type=\"hidden\" name=\"commitTNC\"/>\n";
		html += "</td></tr></table>\n";
		html += "</form>\n";

		html += "</td></tr></table>\n";

		request->send(200, "text/html", html); // send to someones browser when asked
	}
}
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
