nakhonthai/ESP32IGate/include/parse_aprs.h

#ifndef APRS_DECODE_H
#define APRS_DECODE_H

#include <Arduino.h>
#include <pbuf.h>

#define PKG_ALL		 0 // Packet is of position type
#define PKG_OBJECT     1 // packet is an object
#define PKG_ITEM       2 // packet is an item
#define PKG_MESSAGE    3 // packet is a message
#define PKG_WX         4 // packet is WX data
#define PKG_TELEMETRY  5 // packet is telemetry
#define PKG_QUERY      6 // packet is a query
#define PKG_STATUS     7 // packet is status

const uint8_t Icon_TableA[][32] = {
	/*  21  */
	{0x30,0x30,0x70,0xF0,0x10,0x58,0x1C,0xFF,0x1F,0xDC,0x38,0xF0,0xF0,0x70,0x30,0x10,0x08,0x0C,0x0E,0x0F,0x08,0x1F,0x3F,0xFF,0xF8,0x3B,0x1C,0x0F,0x0F,0x0E,0x0C,0x0C},
	/*  22  */
	{0x00,0x80,0x80,0x80,0x80,0x80,0xC0,0xFE,0xFE,0xC0,0x80,0x80,0x80,0x80,0x80,0x00,0x00,0x01,0x01,0x01,0x01,0x01,0x03,0x7F,0x7F,0x03,0x01,0x01,0x01,0x01,0x01,0x00},
	/*  23  */
	{0x10,0x30,0x70,0xF0,0xF0,0x38,0xDC,0x5F,0x5F,0x9C,0x38,0xF0,0xF0,0x70,0x30,0x10,0x08,0x0C,0x0E,0x0F,0x0F,0x1C,0x3B,0xFA,0xFA,0x39,0x1C,0x0F,0x0F,0x0E,0x0C,0x08},
	/*  24  */
	{0xFF,0xFF,0xFF,0xFF,0xFF,0xFF,0xFF,0xFF,0xFF,0x63,0x9D,0xFD,0xFD,0x7D,0x83,0xFF,0xFF,0xC3,0xBD,0xBD,0xBD,0xBB,0xBB,0xDD,0xEE,0xF7,0xFB,0xFD,0xFE,0xFF,0xFF,0xFF},
	/*  25  */
	{0xFE,0xFE,0x06,0x06,0x0E,0xFC,0xF8,0x00,0x06,0x1E,0x78,0xE0,0xE0,0x78,0x1E,0x06,0x7F,0x7F,0x60,0x60,0x70,0x3F,0x1F,0x00,0x60,0x78,0x1E,0x07,0x07,0x1E,0x78,0x60},
	/*  26  */
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
const uint8_t Rain_Symbol[5] = { 0xAE, 0x4F, 0xAE, 0x4E, 0x2C };
const uint8_t Wind_Symbol[5] = { 0x1E, 0x0E, 0x1A, 0x30, 0x60 };
const uint8_t Squre2_Symbol[5] = { 0x0D, 0x0B, 0x00, 0x00, 0x00 };
const uint8_t Degree_Symbol[5] = { 0x00, 0x06, 0x09, 0x09, 0x06 };

class ParseAPRS {
	public:
		int parse_aprs(struct pbuf_t* pb);
		int parse_aprs_message(struct pbuf_t *pb);
		double direction(double lon0, double lat0, double lon1, double lat1);
		double distance(double lon0, double lat0, double lon1, double lat1);
		uint16_t passCode(char *theCall);
		String deg2lon(double deg);
		String deg2lat(double deg);
	private:
		float filter_lat2rad(float lat);
		float filter_lon2rad(float lon);
		int valid_sym_table_compressed(char c);
		int valid_sym_table_uncompressed(char c);
		int pbuf_fill_pos(struct pbuf_t *pb, const float lat, const float lng, const char sym_table, const char sym_code);
		int get_symbol_from_dstcall_twochar(const char c1, const char c2, char *sym_table, char *sym_code);
		int get_symbol_from_dstcall(struct pbuf_t *pb, char *sym_table, char *sym_code);
		int parse_aprs_nmea(struct pbuf_t *pb, const char *body, const char *body_end);
		int parse_aprs_telem(struct pbuf_t *pb, const char *body, const char *body_end);
		int parse_aprs_mice(struct pbuf_t *pb, const unsigned char *body, const unsigned char *body_end);
		int parse_aprs_compressed(struct pbuf_t *pb, const char *body, const char *body_end);
		int parse_aprs_uncompressed(struct pbuf_t *pb, const char *body, const char *body_end);
		int parse_aprs_object(struct pbuf_t *pb, const char *body, const char *body_end);
		int parse_aprs_item(struct pbuf_t *pb, const char *body, const char *body_end);
		int parse_aprs_comment(struct pbuf_t* pb, char const* input, unsigned int const input_len);
		char* parse_remove_part(char const* input, unsigned int const input_len, unsigned int const part_so, unsigned int const part_eo, unsigned int* result_len);
		int parse_aprs_wx(struct pbuf_t* pb, char const* input, unsigned int const input_len);
		int is_number(char const* input);
		uint8_t pkgType(const char* raw);
		size_t getNumberUntil(char const* input,char *output,size_t length);
		int parse_aprs_wave(struct pbuf_t *pb, char const *input, unsigned int const input_len);
};

#endif
