nakhonthai/ESP32IGate/src/igate.cpp

/*
 Name:		ESP32APRS
 Created:	13-10-2023 14:27:23
 Author:	HS5TQA/Atten
 Github:	https://github.com/nakhonthai
 Facebook:	https://www.facebook.com/atten
 Support IS: host:aprs.dprns.com port:14580 or aprs.hs5tqa.ampr.org:14580
 Support IS monitor: http://aprs.dprns.com:14501 or http://aprs.hs5tqa.ampr.org:14501
*/

#include "igate.h"

extern WiFiClient aprsClient;
extern Configuration config;
extern statusType status;

int igateProcess(AX25Msg &Packet)
{
    int idx;
    String header;

    if (Packet.len < 2)
    {
        status.dropCount++;
        return 0; // NO INFO DATA
    }

    for (idx = 0; idx < Packet.rpt_count; idx++)
    {
        if (!strncmp(&Packet.rpt_list[idx].call[0], "RFONLY", 6))
        {
            status.dropCount++;
            return 0;
        }
    }

    for (idx = 0; idx < Packet.rpt_count; idx++)
    {
        if (!strncmp(&Packet.rpt_list[idx].call[0], "TCPIP", 5))
        {
            status.dropCount++;
            return 0;
        }
    }

    for (idx = 0; idx < Packet.rpt_count; idx++)
    {
        if (!strncmp(&Packet.rpt_list[idx].call[0], "qA", 2))
        {
            status.dropCount++;
            return 0;
        }
    }

    for (idx = 0; idx < Packet.rpt_count; idx++)
    {
        if (!strncmp(&Packet.rpt_list[idx].call[0], "NOGATE", 6))
        {
            status.dropCount++;
            return 0;
        }
    }

    // NONE Repeat from sattelite repeater
    for (idx = 0; idx < Packet.rpt_count; idx++)
    {
        if (!strncmp(&Packet.rpt_list[idx].call[0], "RS0ISS", 6)) // Repeat from ISS
        {
            if (strchr(&Packet.rpt_list[idx].call[5], '*') == NULL)
            {
                status.dropCount++;
                return 0;
            }
        }
        if (!strncmp(&Packet.rpt_list[idx].call[0], "YBOX", 4)) // Repeat from LAPAN-A2
        {
            if (strchr(&Packet.rpt_list[idx].call[3], '*') == NULL)
            {
                status.dropCount++;
                return 0;
            }
        }
        if (!strncmp(&Packet.rpt_list[idx].call[0], "YBSAT", 5)) // Repeat from LAPAN-A2
        {
            if (strchr(&Packet.rpt_list[idx].call[4], '*') == NULL)
            {
                status.dropCount++;
                return 0;
            }
        }
        if (!strncmp(&Packet.rpt_list[idx].call[0], "PSAT", 4)) // Repeat from PSAT2-1
        {
            if (strchr(&Packet.rpt_list[idx].call[3], '*') == NULL)
            {
                status.dropCount++;
                return 0;
            }
        }
        if (!strncmp(&Packet.rpt_list[idx].call[0], "W3ADO", 5)) // Repeat from PCSAT-1
        {
            if (strchr(&Packet.rpt_list[idx].call[4], '*') == NULL)
            {
                status.dropCount++;
                return 0;
            }
        }
        if (!strncmp(&Packet.rpt_list[idx].call[0], "BJ1SI", 5)) // Repeat from LilacSat-2
        {
            if (strchr(&Packet.rpt_list[idx].call[4], '*') == NULL)
            {
                status.dropCount++;
                return 0;
            }
        }
    }

    header = String(Packet.src.call);
    if (Packet.src.ssid > 0)
    {
        header += String(F("-"));
        header += String(Packet.src.ssid);
    }
    header += String(F(">"));
    header += String(Packet.dst.call);
    if (Packet.dst.ssid > 0)
    {
        header += String(F("-"));
        header += String(Packet.dst.ssid);
    }

    // Add Path
    for (int i = 0; i < Packet.rpt_count; i++)
    {
        header += String(",");
        header += String(Packet.rpt_list[i].call);
        if (Packet.rpt_list[i].ssid > 0)
        {
            header += String("-");
            header += String(Packet.rpt_list[i].ssid);
        }
        if (Packet.rpt_flags & (1 << i))
            header += "*";
    }

    if (strlen((const char *)config.igate_object) >= 3)
    {
        header += "," + String(config.aprs_mycall);
        if (config.aprs_ssid > 0)
        {
            header += String(F("-"));
            header += String(config.aprs_ssid);
        }
        header += "*,qAO," + String(config.igate_object);
    }
    else
    {
        // Add qAR,callSSID: qAR - Packet is placed on APRS-IS by an IGate from RF
        header += String(F(",qAR,"));
        header += String(config.aprs_mycall);
        if (config.aprs_ssid > 0)
        {
            header += String(F("-"));
            header += String(config.aprs_ssid);
        }
    }

    // Add Information
    header += String(F(":"));
    uint8_t *Raw = (uint8_t *)calloc(500,sizeof(uint8_t));
    if (Raw)
    {
        memset(Raw, 0, 500); // Clear frame packet
        size_t hSize = strlen(header.c_str());
        memcpy(&Raw[0], header.c_str(), hSize);           // Copy header to frame packet
        memcpy(&Raw[hSize], &Packet.info[0], Packet.len); // Copy info to frame packet
        uint8_t *ptr = &Raw[0];
        int i, rmv = 0;
        size_t fsize=hSize + Packet.len;        
        // Remove CR,LF in frame packet
        for (i = 0; i < fsize; i++)
        {
            if ((Raw[i] == '\r') || (Raw[i] == '\n'))
            {
                ptr++;
                rmv++;
            }
            else
            {
                Raw[i] = *ptr++;
            }
            if(i>(fsize-rmv)){
                i=fsize-rmv;
                break;
            }
        }
        if(i>500 || i>fsize) i=strlen((char*)Raw);
        log_d("RF2INET: %s", Raw);
        if(aprsClient.connected()){
            aprsClient.write(&Raw[0], i); // Send binary frame packet to APRS-IS (aprsc)
            aprsClient.write("\r\n");     // Send CR LF the end frame packet
        }
        status.txCount++;
        free(Raw);
        log_d("Send TCP Finish!");
    }
    return 1;
}
