nakhonthai/ESP32IGate/(commit log)

2022-01-19 ๊Update R10 to 33K
2022-01-19 Reduce RAM and edit bug webservice
    [main.cpp]
2022-01-20 add link CAD data
2022-01-24 ๊Update Manual DIY
2022-01-24 Add WiFi AP Config and edit bug Update Firmware has fail.
    [main.cpp, webservice.cpp, webservice.h]
2022-03-07 Add Test Mode and WiFi Power
2022-04-13 Edit bug send to aprsc
    [igate.cpp, main.cpp, main.h, webservice.cpp]
2022-06-06 Add TimeZone and VPN Wireguard
2022-06-30 ignore frames with NOGATE
2023-07-16 Add ESP32DR_SA868 hardware
2023-08-05 Edit bug fifo buffer overflow.
    [main.cpp, main.h]
2023-11-22 Add interface of sensor
2023-11-23 Fix tag html in webservice
    [main.cpp, main.h, weather.h, webservice.cpp]
2023-11-25 Fix telemetry bits active
    [main.cpp]
2023-12-25 Update pic and fix
    [main.cpp, main.h]
2023-12-31 Fix Serial GPIO and Fix Tracker Mode
    [main.cpp, main.h, weather.cpp, weather.h, webservice.cpp]
2024-01-01 Fix WiFi AP Connected not rescan WiFi i multiclient
    [main.cpp, main.h]
2024-01-30 Fix TX send check receving
    [main.cpp, main.h]
2024-01-31 Edit share project ESP32DR_SA868
2024-04-08 Fix crash and reboot
    [digirepeater.cpp, igate.cpp, main.cpp, main.h, weather.cpp, webservice.cpp]
